vicholz/openald/README.md

# OpenALD v1.0

**OpenALD** is an open, rechargeable pocket FM radio: an ATmega328PB + RDA5807M (RRD-102 module) board that runs from one
18650 cell, charges and programs over a centred USB-C port, and lives in a 3D-printed 43 × 92 × 33.4 mm case. The repo also
holds an **Adafruit Feather RP2040 variant** built from off-the-shelf boards, and a **6-slot USB-C PD charging dock** that
fits both radios. Everything is KiCad 9 + OpenSCAD, generated by Python scripts.

> **Status: designed, CAD- and datasheet-checked, NOT built and NOT hardware-validated.** ERC/DRC, the JLC placement
> check and the 3D case-fit checks pass, but no board has been built, powered or programmed. The only firmware is the Feather variant's Arduino sketch, which compiles but has never run on hardware; the single board still has none.
> Treat the first build of each part as a prototype (see the bring-up checklist in [HANDOFF.md](HANDOFF.md#8-hardware-bring-up-test-checklist)).

**Picking this up later (person or AI)? Start with [HANDOFF.md](HANDOFF.md)**: full design history, decisions, hard
constraints, open TODOs, test checklist and exact regeneration commands.

| Folder | What it is | Status |
|---|---|---|
| [`radio_single_board/`](radio_single_board/README.md) | **OpenALD v1.0** single-board radio: ATmega328PB + RDA5807M, CH340K USB-C programming, TP4056 ~900 mA charging with DW01A/FS8205A protection and reverse-cell protection, thumbwheel (press = battery check), slide switch, centred vertical 3-LED level bar. 38 × 87 mm 2-layer PCB; case 43 × 92 × 33.4 mm | Designed; ERC/DRC/JLC-CPL/case fit pass; not built |
| [`charging_dock/`](charging_dock/README.md) | **OpenALD Dock v1.0**: 6 radios (2 × 3, 1 in apart) stand USB-C-down in 2 in pockets; one rear USB-C PD input (≥ 45 W charger, 15 V or 20 V); HUSB238 + 2 × SY8205 bucks + SY6280 limit per slot. 192 × 112 × 62.5 mm | Designed; ERC/DRC/JLC-CPL/fit pass; not built |
| [`radio_adafruit_feather_rp2040/`](radio_adafruit_feather_rp2040/README.md) | **OpenALD Feather RP2040 v1.0**: Feather RP2040 + RDA5807M breakout with jack + 18650 holder in a printed frame; **no PCB**: SIQ-02FVS3 wheel glued into a frame cradle, screwless SS-12F16 switch pressed into a groove in the case wall, frame clamped between the case halves, all hand-wired; same dock footprint at the base | Designed; fit check pass; FM-module dimensions are estimates; not built |

Dock ↔ radio mechanical contract: [`charging_dock/DOCK_INTERFACE.md`](charging_dock/DOCK_INTERFACE.md).

## Quick links
* Single-board radio: [Gerbers](radio_single_board/fab/openald-gerbers-jlcpcb.zip) · [JLC BOM](radio_single_board/fab/openald-BOM-jlcpcb.csv) · [JLC CPL](radio_single_board/fab/openald-CPL-jlcpcb.csv) · [human BOM](radio_single_board/fab/openald-BOM-human.csv) · [minimal (4-part) assembly set](radio_single_board/fab/minimal/) · [PCBWay BOM](radio_single_board/fab/openald-BOM-pcbway.xlsx) · [NextPCB BOM](radio_single_board/fab/openald-BOM-nextpcb.xls) · [schematic PDF](radio_single_board/docs/openald-schematic.pdf) · [case STLs](radio_single_board/case/)
* Dock: [Gerbers](charging_dock/fab/openald-dock-gerbers-jlcpcb.zip) · [JLC BOM](charging_dock/fab/openald-dock-BOM-jlcpcb.csv) · [JLC CPL](charging_dock/fab/openald-dock-CPL-jlcpcb.csv) · [human BOM](charging_dock/fab/openald-dock-BOM-human.csv) · [schematic PDF](charging_dock/docs/openald-dock-schematic.pdf) · [case STLs](charging_dock/case/)
* Feather variant: [BOM](radio_adafruit_feather_rp2040/docs/BOM.md) · [pin map](radio_adafruit_feather_rp2040/docs/pin_map.md) · [wiring diagram](radio_adafruit_feather_rp2040/docs/wiring_diagram.png) · [wiring schematic PDF](radio_adafruit_feather_rp2040/docs/wiring_schematic/openald-feather-wiring.pdf) · [firmware](radio_adafruit_feather_rp2040/firmware/) · [firmware notes](radio_adafruit_feather_rp2040/docs/firmware_notes.md) · [case STLs](radio_adafruit_feather_rp2040/case/stl/)
* Ready-made zip packages per subproject: GitHub Release **v1.0** assets (or build them with `tools/make_packages.sh`).

## How to order (JLCPCB)
**Board settings for every board:** 2 layers, **1.6 mm** FR-4, **1 oz** copper, any colour, HASL lead-free (or ENIG),
**PCB Assembly: Economic, top side**. Upload the gerber zip from the subproject's `fab/`, then the `*-BOM-jlcpcb.csv` and
`*-CPL-jlcpcb.csv`. Use the centroid `.csv` or `.pos` only if a site asks for those formats.

* **Check every part's rotation in JLC's placement preview before paying.** The CPLs already contain per-part EasyEDA
  origin/rotation corrections (`JLC_CORR`, verified by `jlc_cpl_fit.py --check`), so the preview should be right; JLC
  engineers sometimes re-rotate by hand.
* Single-board radio: U4 (RRD-102 module), BT1 (18650 holder) and J3 (ISP pads, do not fit) are hand-solder/DNP.
  SW1 (SK-12E12-G5) is THT: choose Standard PCBA to have JLC fit it, or deselect it and hand-solder (5 joints).
  If the ATmega328PB (C132230) is low/out of stock, use **ATmega328P-AU (C14877)**, a drop-in (pick the 328P variant in MiniCore).
* **Minimal assembly option** (you have hot air/hotplate): upload the same gerbers with
  `radio_single_board/fab/minimal/openald-BOM-jlcpcb-minimal.csv` + `openald-CPL-jlcpcb-minimal.csv`. JLC places only
  J1 (USB-C), U1 (TP4056), U3 (ATmega328PB) and U7 (CH340K); buy the rest from LCSC with
  `fab/minimal/openald-LCSC-order-handsolder.csv` (5 boards + labelled spares). Order a separate **frameless** stencil
  (~$3) if you want one for hand paste.
* Dock: the six vertical USB-C plugs J2–J7 (HX TYPE C-M 16P V-SMT, **LCSC C55200592, low stock**) are hand-soldered; buy 7.
* Other vendors (PCBWay/NextPCB) have filled BOM templates, but **the CPL/placement files contain JLC-specific
  corrections**; generate a clean placement file before using another assembler (see HANDOFF §6).
* Cost figures in the docs are **estimates from published price tables (2026-11-10/11)**, not quotes.

## How to regenerate / check
Tested with: **KiCad 9.0.2** (`kicad-cli` + `pcbnew` Python module), **OpenSCAD 2021.01**, **Python 3.13**,
Freerouting (2026-10 build, Java 21+; run with OpenJDK 25) for re-routing only. Python packages: see
[`requirements.txt`](requirements.txt) (`pcbnew` comes with KiCad, not pip).

```bash
pip install -r requirements.txt
tools/fetch_kicad3d.sh && export KICAD9_3DMODEL_DIR=$PWD/tools/kicad3d   # stock KiCad STEP models for the fit checks
tools/check_all.sh            # ERC + DRC + JLC CPL check for all three boards (non-destructive, ~10 s)
tools/check_all.sh --case     # + rebuild cases and run the 3D fit checks (slow; rewrites STLs/previews)
```
Per subproject (details and expected results in [HANDOFF.md §7](HANDOFF.md#7-regeneration-and-checks)):
* `radio_single_board/scripts/run_all_pcb.sh` (full schematic → board → **re-route** → DRC; needs Freerouting),
  `python3 scripts/make_fab.py` / `--minimal`, `python3 scripts/make_vendor_boms.py`, `scripts/build_case.sh`.
* `charging_dock/scripts/run_all_pcb.sh`, `python3 scripts/make_fab.py`, `scripts/build_case.sh`.
* `radio_adafruit_feather_rp2040/make_all.sh` (everything) or `case/build_case.sh` (case only).
* `OPENALD_OFFLINE=1` makes `make_fab.py` reuse the saved `fab/lcsc_lookup.json` prices instead of querying JLC's parts API.
* `FREEROUTING=/path/freerouting.jar` and `JAVA=/path/java` override the router location (default `tools/freerouting.jar`, not in git).
* `EASYEDA_CACHE` overrides the EasyEDA footprint cache used by `jlc_cpl_fit.py` (default: the committed `tools/easyeda/`).

## Directory map
```
README.md            this file            HANDOFF.md        full resume / handoff document
LICENSE              CC0 1.0 Universal    requirements.txt  Python deps
tools/               check_all.sh, fetch_kicad3d.sh, make_packages.sh, easyeda/ (EasyEDA footprint cache for jlc_cpl_fit)
radio_single_board/  kicad/ fab/ (gerbers, JLC BOM/CPL, centroid, .pos, vendor BOMs, minimal/) case/ previews/ docs/ scripts/
charging_dock/       kicad/ fab/ case/ (STLs, floor_pads/) previews/ docs/ scripts/ DOCK_INTERFACE.md
radio_adafruit_feather_rp2040/  case/ (stl/) previews/ docs/ scripts/ ref/ (Adafruit Eagle board, CC BY-SA) archive/ (retired PCB) make_all.sh
```

## License
Released into the public domain under **CC0 1.0 Universal** ([LICENSE](LICENSE)): hardware designs, scripts and docs.
Third-party reference files keep their own licenses (notably the Adafruit Feather RP2040 Eagle file in
`radio_adafruit_feather_rp2040/ref/`, CC BY-SA); see [HANDOFF.md §11](HANDOFF.md#11-license-and-third-party-files).
