vicholz/openald/charging_dock/README.md

# OpenALD Dock v1.0 — 6-slot USB-C charging dock

A charging dock for six OpenALD radios (2 rows × 3). Each radio stands USB-C-end down in a printed pocket that is
**2.00 in (50.8 mm) deep**, so the level-bar LEDs stay visible. A lead-in chamfer and a tight 0.35 mm guide zone at
the bottom centre the radio's USB-C receptacle on a vertical USB-C plug. **One USB-C PD input at the rear centre**
powers all six slots.

> **Status: design only, nothing here is hardware-validated.** ERC/DRC are clean and the CAD fit check passes, but no
> board has been built, no charger has been tested, and the plug height and insertion have not been measured on a
> real part. Treat the first build as a prototype.

Both radio variants fit the same pockets (`radio_single_board`, and `radio_adafruit_feather_rp2040` if it keeps the
lower envelope). The exact interface is in **[DOCK_INTERFACE.md](DOCK_INTERFACE.md)**.

**Plug depth (2026-11-12, still v1.0):** both radios now have their USB-C mouth **1.60 mm inside the bottom face** (the
Feather since commit 1452af8; the single board since its J1 moved 0.9 mm toward the board edge). The floor pads are
**4.00 mm** (were 3.10) and the PCB standoffs **4.1 mm** (were 5.0), so the plug goes **6.0 mm** past the mouth on both
radios (USB-C full seat 6.20 ± 0.20) while the outer size, the 50.8 mm pocket and the deck height stay the same. The
short-lived Feather riser shims (commit 0ba4451) are gone. Section view: `previews/dock_plug_insertion_per_radio.png`.
**Radios built before this change** (single board with J1 flush to the board edge, mouth 2.50) would only get 5.1 mm in this dock.

## Key numbers
| | |
|---|---|
| Outer size | **191.8 × 111.7 × 62.5 mm** (W × D × H) |
| Spacing | **25.4 mm (1.0 in)** between radios, in both X and Y |
| Pocket | 50.8 deep; 0.35 mm/side clearance for the bottom 12 mm, 0.60 above; 3 mm 45° lead-in; power-switch knob relief slot in the right wall |
| PCB | 186.0 × 105.9 mm, 2-layer, 1.6 mm, all SMT parts on top |
| Minimum charger | **USB-C PD, 45 W: must offer 20 V ≥ 2.25 A or 15 V ≥ 3 A** |
| Per-slot limit | ~1.45 A (1.09–1.81 A, SY6280 ±25 %), 5.10 V |
| Print bed | needs ≥ 192 × 112 mm for the top shell (fits 220 × 220 beds; not an A1 mini) |

## Power architecture
```
USB-C IN (J1, HRO TYPE-C-31-M-12, CC1/CC2 -> HUSB238)
  -> F1 4 A fuse (0466004.NRHF) -> D1 SMBJ22A TVS -> C1 10 uF 50 V
  -> Q1 AO4407A P-FET input switch (gate: R2 100k / R3 47k / C3 4.7 nF soft turn-on, driven by HUSB238 GATE; opens on OVP)
  -> VIN_SW, C4 100 uF 35 V
     -> U2 SY8205FCC buck A (4.7 uH MWSA0604S, 3x22 uF + 470 uF, 75k/10k -> 5.10 V) -> slots 1, 2, 4
     -> U3 SY8205FCC buck B (same)                                                   -> slots 3, 5, 6
        each slot: SY6280AAC current-limited switch (Rset 4.7k -> ~1.45 A) + 10 uF -> vertical plug VBUS,
        22k Rp on CC ("default USB power" to the radio's 5.1k Rd), plug GND + shell to GND
Status LED (light pipe in the deck between the centre pockets): green = 5 V up; red = input present but no usable PD
```
* **HUSB238** (VSET open = request up to 20 V, ISET 13.7k = 2.25 A) picks the highest PDO ≤ 20 V that offers ≥ 2.25 A,
  otherwise it steps down. D+/D− are left open (PD only).
* **Buck enable threshold:** EN divider 100k/12k from VIN_SW. The bucks turn on at 11.2–13.1 V (typ. 12.1 V). **5 V and
  9 V never enable them** (non-PD or 5 V-only chargers are safe: the dock stays off with the red LED lit). 15 V and
  20 V always enable them. **12 V-only chargers are not supported** (they may or may not start).
* Worst-case load is 6 × ~0.95 A × 5.1 V ≈ 29 W. At 20 V/2.25 A (45 W) there is about 35 % headroom after converter
  losses. Each buck is rated 5 A and carries ≤ 3 radios.

| Part | LCSC | Stock (2026-11-11 PST) | Unit |
|---|---|---|---|
| HUSB238_002DD PD sink | C7471904 | 17,771 | $0.47 |
| SY8205FCC buck ×2 | C111875 | 10,557 | $0.34 |
| SY6280AAC slot switch ×6 | C55136 | 97,877 | $0.09 |
| AO4407A input P-FET | C16072 | 19,166 | $0.33 |
| MWSA0604S-4R7MT 4.7 µH 7 A ×2 | C408457 | 8,136 | $0.17 |
| 0466004.NRHF 4 A fuse | C187596 | 14,764 | $0.08 |
| SMBJ22A TVS | C151920 | 7,664 | $0.07 |
| 100 µF 35 V / 470 µF 10 V electrolytic | C2895269 / C2858856 | 5,149 / 138,705 | $0.12 / $0.05 |
| HRO TYPE-C-31-M-12 input receptacle | C165948 | 281,637 | $0.19 |
| HX TYPE C-M 16P V-SMT vertical plug ×6 (hand solder) | C55200592 | **782** | $0.54 |

The full list is in `fab/openald-dock-BOM-human.csv` (live stock and price); `fab/cost_estimate.txt` has the cost estimate.

## Files
| Path | What |
|---|---|
| `kicad/openald-dock.kicad_{pro,sch,pcb}` | KiCad 9 project (schematic and board are generated by the scripts) |
| `fab/openald-dock-gerbers-jlcpcb.zip` | Gerbers + drill (JLCPCB) |
| `fab/openald-dock-BOM-jlcpcb.csv`, `fab/openald-dock-CPL-jlcpcb.csv` | JLC assembly BOM + CPL (JLC_CORR rotation/offset corrections applied) |
| `fab/openald-dock-centroid.csv`, `fab/openald-dock.pos` | Centroid / KiCad position files |
| `fab/openald-dock-BOM-human.csv`, `fab/cost_estimate.txt`, `fab/lcsc_lookup.json` | Human BOM with live stock and prices, cost estimate |
| `fab/erc_report.txt`, `fab/drc_report.txt`, `fab/jlc_cpl_fit.json` | Check reports |
| `case/openald_dock.scad`, `case/dock_params.scad` | OpenSCAD case (parameters generated from the PCB layout) |
| `case/dock_top_shell.stl`, `case/dock_base.stl`, `case/dock_floor_pads_x6.stl`, `case/floor_pads/*.stl` | Print-ready STLs (already in print orientation) |
| `case/dock_fit_report.txt` | Fit-check result |
| `docs/openald-dock-schematic.pdf`, `previews/*.png` | Schematic PDF, PCB/case renders, CPL overlay plots |
| `scripts/` | Generators: `run_all_pcb.sh` (symbols → schematic → ERC → board → route → post-route → DRC), `make_fab.py`, `jlc_cpl_fit.py`, `build_case.sh`, `check_dock_fit.py`, `render_pcb_previews.py`; `geom.py` is the single source of the geometry |

## Checks (2026-11-11)
* **ERC:** 0 errors, 0 warnings.
* **DRC:** 0 errors, **0 unconnected**. 75 silkscreen-only warnings (reference text overlapping copper, other silk or the board edge; cosmetic).
* **JLC placement:** `jlc_cpl_fit.py --check` → *correction table: OK*. All 80 CPL rows match the EasyEDA footprints' pads; worst pad-centre offset is 0.29 mm (SY8205 land-length difference). Overlays are in `previews/cpl_overlay_*.png`.
* **Case fit:** `case/dock_fit_report.txt` → **INTERFERENCES: 0**. This covers radio envelopes vs. shell/pads/base, plugs vs. case and radios (the plug sits inside the USB-C cavity), the PCB with its holes vs. every case part, every PCB part vs. every case part, and the case parts against each other. The closest part to the shell is the D3 LED, 0.19 mm under the light pipe. Insertion is 6.0 mm. The report lists the insertion per radio (6.00 / 6.00) and the Z stack.

## Printing (no supports)
* **Top shell:** print it deck-down, as exported. Walls, bosses, the light pipe and the pocket tubes grow straight up. The lead-in chamfers are 45°. Vent slots and the rear USB-C opening bridge ≤ 13 mm.
* **Base:** print it flat, as exported.
* **Floor pads (6):** print them top-face down, as exported (pegs up). Slot 5 (back centre) has its own STL with a relief over the rear USB-C receptacle's pads. The pads are interchangeable otherwise, but `floor_pads/` has one file per slot.
* PETG or PLA, 0.2 mm layers, 3 walls. Check the pocket guide on one radio before printing all six pads. If the fit is tight, the guide clearance is `CLR_GUIDE` in `scripts/geom.py`.

## Assembly
1. **Order the PCB** with JLC SMT assembly (gerber zip + BOM + CPL). The six vertical plugs J2–J7 are **not** in the JLC BOM, because LCSC has no EasyEDA footprint for C55200592 and JLC cannot verify its placement. Buy 6 (+1 spare) from LCSC and hand-solder them. They are 16 fine-pitch (0.8 mm) SMD pads plus 2 plated shell slots: use flux, a fine tip or hot air, and keep each plug **vertical** (a printed floor pad slipped over it works as a jig).
2. **Test before docking a radio:** plug in a ≥ 45 W PD charger. Green should light and red should stay off. Each slot should read 5.0–5.2 V on VBUS. A 5 V-only charger should give red only, with no slot voltage.
3. Press 6 M3 heat-set inserts into the shell bosses. Lay the PCB on the base standoffs and drop the six floor pads in (the pegs go into the PCB holes). Lower the shell over everything and fit 6 × **M3 × 10** screws from below (the standoffs are 4.1 mm since 2026-11-12; M3 × 12 would bottom out in the 6.5 mm insert holes).
4. Dock a radio front face (level-bar side) toward you, wheel to the right.

## Open risks and judgment calls
* **Plug height and insertion are not measured.** The HX drawing gives 11.60 (used here, 6.0 mm insertion) but also a 12.50 overall (possibly including the shell tabs that go through the board; not confirmed). Measure a soldered plug from the PCB top. If it is taller, the radios would stand on the plug: make `PAD_T` thicker and `STANDOFF` thinner by the difference in `scripts/geom.py` and rebuild (shorter screws again).
* **Receptacle depth:** the real seat depth of the HRO and CUI receptacles isn't on their drawings; 6.20 ± 0.20 is the USB-C spec value. Both radios must keep the 1.60 mm mouth; an older single board (mouth 2.50) only gets 5.1 mm.
* **Hand-soldered plugs:** fine pitch, and the plug must be perpendicular. The 0.35 mm guide clearance plus the case opening tolerate only ~0.5 mm of plug misalignment.
* **Plug supply:** only 782 in stock at LCSC, and it is the only in-stock vertical (board-mount, plug-up) USB-C plug found with a usable drawing. Buy spares early.
* **12 V fallback:** 12 V-only chargers are deliberately not supported. A 30 W charger that offers 12 V/2.5 A may or may not start the dock and could overload with six radios charging.
* **Autorouted power layout:** routing is Freerouting plus scripted widening of the high-current tracks (up to 2 mm) and GND pours on both layers. Review the buck hot loops (C11/C12 → U2/U3 → GND) in `previews/pcb_copper_*.png` before ordering.
* **Heat:** six radios charging inside 2 in pockets. Each pocket wall has vent slots into the open channels, and the deck and base are vented, but there is no fan. Watch radio temperature on the first full charge.
* **Viewing angle:** the single-board radio's level bar is centred on its front face, its three windows 27.0 / 29.8 / 32.6 mm above the rim (2026-11-11 update; see `DOCK_INTERFACE.md` §1). The back-row bars are best read from above or from the front at a downward angle.
* **While docked:** the radio's own TP4056 charge LEDs (D3/D4, near the USB end) are hidden. Charging is shown on the level bar by firmware (it reads CHRG_SENSE). The power switch is not reachable while docked; the relief slot in the right wall only clears the knob so it isn't flipped by insertion.
* **Layout margins:** the back margin is 13.5 mm (instead of 6) to fit the rear USB-C receptacle behind the back-centre pocket. The 25.4 mm spacing leaves channels wide enough for the electronics.
* **Not validated:** HUSB238 negotiation, buck stability with the chosen compensation (internal), SY6280 limits, thermals and plug mating are all untested.

## History
* v1.0 (2026-11-11): first design. The project was renamed from OpenALS to OpenALD before release, so the dock was born as "OpenALD Dock v1.0".
