vicholz/openald/charging_dock/case/dock_fit_report.txt

ok   radios x shell_raw                             0.000 mm^3
ok   plugs x shell_raw                              0.000 mm^3
ok   PCB x shell_raw                                0.000 mm^3
ok   radios x base_raw                              0.000 mm^3
ok   plugs x base_raw                               0.000 mm^3
ok   PCB x base_raw                                 0.000 mm^3
ok   radios x pads_raw                              0.000 mm^3
ok   plugs x pads_raw                               0.000 mm^3
ok   PCB x pads_raw                                 0.000 mm^3
ok   plugs x radios (plug inside USB-C cavity)      0.000 mm^3
ok   shell x pads                                   0.000 mm^3
ok   shell x base                                   0.000 mm^3
ok   pads x base                                    0.000 mm^3
closest PCB part to the top shell: D3 at 0.19 mm (part boxes)
insertion past the receptacle mouth: 6.00 mm (plug top Z 19.30, radio floor Z 11.70)
  single_board receptacle mouth 1.60 inside the bottom face -> insertion 6.00 mm
  feather      receptacle mouth 1.60 inside the bottom face -> insertion 6.00 mm
  USB-C full seat (spec effective receptacle shell) 6.20 +/- 0.20; design target 6.00
Z stack: base 2.0, standoff 4.1, PCB 6.10..7.70, pad 4.00 -> floor 11.70, plug top 19.30, deck 62.50
radio-to-guide clearance 0.35/side for 12 mm, 0.60/side above; pocket depth 50.8
outer size 191.8 x 111.72 x 62.5 mm; radio gap 25.4 mm
INTERFERENCES: 0
