vicholz/openald/radio_single_board/case/case_fit_report.txt

BT1   x   8.55.. 29.45  y   8.43.. 86.13  z -19.09..  3.12
C1    x  32.98.. 34.23  y   8.40.. 10.40  z   1.59..  2.85
C10   x  18.80.. 20.40  y  65.40.. 68.60  z   1.59..  3.19
C11   x  21.80.. 23.40  y  65.40.. 68.60  z   1.59..  3.19
C12   x   3.80..  4.60  y  77.60.. 79.20  z   1.59..  2.40
C13   x  17.80.. 19.40  y  38.90.. 39.70  z   1.59..  2.40
C14   x  17.80.. 19.40  y  40.60.. 41.40  z   1.59..  2.40
C15   x  33.20.. 34.00  y  12.30.. 13.90  z   1.59..  2.40
C16   x  25.40.. 26.20  y  11.60.. 13.20  z   1.59..  2.40
C17   x  23.90.. 24.70  y  21.60.. 23.20  z   1.59..  2.40
C18   x  29.80.. 30.60  y  21.60.. 23.20  z   1.59..  2.40
C19   x   7.90..  8.70  y  48.80.. 50.40  z   1.59..  2.40
C2    x   7.00..  9.00  y  19.77.. 21.02  z   1.59..  2.85
C3    x  32.60.. 34.20  y  73.70.. 74.50  z   1.59..  2.40
C4    x  18.80.. 19.60  y  35.70.. 37.30  z   1.59..  2.40
C5    x  24.40.. 25.20  y  35.70.. 37.30  z   1.59..  2.40
C6    x  17.80.. 19.40  y  42.30.. 43.10  z   1.59..  2.40
C7    x   4.80..  5.60  y  40.70.. 42.30  z   1.59..  2.40
C8    x   4.60..  6.60  y  54.58.. 55.83  z   1.59..  2.85
C9    x   8.40.. 10.00  y  55.00.. 55.80  z   1.59..  2.40
D1    x  18.20.. 19.80  y  72.60.. 73.40  z   1.59..  2.69
D10   x  26.10.. 29.90  y  29.90.. 31.50  z   1.59..  2.85
D2    x  20.10.. 23.90  y  29.70.. 31.30  z   1.59..  2.85
D3    x   6.60..  8.20  y   4.80..  5.60  z   1.59..  2.69
D4    x  10.60.. 12.20  y   4.80..  5.60  z   1.59..  2.69
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
ASSEMBLY SW1   reaches past the inner wall (x 38.50..43.30 y 20.00..23.50 z 3.85..6.35): top half lowers past it: OK
ASSEMBLY SW3   reaches past the inner wall (x 38.50..40.85 y 55.70..66.30 z 3.60..5.60): top half lowers past it: OK
INTERFERENCES: 0
