vicholz/openald/radio_single_board/fab/drc_report.txt

** Drc report for openald.kicad_pcb **
** Created on 2026-11-12T17:15:41-0800 **

** Found 62 DRC violations **
[silk_edge_clearance]: Silkscreen clipped by board edge
    Rule: board setup constraints silk; warning
    @(103.0000 mm, 100.0000 mm): Segment on Edge.Cuts
    @(108.8800 mm, 101.9300 mm): Segment of J2 on F.Silkscreen
[silk_edge_clearance]: Silkscreen clipped by board edge
    Rule: board setup constraints silk; warning
    @(103.0000 mm, 100.0000 mm): Segment on Edge.Cuts
    @(114.1200 mm, 99.9300 mm): Segment of J2 on F.Silkscreen
[silk_edge_clearance]: Silkscreen clipped by board edge
    Rule: board setup constraints silk; warning
    @(103.0000 mm, 103.0000 mm): Arc on Edge.Cuts
    @(103.2000 mm, 100.0500 mm): Reference field of H1
[silk_edge_clearance]: Silkscreen clipped by board edge
    Rule: board setup constraints silk; warning
    @(135.0000 mm, 103.0000 mm): Arc on Edge.Cuts
    @(134.8000 mm, 100.0500 mm): Reference field of H2
[silk_edge_clearance]: Silkscreen clipped by board edge
    Rule: board setup constraints silk; warning
    @(135.0000 mm, 187.0000 mm): Segment on Edge.Cuts
    @(114.3000 mm, 186.2500 mm): Segment of J1 on F.Silkscreen
[silk_edge_clearance]: Silkscreen clipped by board edge
    Rule: board setup constraints silk; warning
    @(135.0000 mm, 187.0000 mm): Segment on Edge.Cuts
    @(123.7000 mm, 186.2500 mm): Segment of J1 on F.Silkscreen
[silk_edge_clearance]: Silkscreen clipped by board edge
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
[silk_overlap]: Silkscreen overlap
    Rule: board setup constraints silk; warning
    @(108.8100 mm, 137.5406 mm): Segment of C19 on F.Silkscreen
    @(108.5700 mm, 137.4000 mm): Reference field of R10

** Found 0 unconnected pads **

** Found 0 Footprint errors **

** End of Report **
