vicholz/openald/radio_single_board/fab/erc_report.txt

ERC report (2026-11-12T17:15:00-0800, Encoding UTF8)

***** Sheet /
[pin_to_pin]: Pins of type Bidirectional and Power output are connected
    ; warning
    @(25.40 mm, 248.92 mm): Symbol U3 Pin 3 [PE0, Bidirectional, Line]
    @(172.72 mm, 267.97 mm): Symbol #FLG01 Pin 1 [Power output, Line]
[pin_to_pin]: Pins of type Bidirectional and Power output are connected
    ; warning
    @(25.40 mm, 251.46 mm): Symbol U3 Pin 6 [PE1, Bidirectional, Line]
    @(320.04 mm, 215.90 mm): Symbol U6 Pin 2 [VO, Power output, Line]

 ** ERC messages: 2  Errors 0  Warnings 2
