vicholz/openald/charging_dock/fab/drc_report.txt

** Drc report for openald-dock.kicad_pcb **
** Created on 2026-11-11T20:55:39-0800 **

** Found 75 DRC violations **
[silk_edge_clearance]: Silkscreen clipped by board edge
    Rule: board setup constraints silk; warning
    @(102.0000 mm, 100.0000 mm): Segment on Edge.Cuts
    @(188.3000 mm, 101.6500 mm): Segment of J1 on F.Silkscreen
[silk_edge_clearance]: Silkscreen clipped by board edge
    Rule: board setup constraints silk; warning
    @(102.0000 mm, 100.0000 mm): Segment on Edge.Cuts
    @(197.7000 mm, 101.6500 mm): Segment of J1 on F.Silkscreen
[silk_over_copper]: Silkscreen clipped by solder mask
    Local override; warning
    @(192.3700 mm, 156.7100 mm): Reference field of D3
[silk_over_copper]: Silkscreen clipped by solder mask
    Local override; warning
    @(228.7700 mm, 136.6000 mm): Reference field of C40
[silk_over_copper]: Silkscreen clipped by solder mask
    Local override; warning
    @(163.5700 mm, 136.6000 mm): Reference field of R12
[silk_over_copper]: Silkscreen clipped by solder mask
    Local override; warning
    @(127.8000 mm, 163.1700 mm): Reference field of R61
[silk_over_copper]: Silkscreen clipped by solder mask
    Local override; warning
    @(225.5700 mm, 136.6000 mm): Reference field of R33
[silk_over_copper]: Silkscreen clipped by solder mask
    Local override; warning
    @(231.9700 mm, 136.6000 mm): Reference field of R32
[silk_over_copper]: Silkscreen clipped by solder mask
    Local override; warning
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
    @(124.3627 mm, 149.3225 mm): Segment of R54 on F.Silkscreen
    @(124.6000 mm, 149.0000 mm): Reference field of U7
[silk_overlap]: Silkscreen overlap
    Rule: board setup constraints silk; warning
    @(157.1700 mm, 136.6000 mm): Reference field of R13
    @(157.5100 mm, 136.7406 mm): Segment of C15 on F.Silkscreen
[silk_overlap]: Silkscreen overlap
    Rule: board setup constraints silk; warning
    @(153.7350 mm, 139.6613 mm): Segment of C17 on F.Silkscreen
    @(153.5200 mm, 139.4000 mm): Reference field of C18
[silk_overlap]: Silkscreen overlap
    Rule: board setup constraints silk; warning
    @(158.7700 mm, 136.6000 mm): Reference field of R14
    @(159.1225 mm, 136.8373 mm): Segment of R13 on F.Silkscreen
[silk_overlap]: Silkscreen overlap
    Rule: board setup constraints silk; warning
    @(160.3700 mm, 136.6000 mm): Reference field of C20
    @(161.4000 mm, 137.8500 mm): Reference field of C19
[silk_overlap]: Silkscreen overlap
    Rule: board setup constraints silk; warning
    @(160.3700 mm, 136.6000 mm): Reference field of C20
    @(160.7225 mm, 136.8373 mm): Segment of R14 on F.Silkscreen

** Found 0 unconnected pads **

** Found 0 Footprint errors **

** End of Report **
