vicholz/openald/charging_dock/previews/cpl_overlay_J1.png

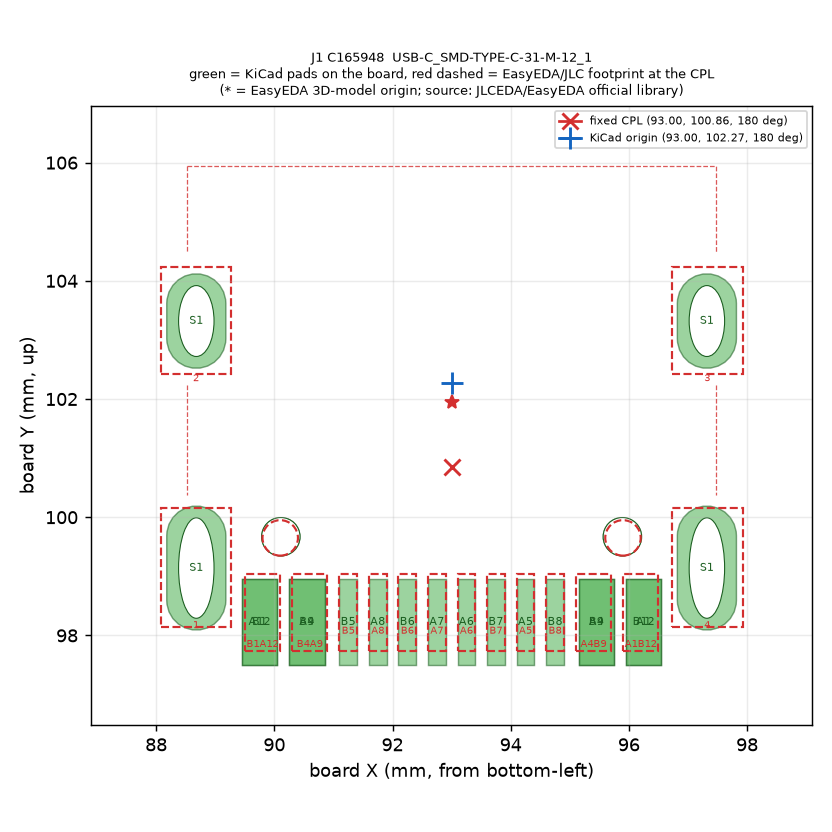
charging_dock/previews/cpl_overlay_J1.png
