vicholz/openald/charging_dock/previews/cpl_overlay_Q1.png

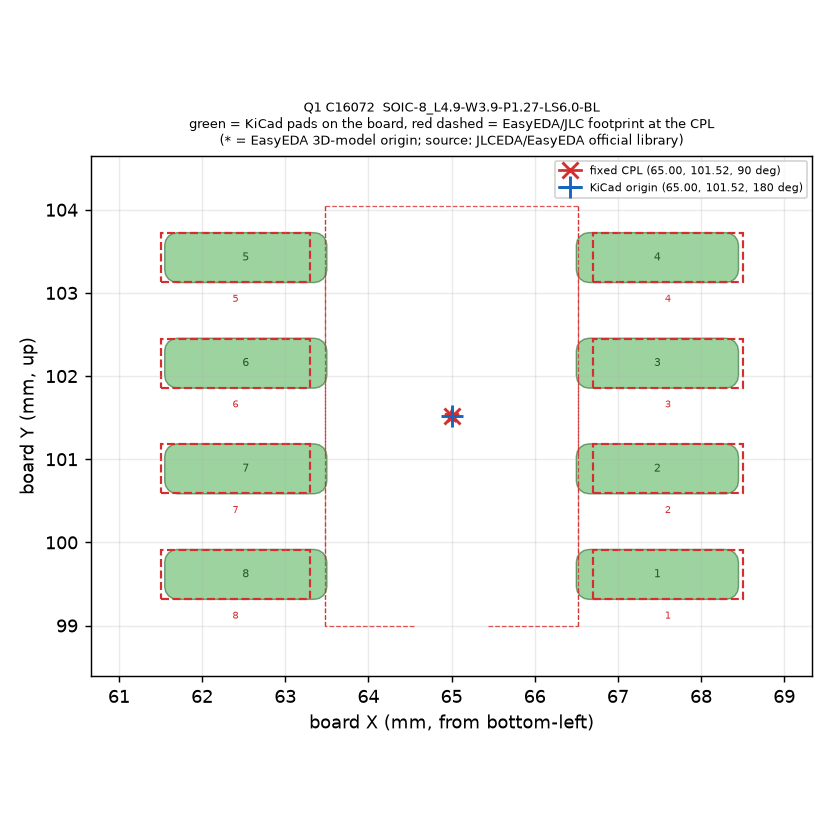
charging_dock/previews/cpl_overlay_Q1.png
