vicholz/openald/charging_dock/previews/cpl_overlay_Q2.png

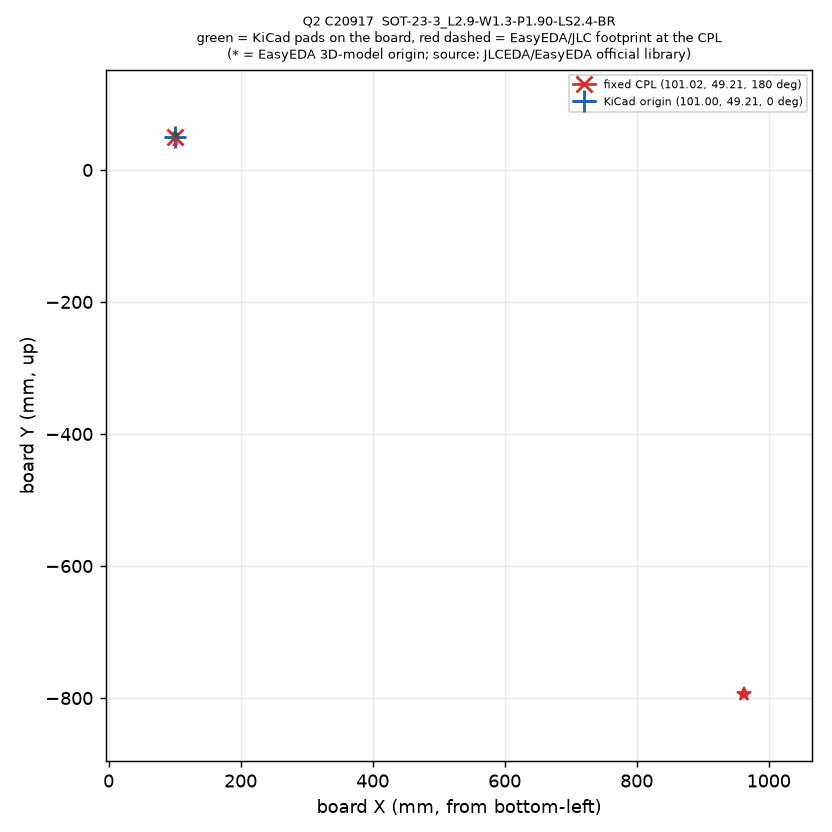
charging_dock/previews/cpl_overlay_Q2.png
