vicholz/openald/charging_dock/previews/cpl_overlay_U1.png

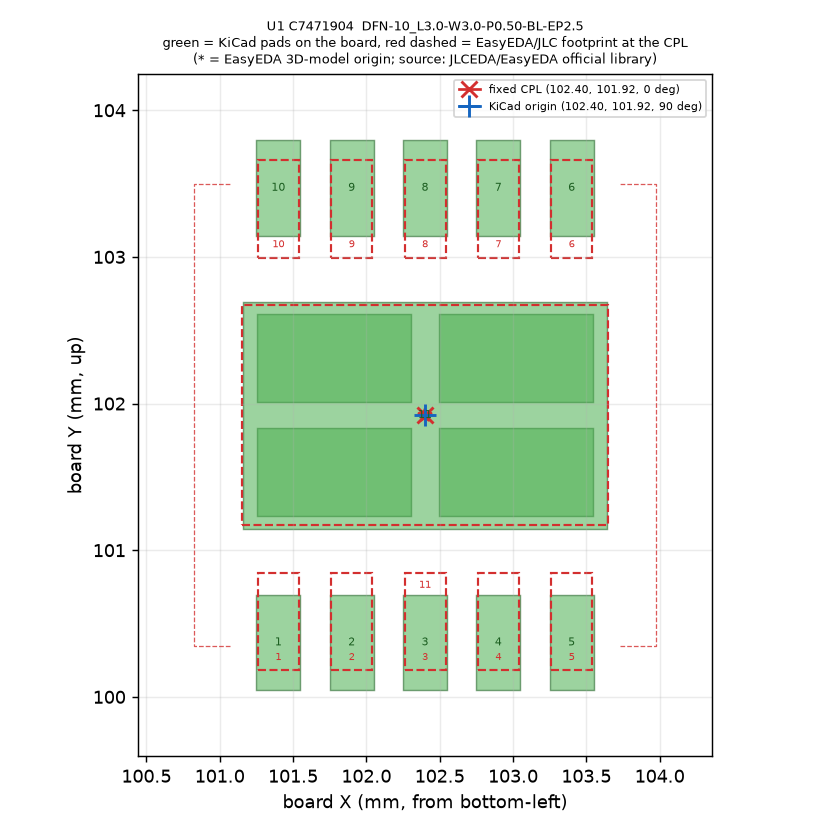
charging_dock/previews/cpl_overlay_U1.png
