vicholz/openald/charging_dock/previews/cpl_overlay_U2.png

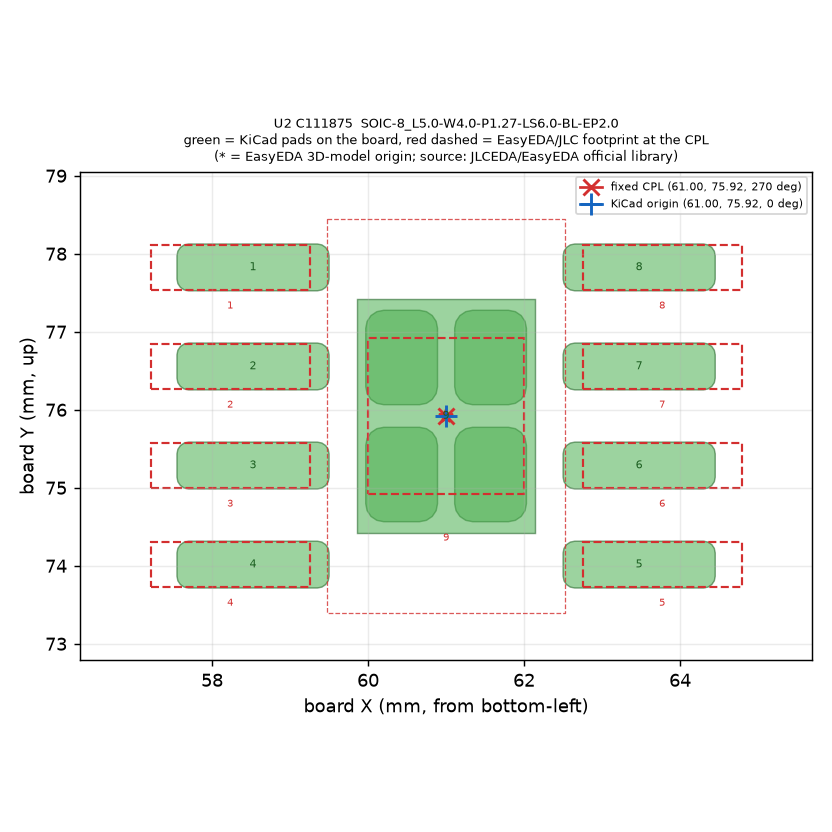
charging_dock/previews/cpl_overlay_U2.png
