vicholz/openald/charging_dock/previews/cpl_overlay_U4.png

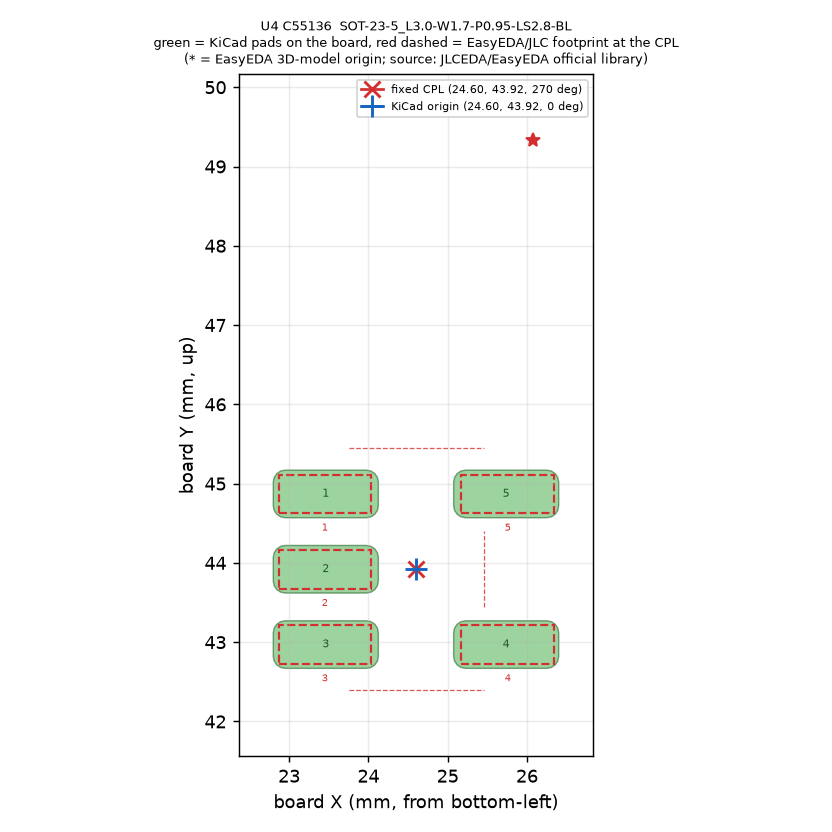
charging_dock/previews/cpl_overlay_U4.png
