vicholz/openald/charging_dock/previews/dock_exploded.png

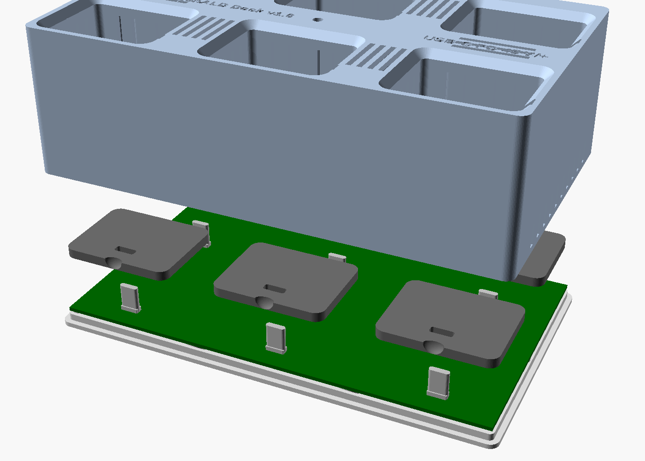
charging_dock/previews/dock_exploded.png
