vicholz/openald/charging_dock/previews/dock_plug_insertion_per_radio.png

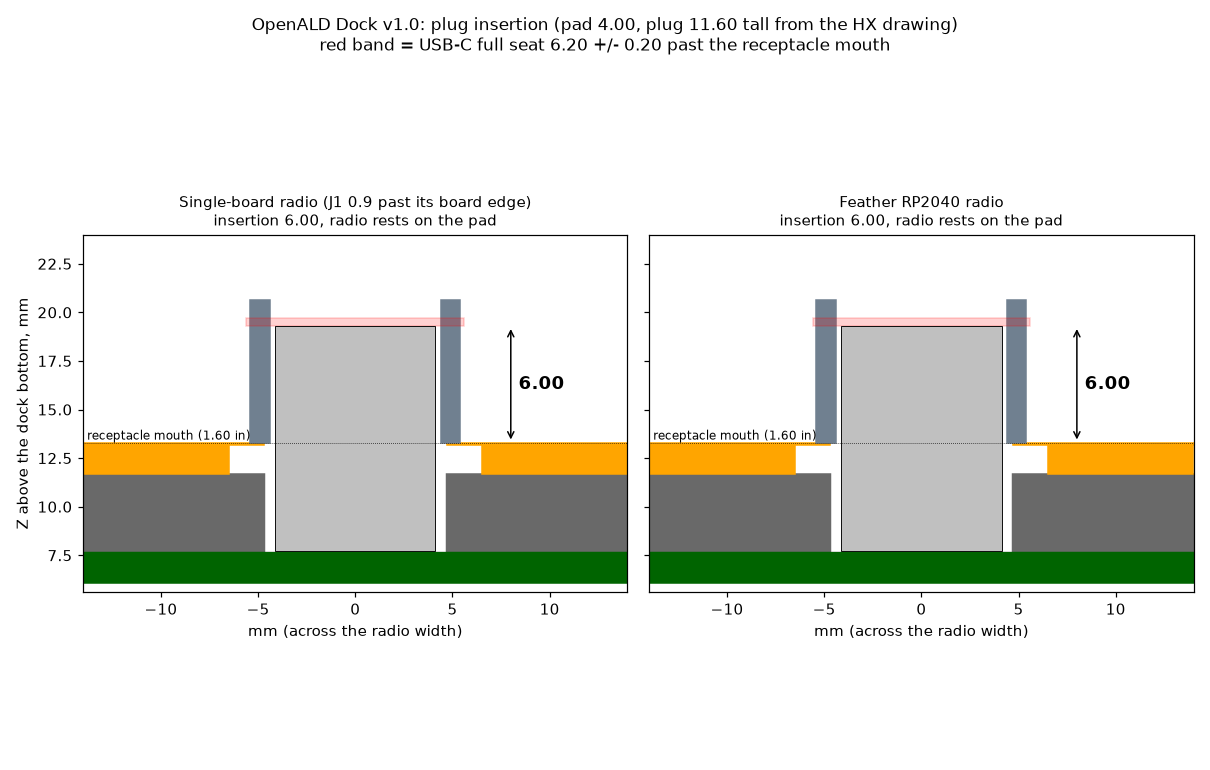
charging_dock/previews/dock_plug_insertion_per_radio.png
