vicholz/openald/charging_dock/previews/dock_section_centre_column.png

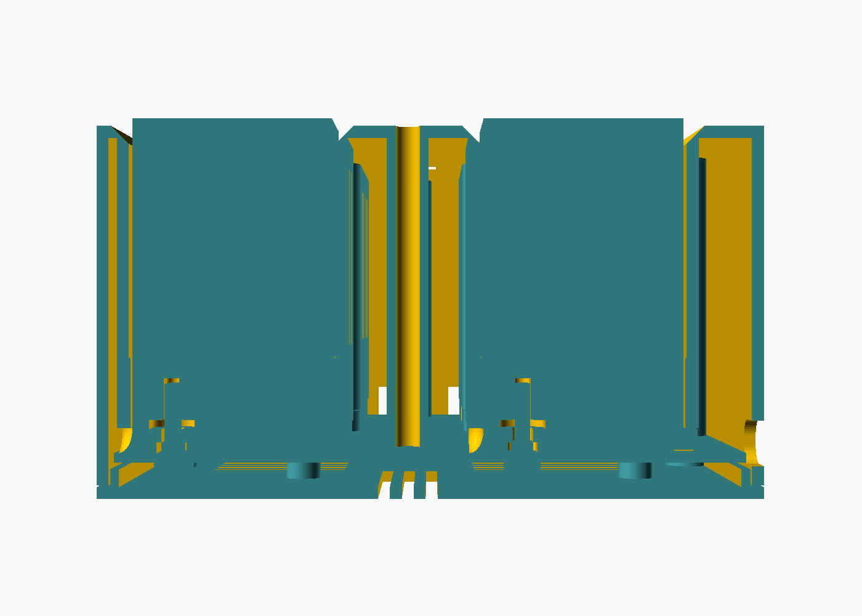
charging_dock/previews/dock_section_centre_column.png
