vicholz/openald/charging_dock/previews/pcb_bottom.png

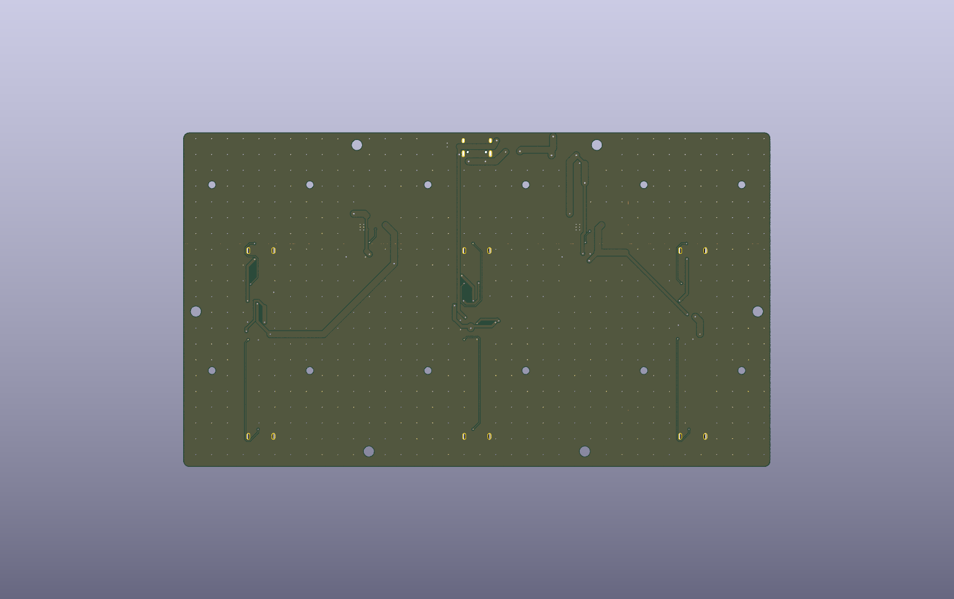
charging_dock/previews/pcb_bottom.png
