vicholz/openald/charging_dock/previews/pcb_copper_bottom.png

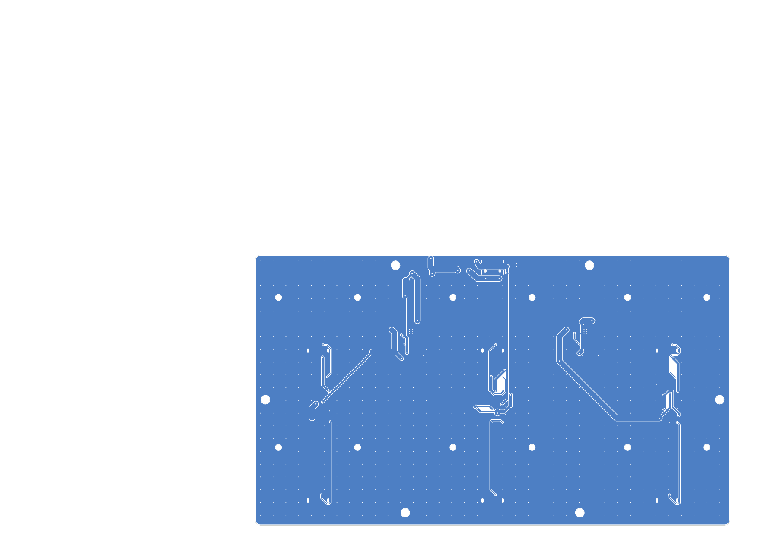
charging_dock/previews/pcb_copper_bottom.png
