vicholz/openald/charging_dock/previews/pcb_copper_top.png

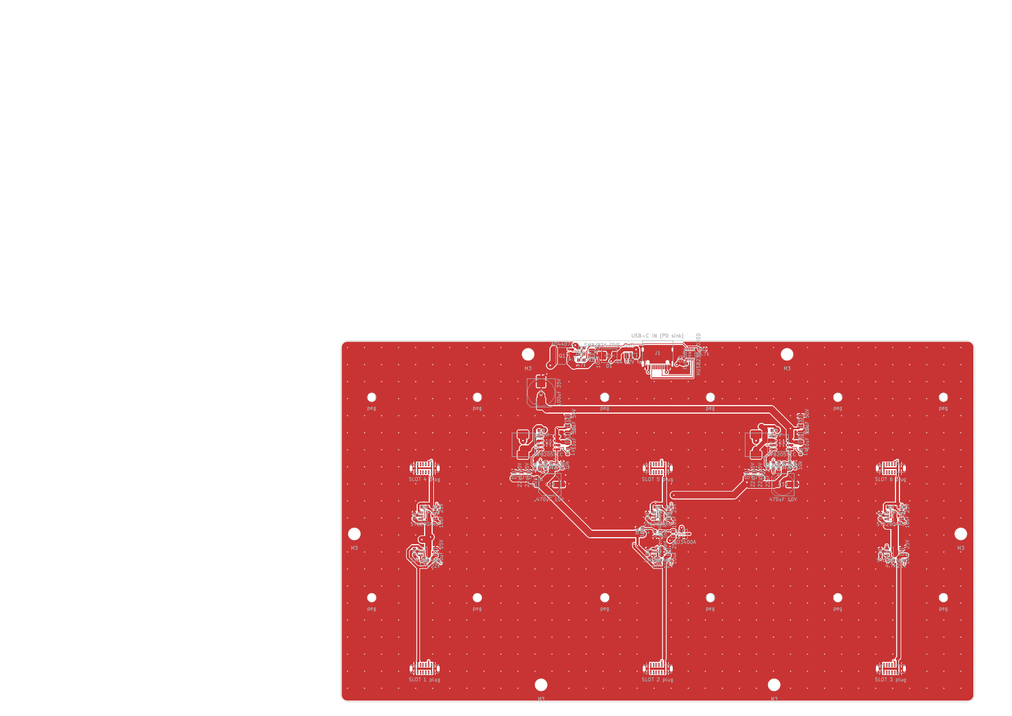
charging_dock/previews/pcb_copper_top.png
