vicholz/openald/charging_dock/previews/pcb_top.png

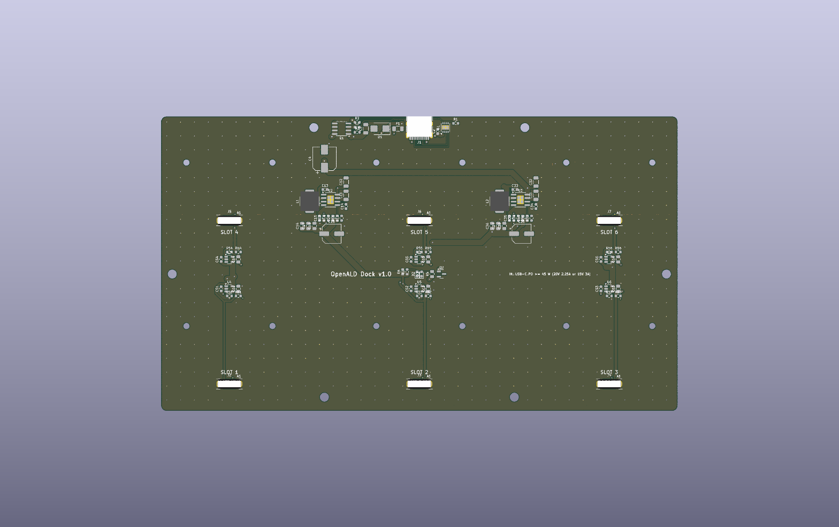
charging_dock/previews/pcb_top.png
