vicholz/openald/charging_dock/previews/schematic.png

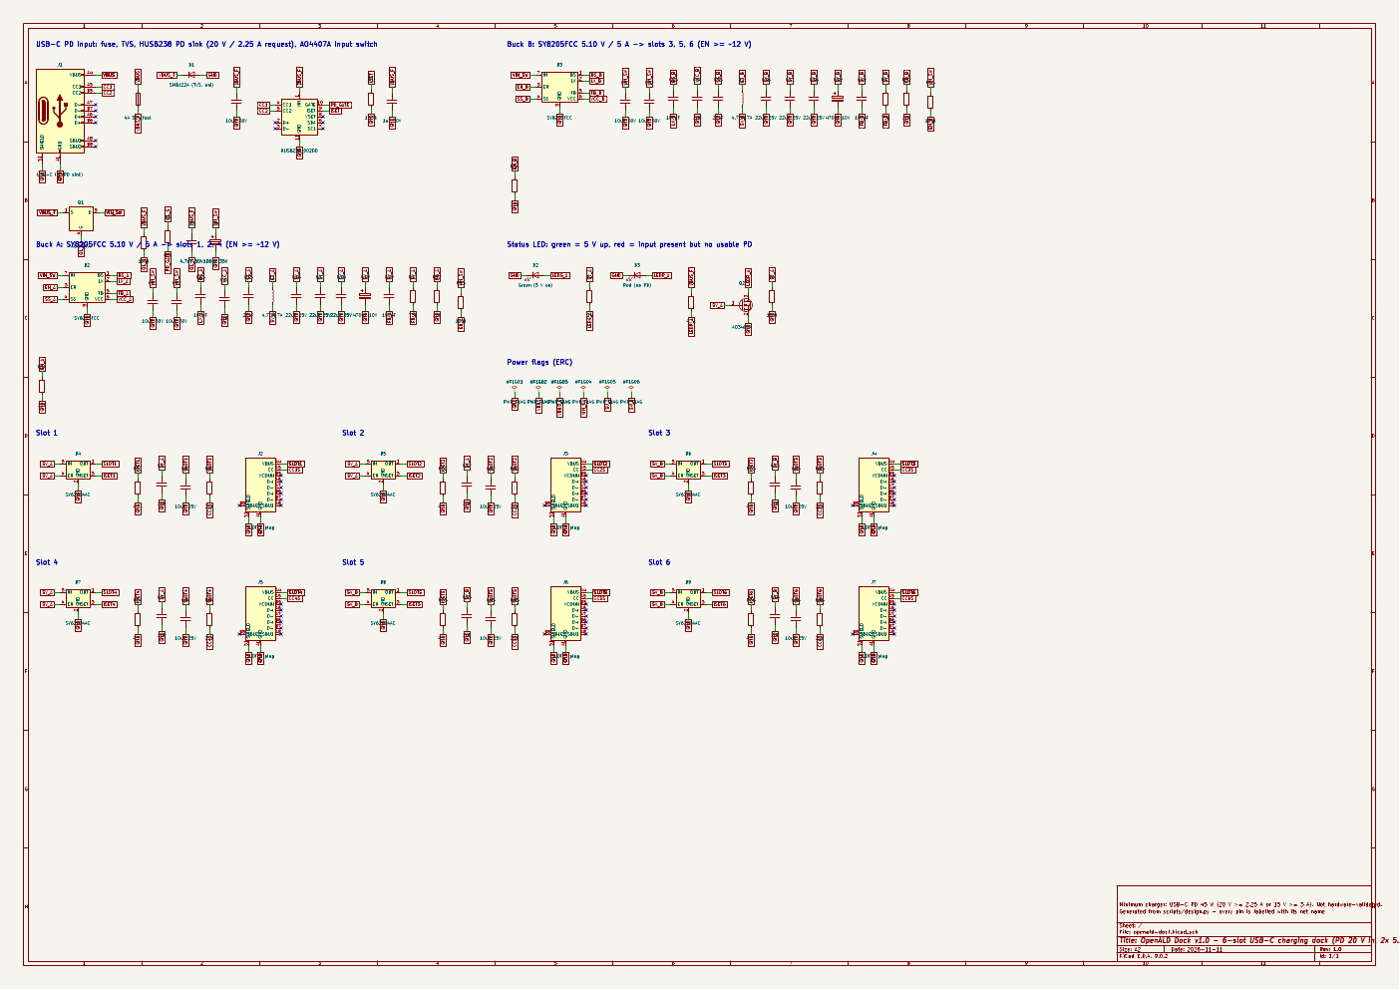
charging_dock/previews/schematic.png
