vicholz/openald/radio_adafruit_feather_rp2040/previews/case_closed.png

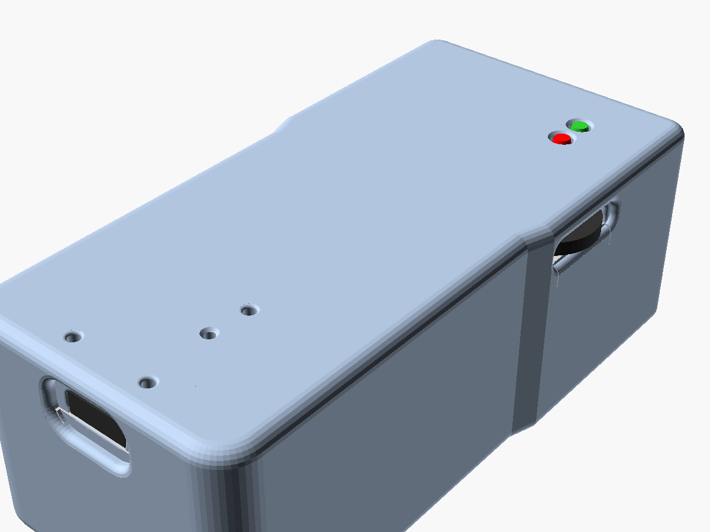
radio_adafruit_feather_rp2040/previews/case_closed.png
