vicholz/openald/radio_adafruit_feather_rp2040/previews/closeup_switch_left.png

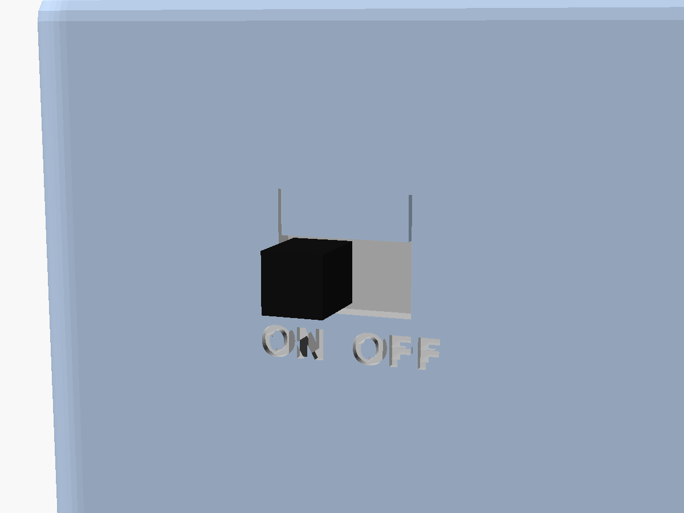
radio_adafruit_feather_rp2040/previews/closeup_switch_left.png
