vicholz/openald/radio_adafruit_feather_rp2040/previews/closeup_top_led_windows.png

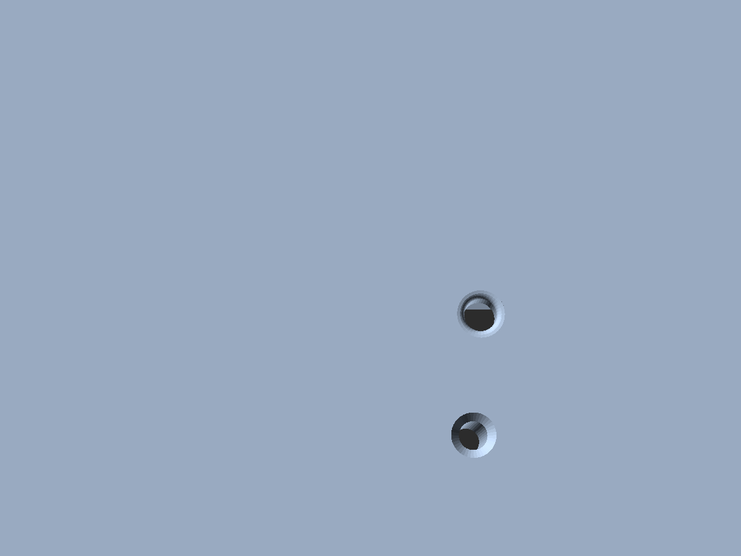
radio_adafruit_feather_rp2040/previews/closeup_top_led_windows.png
