vicholz/openald/radio_adafruit_feather_rp2040/previews/closeup_usb_recess.png

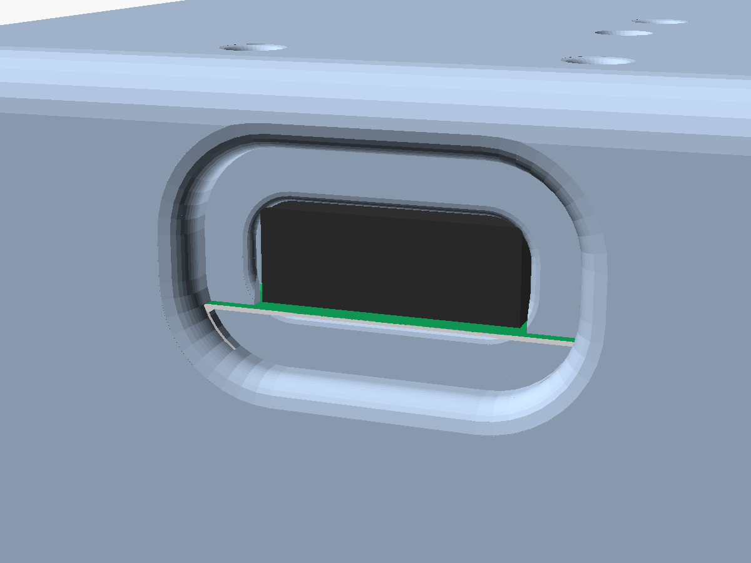
radio_adafruit_feather_rp2040/previews/closeup_usb_recess.png
