vicholz/openald/radio_adafruit_feather_rp2040/previews/closeup_wheel.png

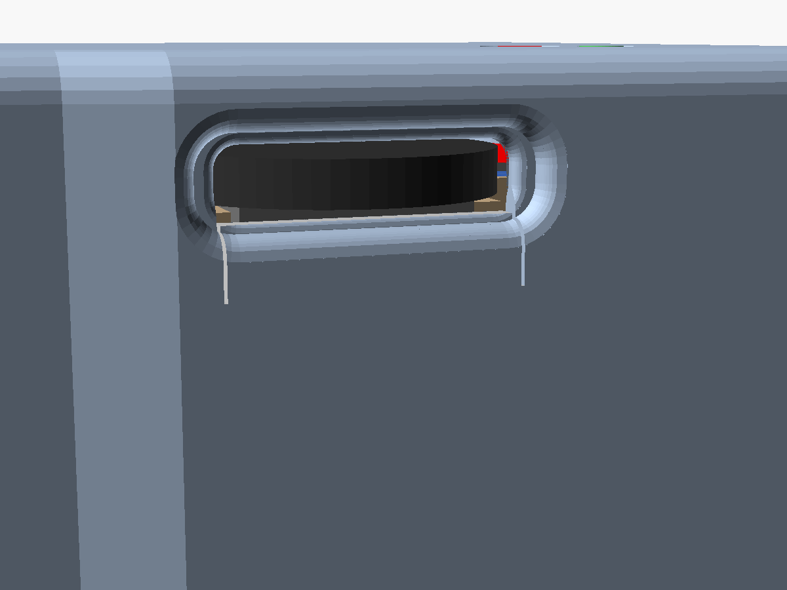
radio_adafruit_feather_rp2040/previews/closeup_wheel.png
