vicholz/openald/radio_adafruit_feather_rp2040/previews/frame_cell_outline_closeup.png

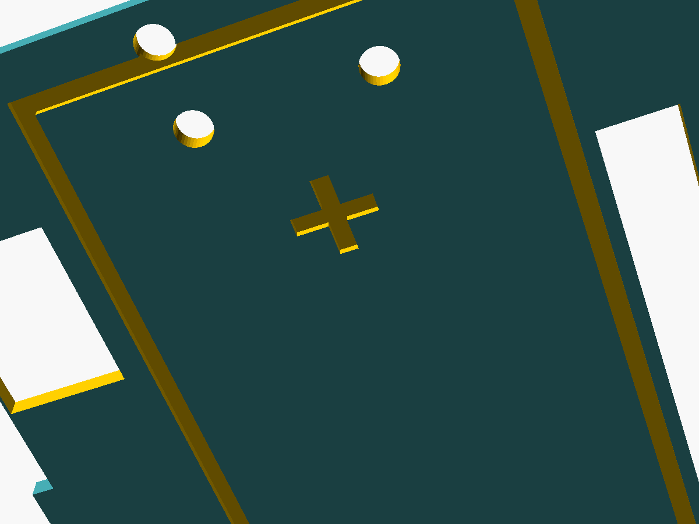
radio_adafruit_feather_rp2040/previews/frame_cell_outline_closeup.png
