vicholz/openald/radio_adafruit_feather_rp2040/previews/frame_top_view.png

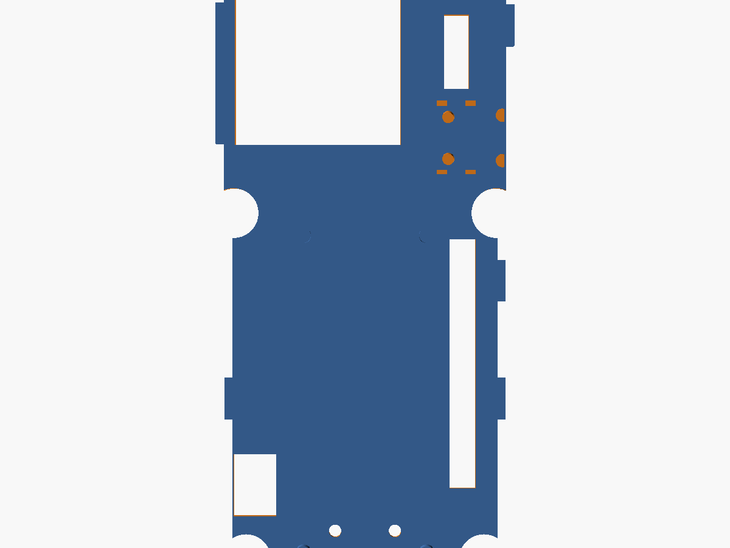
radio_adafruit_feather_rp2040/previews/frame_top_view.png
