vicholz/openald/radio_adafruit_feather_rp2040/previews/frame_underside_cell_outline.png

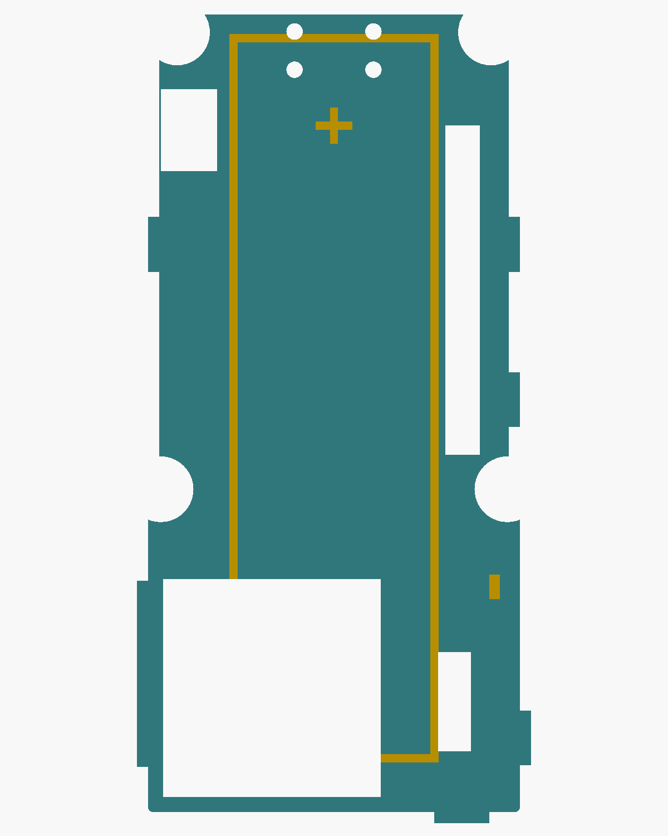
radio_adafruit_feather_rp2040/previews/frame_underside_cell_outline.png
