vicholz/openald/radio_adafruit_feather_rp2040/previews/inside_left_wall_switch.png

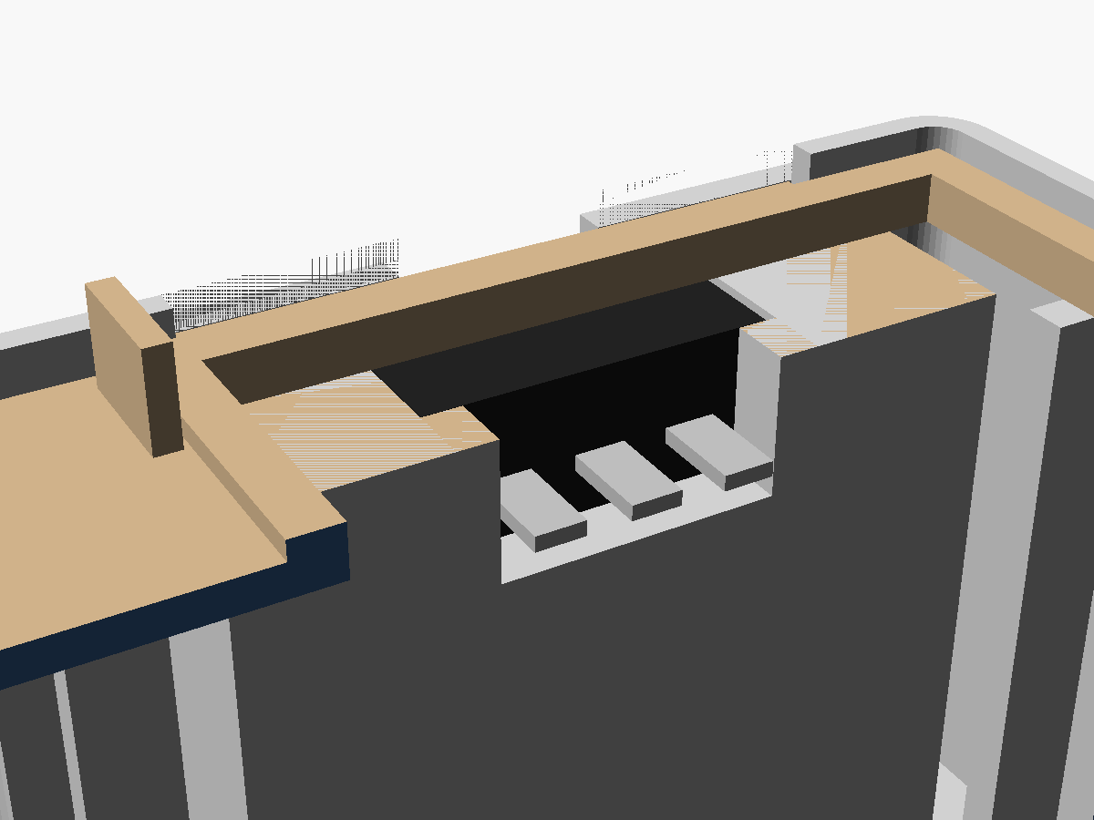
radio_adafruit_feather_rp2040/previews/inside_left_wall_switch.png
