vicholz/openald/radio_adafruit_feather_rp2040/previews/inside_right_wall_wheel.png

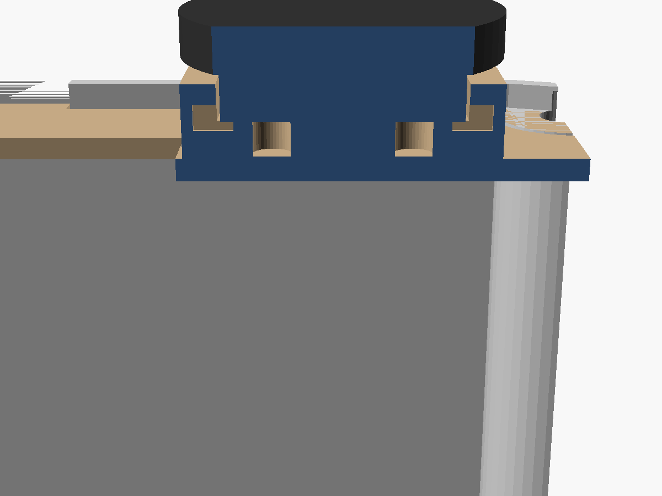
radio_adafruit_feather_rp2040/previews/inside_right_wall_wheel.png
