vicholz/openald/radio_adafruit_feather_rp2040/previews/section_frame_tab_y42.png

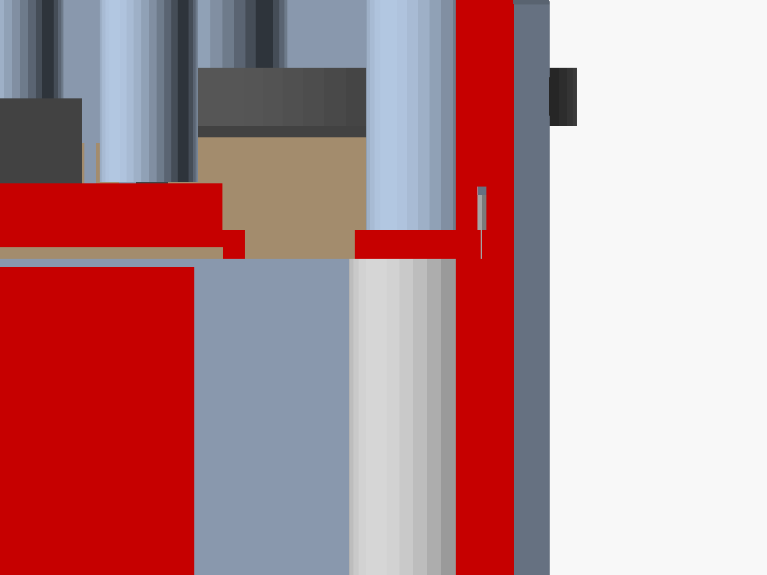
radio_adafruit_feather_rp2040/previews/section_frame_tab_y42.png
