vicholz/openald/radio_adafruit_feather_rp2040/previews/section_switch_rib_y77.png

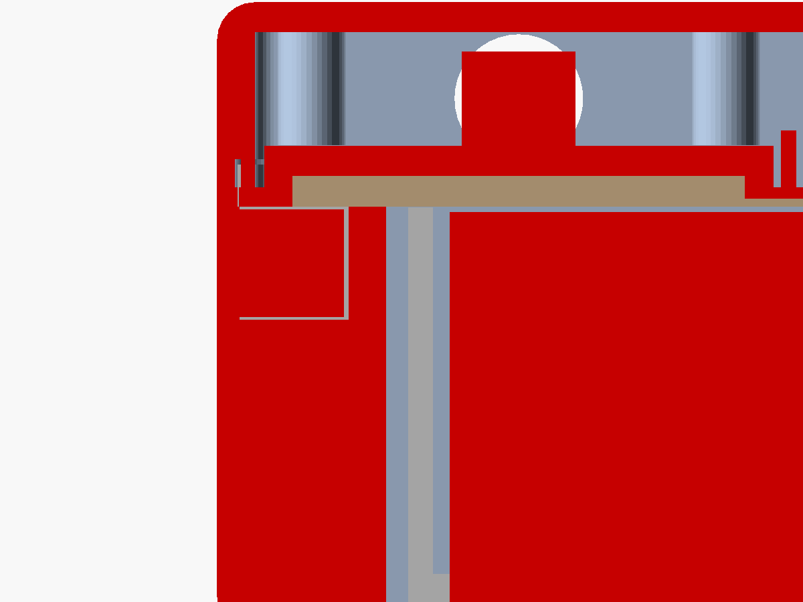
radio_adafruit_feather_rp2040/previews/section_switch_rib_y77.png
