vicholz/openald/radio_adafruit_feather_rp2040/previews/section_wheel_y62.png

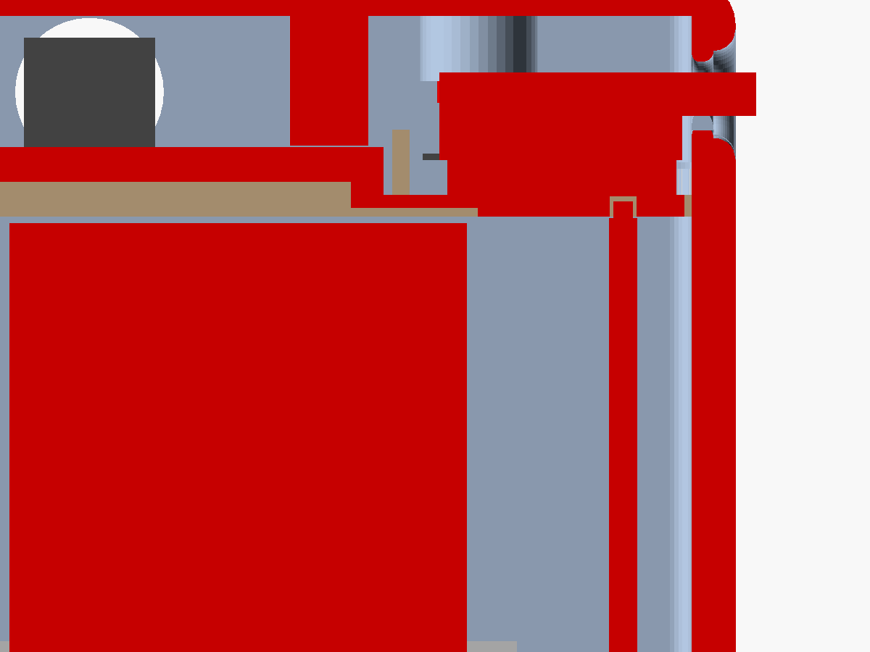
radio_adafruit_feather_rp2040/previews/section_wheel_y62.png
