vicholz/openald/radio_adafruit_feather_rp2040/previews/section_y30.png

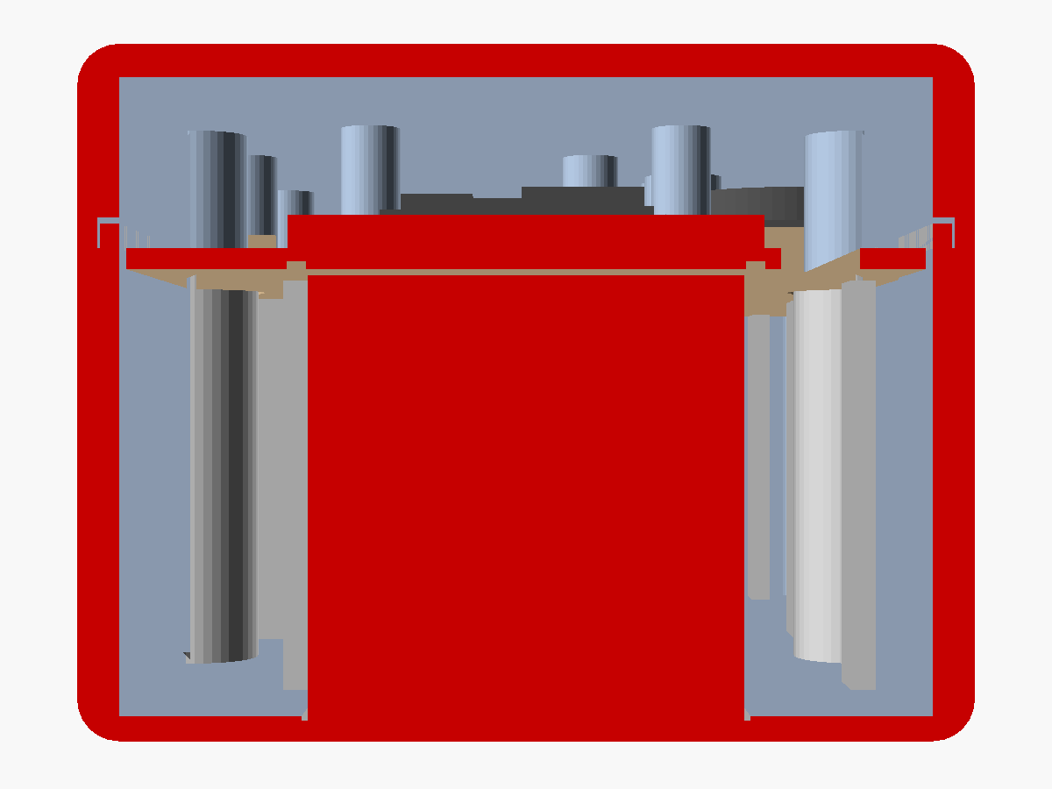
radio_adafruit_feather_rp2040/previews/section_y30.png
