vicholz/openald/radio_adafruit_feather_rp2040/previews/section_y70.png

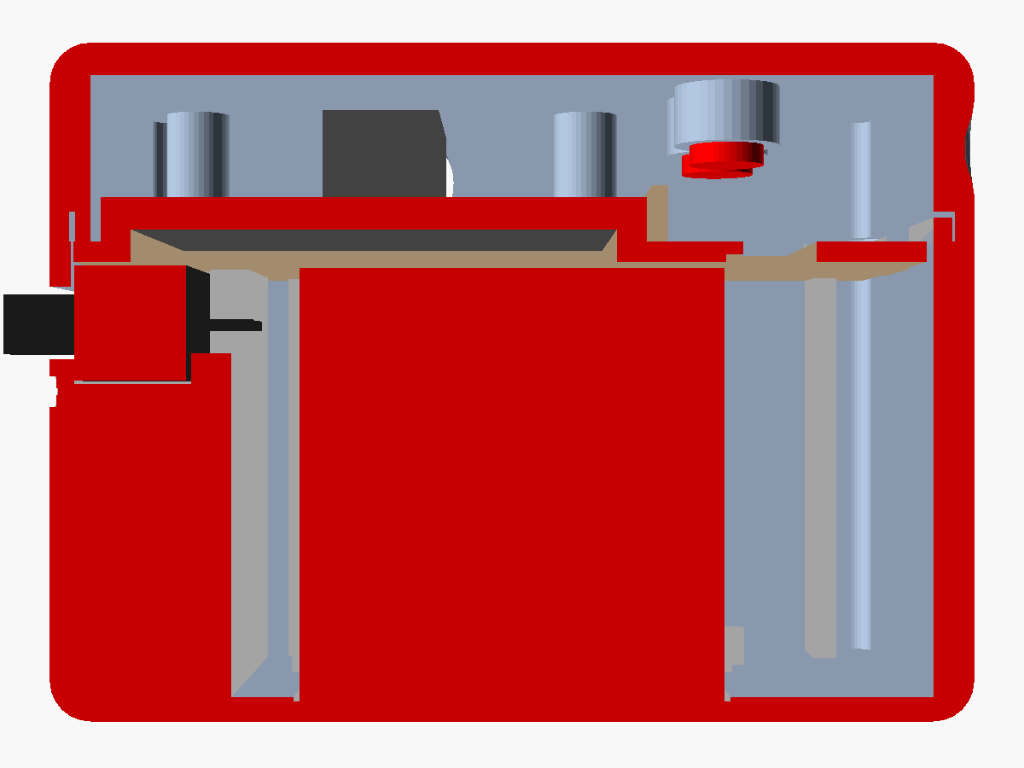
radio_adafruit_feather_rp2040/previews/section_y70.png
