vicholz/openald/radio_adafruit_feather_rp2040/previews/switch_backing_closeup.png

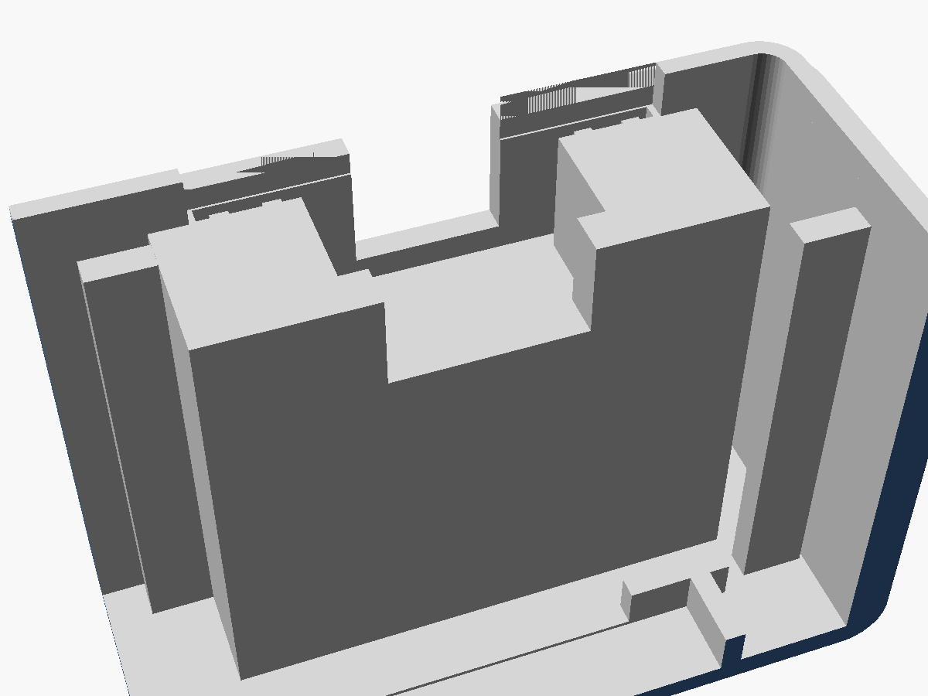
radio_adafruit_feather_rp2040/previews/switch_backing_closeup.png
