vicholz/openald/radio_adafruit_feather_rp2040/previews/switch_groove_bottom_half.png

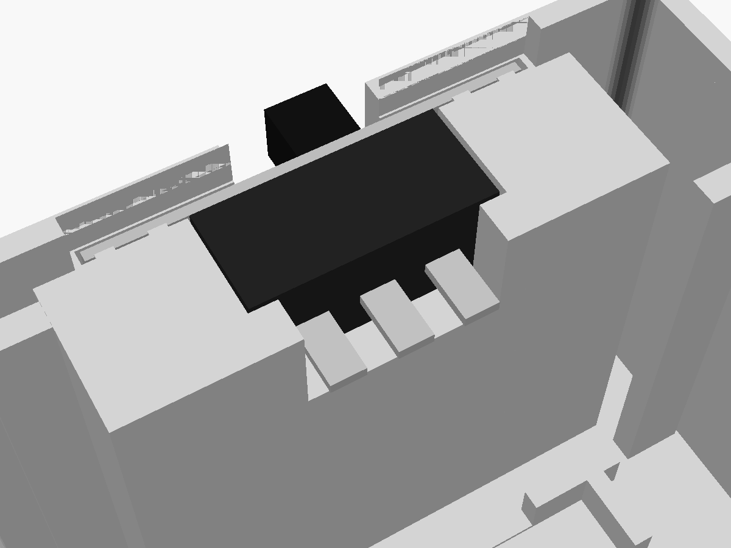
radio_adafruit_feather_rp2040/previews/switch_groove_bottom_half.png
