vicholz/openald/radio_adafruit_feather_rp2040/previews/wheel_cradle.png

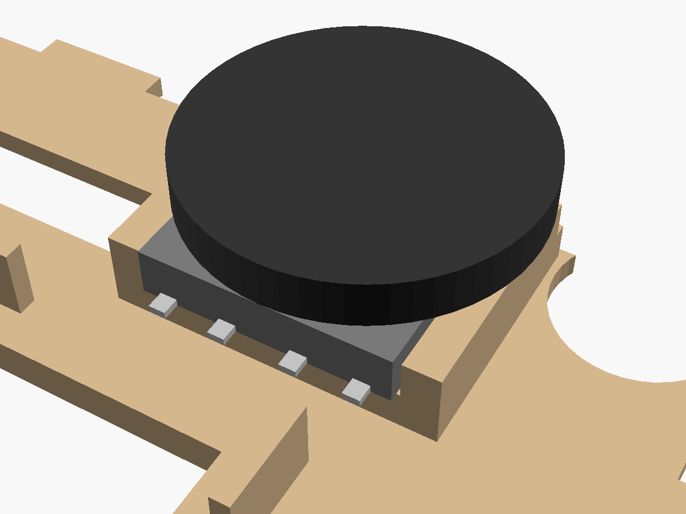
radio_adafruit_feather_rp2040/previews/wheel_cradle.png
