vicholz/openald/radio_single_board/previews/case_closed.png

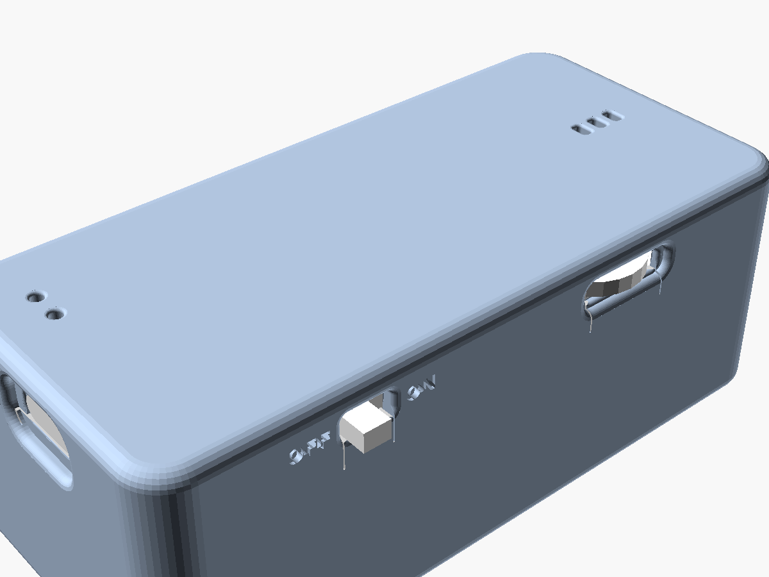
radio_single_board/previews/case_closed.png
