vicholz/openald/radio_single_board/previews/closeup_front_usb_leds.png

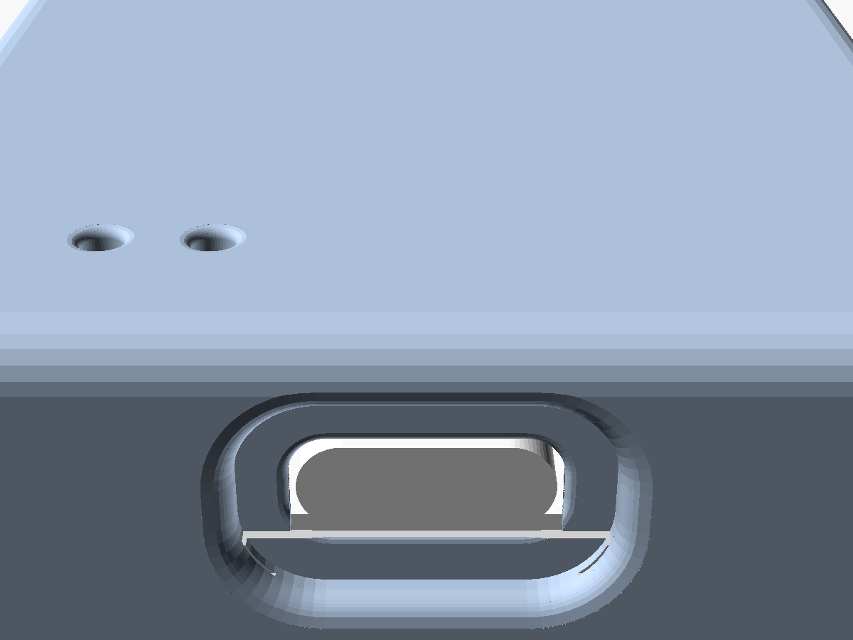
radio_single_board/previews/closeup_front_usb_leds.png
