vicholz/openald/radio_single_board/previews/closeup_jack_end.png

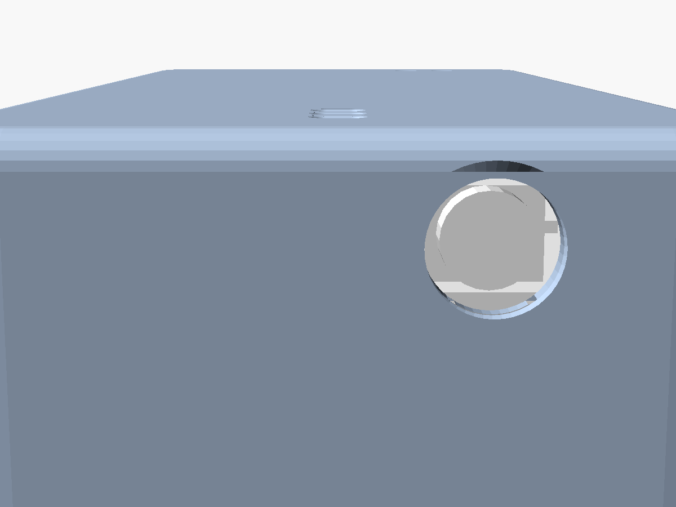
radio_single_board/previews/closeup_jack_end.png
