vicholz/openald/radio_single_board/previews/closeup_led_bar.png

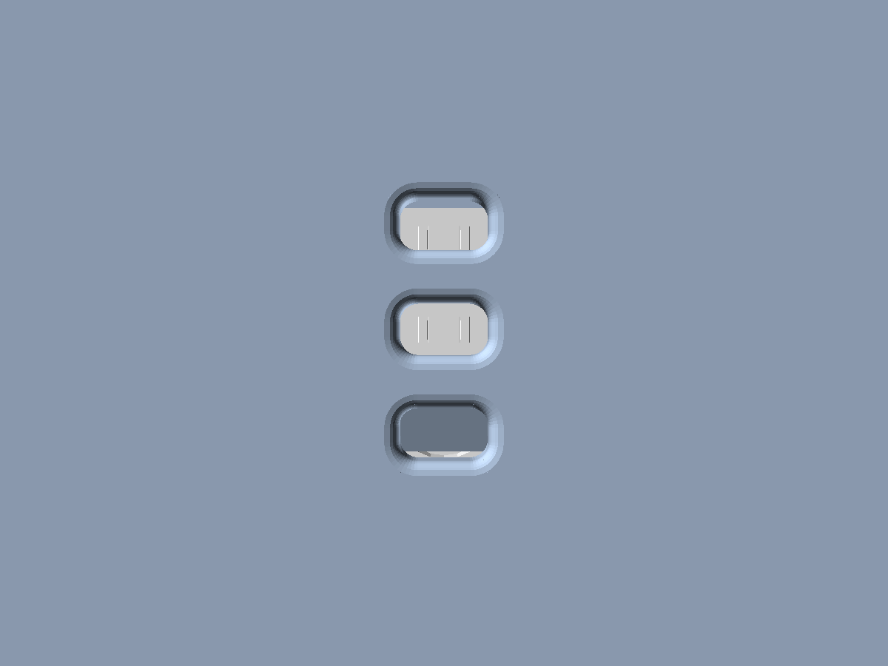
radio_single_board/previews/closeup_led_bar.png
