vicholz/openald/radio_single_board/previews/closeup_power_switch.png

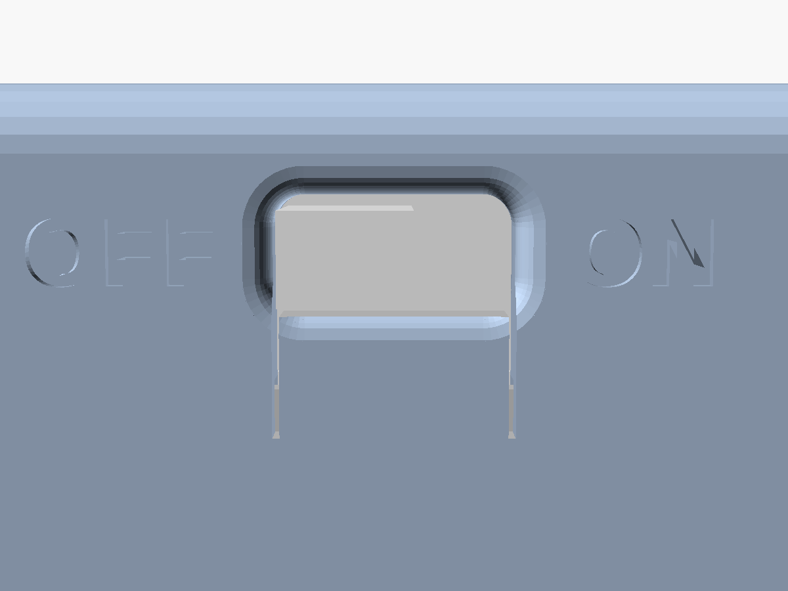
radio_single_board/previews/closeup_power_switch.png
