vicholz/openald/radio_single_board/previews/closeup_thumbwheel.png

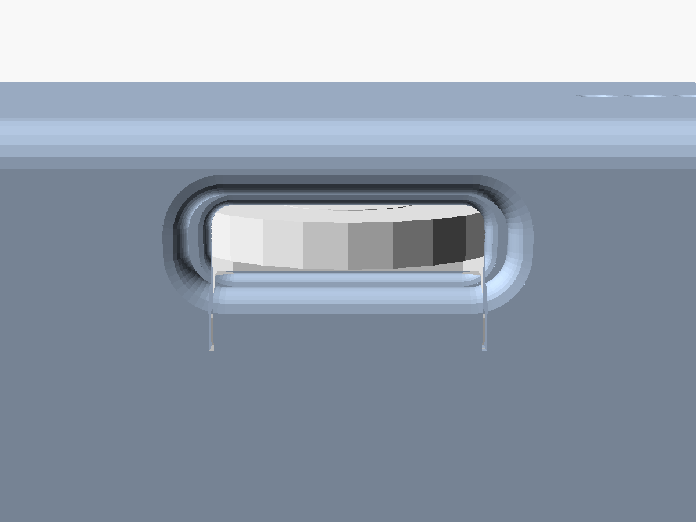
radio_single_board/previews/closeup_thumbwheel.png
