vicholz/openald/radio_single_board/previews/closeup_usb_c.png

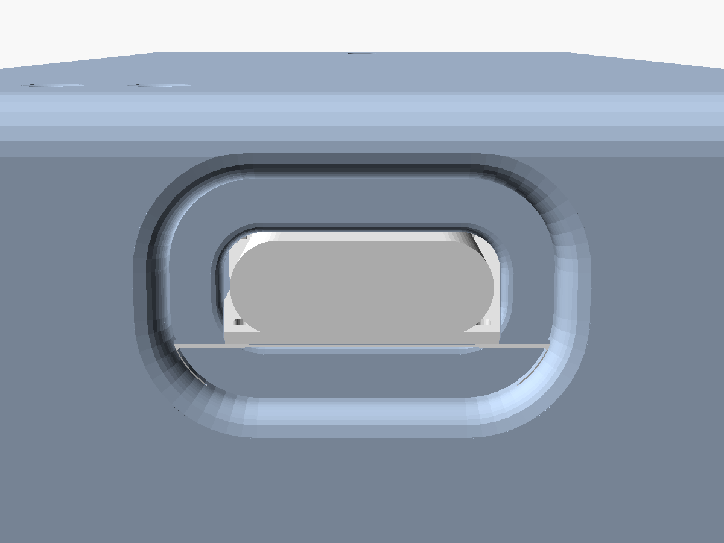
radio_single_board/previews/closeup_usb_c.png
