vicholz/openald/radio_single_board/previews/cpl_overlay_D7.png

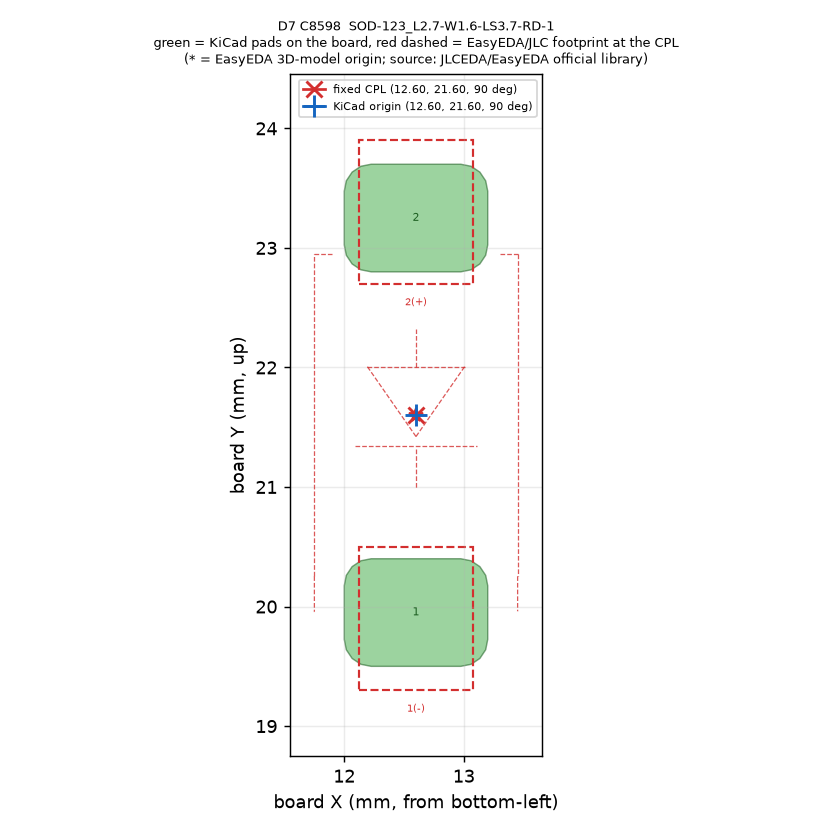
radio_single_board/previews/cpl_overlay_D7.png
