vicholz/openald/radio_single_board/previews/cpl_overlay_J2.png

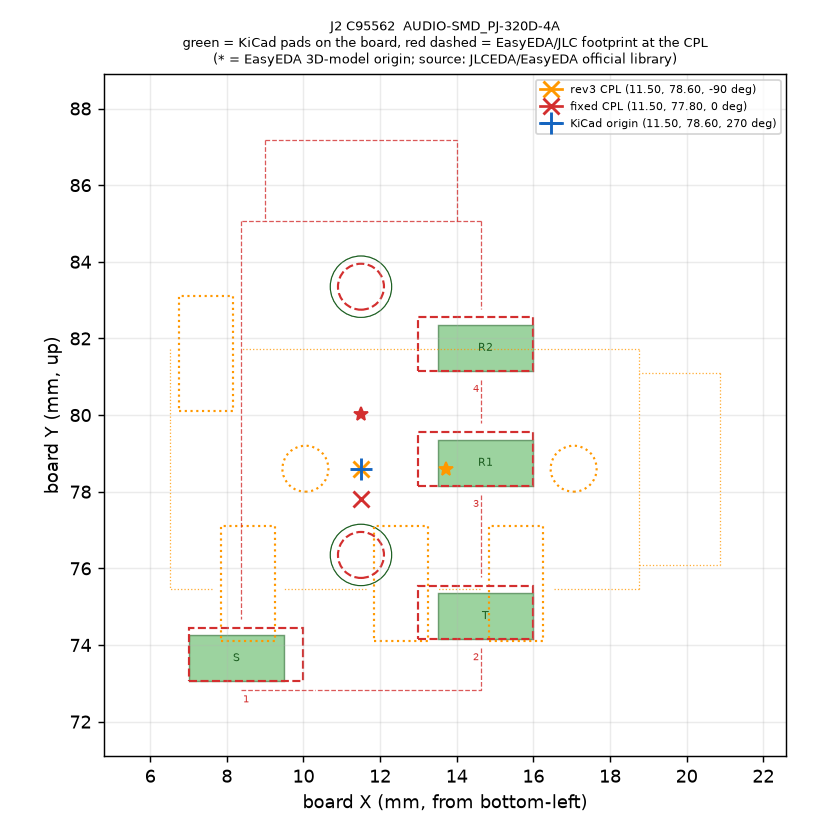
radio_single_board/previews/cpl_overlay_J2.png
