vicholz/openald/radio_single_board/previews/cpl_overlay_Q2.png

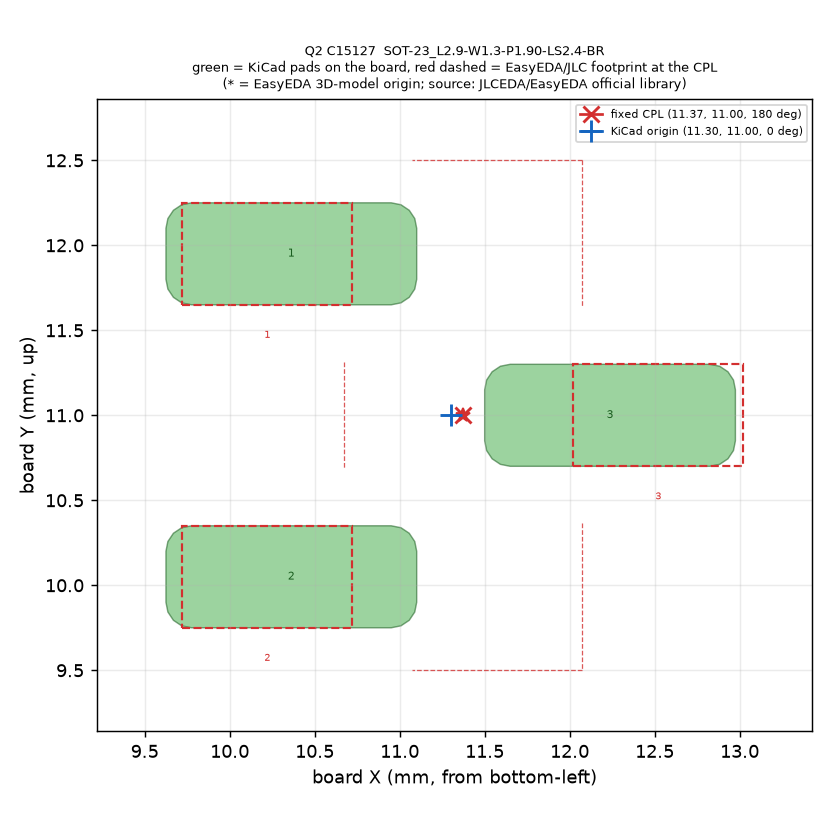
radio_single_board/previews/cpl_overlay_Q2.png
