vicholz/openald/radio_single_board/previews/cpl_overlay_Q3.png

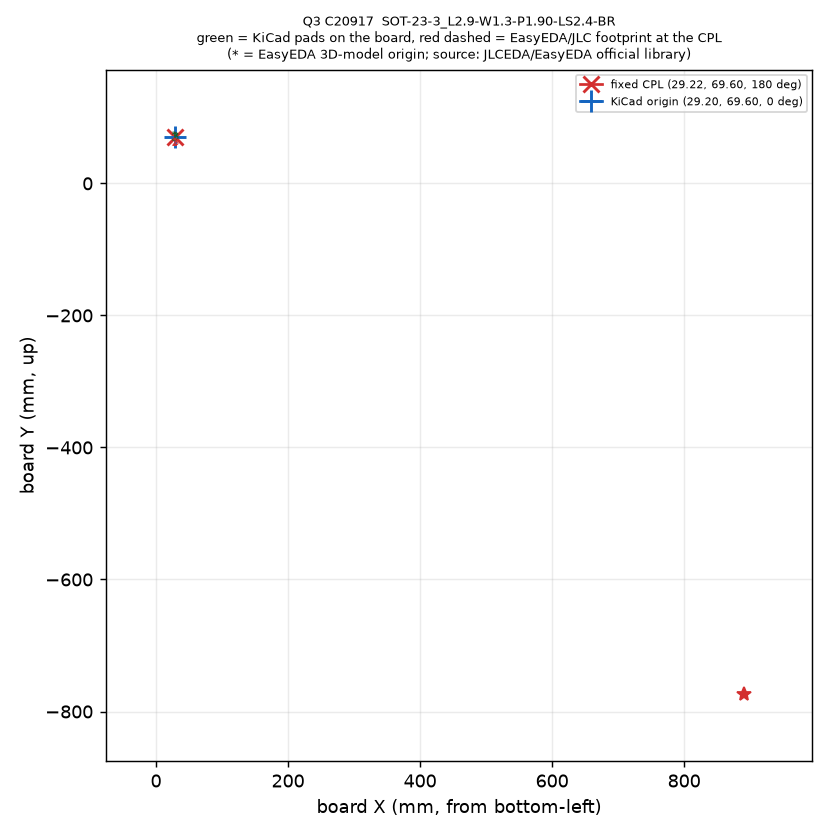
radio_single_board/previews/cpl_overlay_Q3.png
