vicholz/openald/radio_single_board/previews/cpl_overlay_U1.png

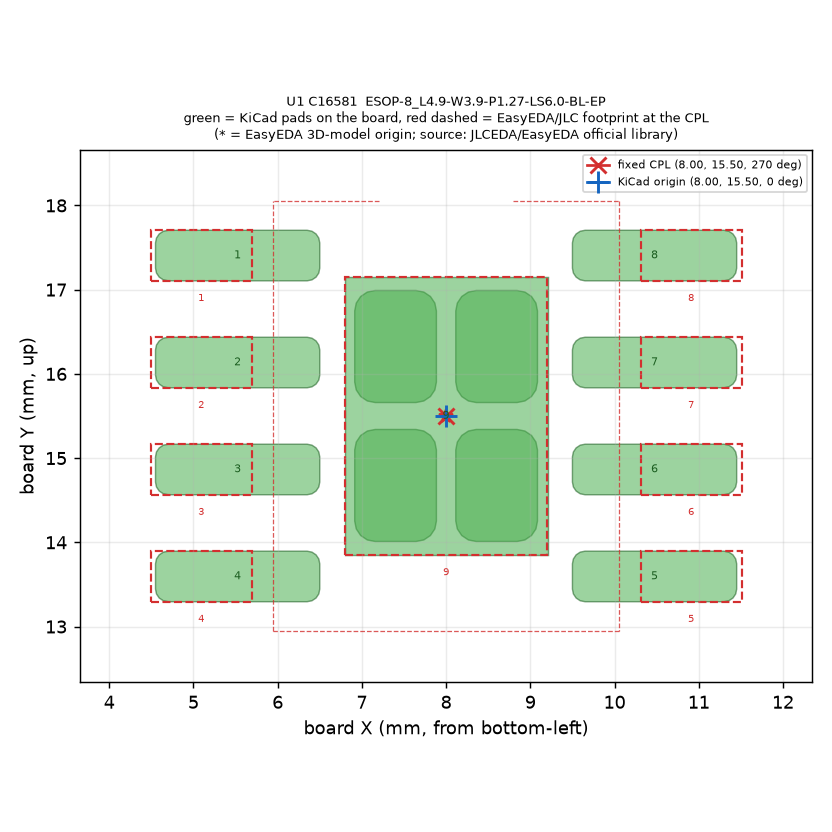
radio_single_board/previews/cpl_overlay_U1.png
