vicholz/openald/radio_single_board/previews/cutaway_led_tunnels.png

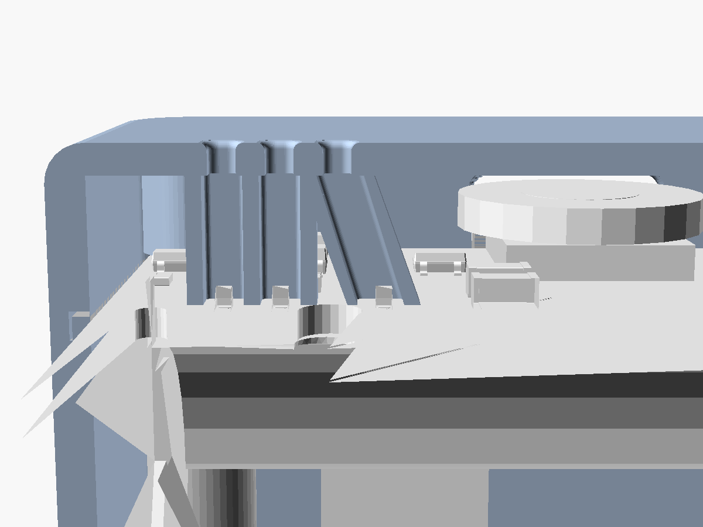
radio_single_board/previews/cutaway_led_tunnels.png
