vicholz/openald/radio_single_board/previews/pcb_bottom.png

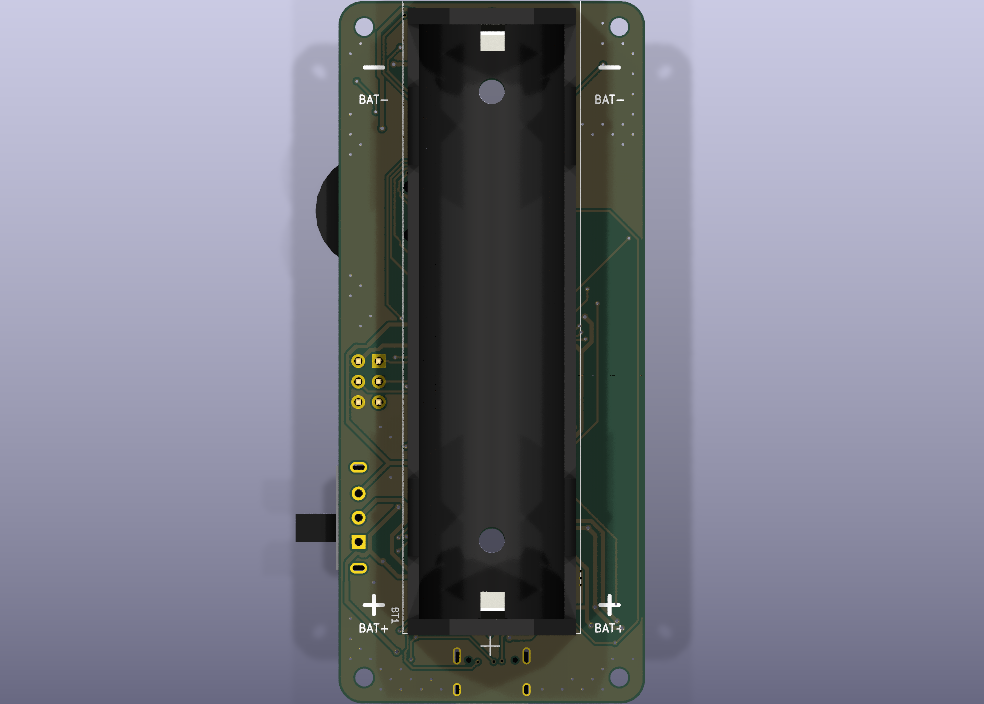
radio_single_board/previews/pcb_bottom.png
