vicholz/openald/radio_single_board/previews/pcb_closeup_led_bar.png

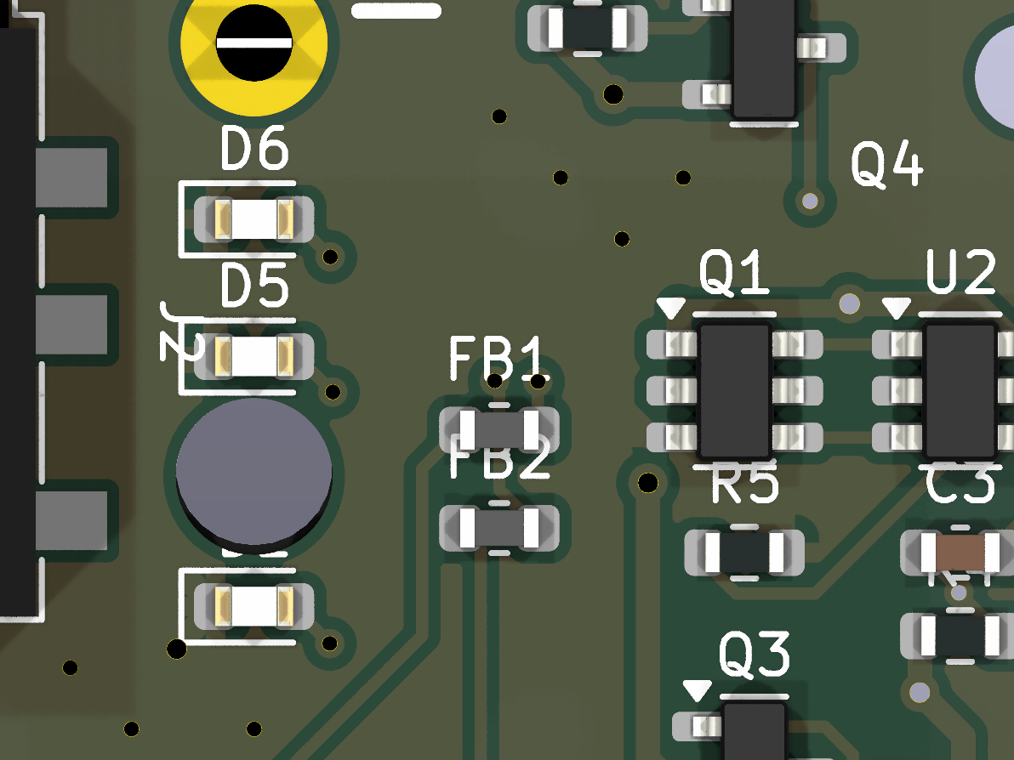
radio_single_board/previews/pcb_closeup_led_bar.png
