vicholz/openald/radio_single_board/previews/pcb_closeup_polarity_marks_bottom.png

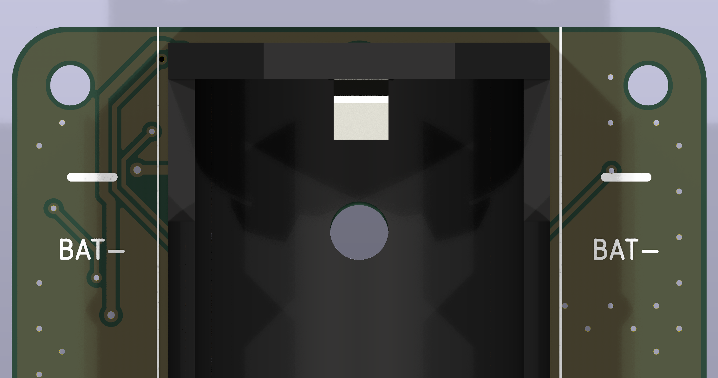
radio_single_board/previews/pcb_closeup_polarity_marks_bottom.png
