vicholz/openald/radio_single_board/previews/pcb_closeup_reverse_polarity.png

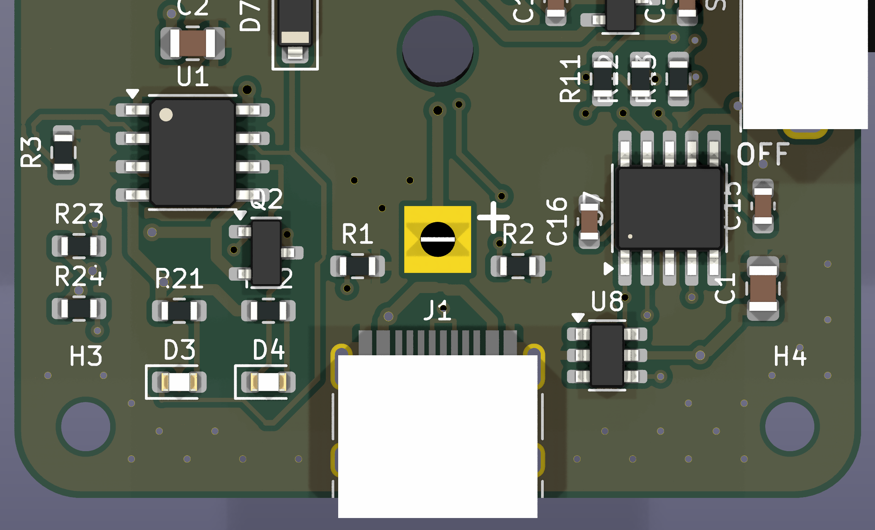
radio_single_board/previews/pcb_closeup_reverse_polarity.png
