vicholz/openald/radio_single_board/previews/pcb_closeup_usb_serial.png

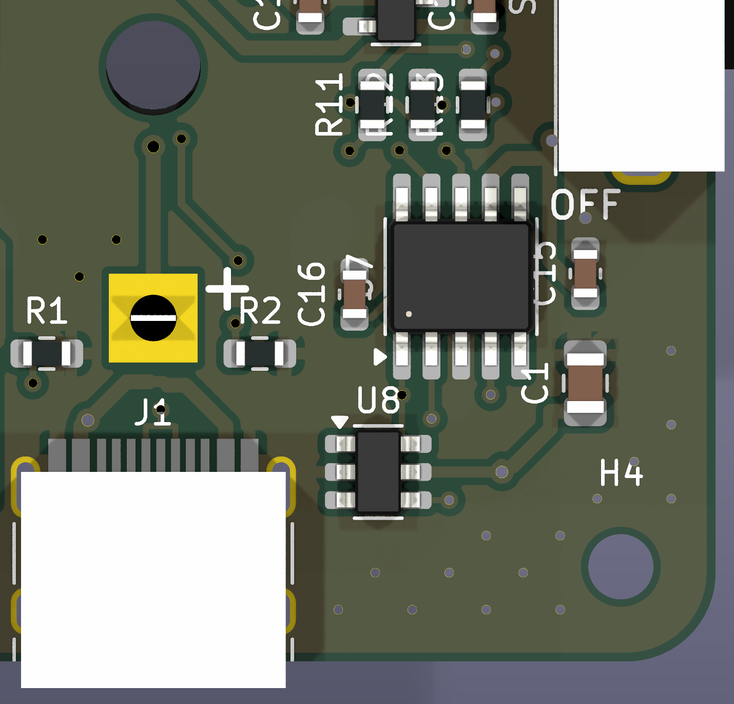
radio_single_board/previews/pcb_closeup_usb_serial.png
