vicholz/openald/radio_single_board/previews/pcb_top.png

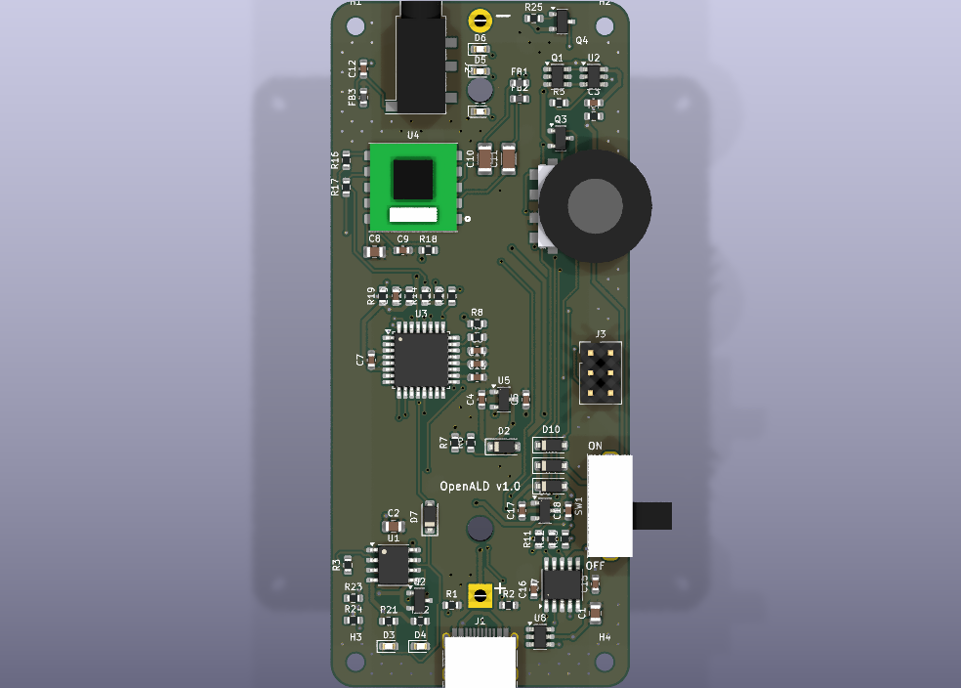
radio_single_board/previews/pcb_top.png
