vicholz/openald/radio_single_board/previews/schematic-1.png

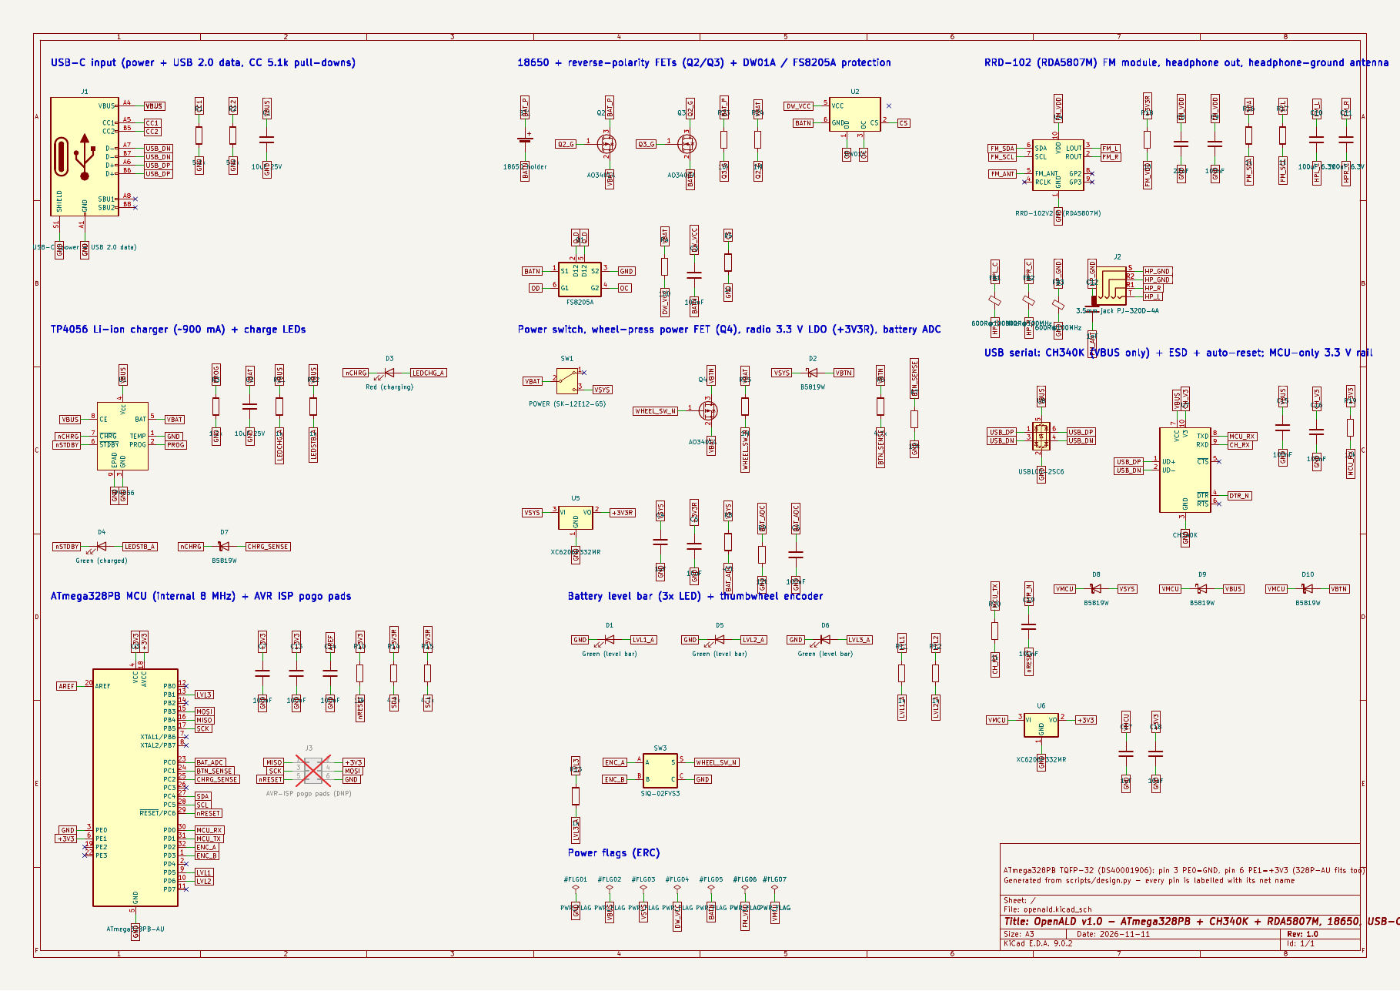
radio_single_board/previews/schematic-1.png
