vicholz/openald/radio_single_board/fab/openald-BOM-pcbway.xlsx

 |  |  | OpenALD v1.0 5PCS BOM
Item # | *Designator | *Qty | Manufacturer | *Mfg Part # | Description / Value | *Package/Footprint | Type | Your Instructions / Notes
1 | J1 | 1 | HRO | TYPE-C-31-M-12 | USB-C (power + USB 2.0 data) (USB_C_Receptacle_HRO_TYPE-C-31-M-12) | SMD | SMD | LCSC C165948
2 | R1,R2 | 2 |  | 0603WAF5101T5E | 5.1k (R_0603_1608Metric) | 0603 | SMD | LCSC C23186
3 | C1,C2 | 2 |  | CL21A106KAYNNNE | 10uF 25V (C_0805_2012Metric) | 0805 | SMD | LCSC C15850
4 | U1 | 1 | TOPPOWER | TP4056-42-ESOP8 | TP4056 (SOIC-8-1EP_3.9x4.9mm_P1.27mm_EP2.41x3.3mm) | ESOP-8 | SMD | LCSC C16581
5 | R3 | 1 |  | 0603WAF1201T5E | 1.2k (R_0603_1608Metric) | 0603 | SMD | LCSC C22765
6 | R5,R11,R12,R13,R16,R17,R20,R21,R22 | 9 |  | 0603WAF1001T5E | 1k (R_0603_1608Metric) | 0603 | SMD | LCSC C21190
7 | D3 | 1 |  | KT-0603R | Red (charging) (LED_0603_1608Metric) | 0603 | SMD | LCSC C2286
8 | D1,D4,D5,D6 | 4 |  | KT-0603G | Green (charged) / Green (level bar) (LED_0603_1608Metric) | 0603 | SMD | LCSC C12624
9 | Q2,Q4 | 2 | AOS | AO3401A | AO3401A (SOT-23) | SOT-23 | SMD | LCSC C15127
10 | Q3 | 1 | AOS | AO3400A | AO3400A (SOT-23) | SOT-23 | SMD | LCSC C20917
11 | R7,R10,R19,R23 | 4 |  | 0603WAF1002T5E | 10k (R_0603_1608Metric) | 0603 | SMD | LCSC C25804
12 | R24,R25 | 2 |  | 0603WAF1004T5E | 1M (R_0603_1608Metric) | 0603 | SMD | LCSC C22935
13 | U2 | 1 | PUOLOP | DW01A | DW01A (SOT-23-6) | SOT-23-6L | SMD | LCSC C351410
14 | Q1 | 1 | TECH PUBLIC | FS8205A | FS8205A (SOT-23-6) | SOT-23-6 | SMD | LCSC C2830320
15 | R4 | 1 |  | 0603WAF1000T5E | 100 (R_0603_1608Metric) | 0603 | SMD | LCSC C22775
16 | C3,C6,C7,C9,C13,C14,C15,C16,C19 | 9 |  | CC0603KRX7R9BB104 | 100nF (C_0603_1608Metric) | 0603 | SMD | LCSC C14663
17 | SW1 | 1 | HRO | SK-12E12-G5 | POWER (SK-12E12-G5) (SW_Slide_SPDT_Angled_HRO_SK-12E12-G5) | Plugin | thru-hole | LCSC C136720 Through-hole right-angle slide switch, knob off the right edge. Can be hand-soldered (5 joints) instead of assembled.
18 | D2,D7,D8,D9,D10 | 5 |  | B5819W SL | B5819W (D_SOD-123) | SOD-123 | SMD | LCSC C8598
19 | R6,R14,R15 | 3 |  | 0603WAF4701T5E | 4.7k (R_0603_1608Metric) | 0603 | SMD | LCSC C23162
20 | U5,U6 | 2 | Torex | XC6206P332MR-G | XC6206P332MR (SOT-23-3) | SOT-23-3L | SMD | LCSC C5446
21 | C4,C17 | 2 |  | CL10A105KB8NNNC | 1uF (C_0603_1608Metric) | 0603 | SMD | LCSC C15849
22 | C5,C18 | 2 |  | CL10A106KP8NNNC | 10uF (C_0603_1608Metric) | 0603 | SMD | LCSC C19702
23 | R8 | 1 |  | 0603WAF4702T5E | 47k (R_0603_1608Metric) | 0603 | SMD | LCSC C25819
24 | R9 | 1 |  | 0603WAF1202T5E | 12k (R_0603_1608Metric) | 0603 | SMD | LCSC C22790
25 | U3 | 1 | Microchip | ATMEGA328PB-AU | ATmega328PB-AU (TQFP-32_7x7mm_P0.8mm) | TQFP-32(7x7) | SMD | LCSC C132230 If out of stock, ATmega328P-AU (LCSC C14877) is a same-footprint drop-in.
26 | U8 | 1 | ST | USBLC6-2SC6 | USBLC6-2SC6 (SOT-23-6) | SOT-23-6L | SMD | LCSC C7519
27 | U7 | 1 | WCH | CH340K | CH340K (SSOP-10-1EP_3.9x4.9mm_P1mm_EP2.1x3.3mm) | ESSOP-10-150mil-1mm | SMD | LCSC C968586
28 | SW3 | 1 | Mitsumi | SIQ-02FVS3 | SIQ-02FVS3 (Mitsumi_SIQ-02FVS3) | SMD | SMD | LCSC C2925423
29 | R18 | 1 |  | 0603WAF100JT5E | 10 (R_0603_1608Metric) | 0603 | SMD | LCSC C22859
30 | C8 | 1 |  | CL21A226MAQNNNE | 22uF (C_0805_2012Metric) | 0805 | SMD | LCSC C45783
31 | C10,C11 | 2 |  | CL31A107MQHNNNE | 100uF 6.3V (C_1206_3216Metric) | 1206 | SMD | LCSC C15008
32 | FB1,FB2,FB3 | 3 |  | GZ1608D601TF | 600R@100MHz (L_0603_1608Metric) | 0603 | SMD | LCSC C1002
33 | C12 | 1 |  | CL10B102KB8NNNC | 1nF (C_0603_1608Metric) | 0603 | SMD | LCSC C1588
34 | J2 | 1 | HRO | PJ-320D-4A | 3.5mm jack PJ-320D-4A (Jack_3.5mm_KoreanHropartsElec_PJ-320D-4A_Horizontal) | SMD | SMD | LCSC C95562
35 | U4 | 1 |  | RRD-102V2.0 RDA5807M module | RRD-102V2.0 RDA5807M FM module (11x11mm castellated) | 11x11mm castellated | DNS | Hand-solder castellated FM module after assembly; not placed by the assembler.
36 | BT1 | 1 | MPD | BH-18650-PC | MPD BH-18650-PC 18650 PCB holder (THT, 2 pins 72.9mm) | THT, 2 pins 72.9mm | DNS | Hand-solder THT 18650 holder on the bottom side after assembly. Fit the + (flat contact) on the square pad at the USB-C end.
37 | J3 | 1 |  | 2x3 2.54mm header / pogo (DNP) | 2x3 2.54mm AVR-ISP pogo pads (ATmega328PB MISO/SCK/MOSI/RESET, 3.3 V) - bootloader burn only; do not leave a header fitted | 2x3 2.54mm pads | DNS | Do not fit a header (the case will not close over it). 2x3 ISP pogo pads only, for a one-time bootloader burn.
Need a quick and accurante quote? Need an efficient production? Please read SMT Ordering Necessary Files & Info in 1 minute. Thank you very much! (https://www.pcbway.com/smt_ordering_guide.html)
Click for Instructions on How to Create a BOM (https://www.pcbway.com/blog/PCB_Assembly/How_to_Build_a_BOM__Bill_Of_Materials_.html)
