vicholz/openald/radio_adafruit_feather_rp2040/docs/BOM.csv

# | Item | Source | Qty | Unit price USD | Link | Price source
1 | Adafruit Feather RP2040 (#4884) | Adafruit | 1 | 11.95 | https://www.adafruit.com/product/4884 | adafruit.com product page, 2026-11-11
2 | RDA5807M FM module, 26.9 x 26.9 mm, on-board 3.5 mm jack (the one Victor already has) | — | 1 |  |  | on hand; not priced
3 | 18650 holder, PC pin, MPD BH-18650-PC | DigiKey BH-18650-PC-ND | 1 | 3.35 | https://www.digikey.com/en/products/detail/mpd-memory-protection-devices/BH-18650-PC/3029216 | DigiKey qty-1 price via search snapshot, 2026-11-11
4 | Protected button-top 18650 cell, e.g. Samsung 35E protected 3500 mAh (~69.3-69.8 mm) | 18650 Battery Store | 1 | 11.99 | https://www.18650batterystore.com/products/samsung-35e-protected | product page snapshot, 2026-11-11
5 | STEMMA QT / Qwiic JST SH 4-pin cable 100 mm (#4210) - cut one end, solder to the FM module (or #4209 to male headers) | Adafruit | 1 | 0.95 | https://www.adafruit.com/product/4210 | adafruit.com product page, 2026-11-11 (showed out of stock; #4209/#4397 same price)
6 | JST PH 2-pin cable, female connector 100 mm (#261) - battery lead | Adafruit | 1 | 0.75 | https://www.adafruit.com/product/261 | adafruit.com product page, 2026-11-11
7 | Thumbwheel encoder with push, Mitsumi SIQ-02FVS3 (bought loose, glued into the frame cradle) | LCSC C2925423 | 1 | 3.18 | https://www.lcsc.com/product-detail/C2925423.html | JLC/LCSC parts API, 2026-11-11 (first price tier)
8 | Slide switch SS-12F16 SPDT (1P2T) panel mount, G4 (4 mm knob) default; G6 works (set SW_L=6); LCSC stocks only G050 (set SW_L=5) | LCSC C2876006 (G050) or any SS-12F16-G4/G6 | 1 | 0.08 | https://www.lcsc.com/product-detail/C2876006.html | JLC/LCSC parts API, 2026-11-11, G050 price; G4/G6 not price-checked
9 | M2 x 12 mm screws (socket or pan head) | any | 4 |  | https://www.amazon.com/s?k=M2+x+12mm+socket+head+screws | not price-checked
10 | M2 brass heat-set inserts, OD 3.2-3.5 x L <= 4.5 mm | any | 4 |  | https://www.amazon.com/s?k=M2+heat+set+inserts | not price-checked
11 | Battery divider (needed for the battery gauge): 2x 220 k + 1x 100 nF, through-hole or 0603/0805 on wires, in heat-shrink | any | 1 set |  |  | not price-checked
12 | Optional dock-visible charge LEDs: 3 mm THT red + 3 mm THT green (diffused), 2x 1.5 k resistors | any | 1 set |  |  | not price-checked
13 | Hookup wire: 28-30 AWG silicone, ~8 colours, ~1.5 m total (about 12 leads of ~120 mm) + 32-36 AWG enamel/wire-wrap for the optional STAT tap; heat-shrink 1.5-2 mm; medium CA or 5-min epoxy; thin double-sided tape (<=0.2 mm, not foam) or glue dots for the holder | any | — |  |  | not price-checked
14 | Filament (PLA/PETG): top 10.8 + bottom 20.8 + frame 2.4 cm^3 = ~34 cm^3 (~43 g) | — | — |  |  | —
