vicholz/openald/radio_adafruit_feather_rp2040/fab/openald-feather-controls-BOM-jlcpcb.csv

Comment | Designator | Footprint | LCSC Part #
SIQ-02FVS3 | SW2 | Mitsumi_SIQ-02FVS3 | C2925423
220k | R1,R2 | R_0603_1608Metric | C22961
100nF | C1 | C_0603_1608Metric | C14663
1.5k | R3,R4 | R_0603_1608Metric | C22843
RED CHG | D1 | LED_0603_1608Metric | C2286
GREEN FULL | D2 | LED_0603_1608Metric | C12624
