vicholz/openald/radio_single_board/scripts/templates/nextpcb-BOM-template.xls

Designator* | Quantity* | Manufacturer Part Number* | Manufacturer | Package/Footprint | Description | Procurement Type | Customer Note
Required | Required | Required |  |  |  | Optional 1）Do not populate/install: DNP 2）Customer supplied part: C Learn more >
R1,R2,R3,R4,R5 | 5 | 0603WAF100MT5E
C1-C4 | 4 | 0402B103K250NT
U4 | 1 | BR24L08FV-WE2 |  |  |  | DNP
D5 | 1 | BR34E02FVT-3E2 |  |  |  | C
