vicholz/openald/charging_dock/case/dock_base.stl

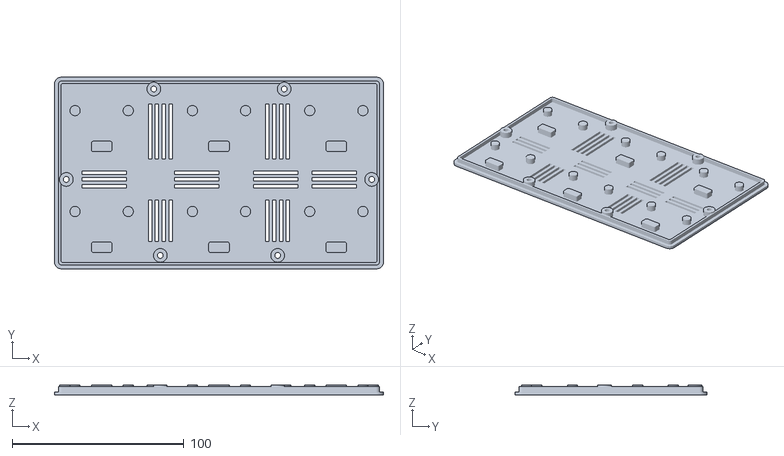
[picture p69: CAD file, 2026-11-13]
charging_dock/case/dock_base.stl
191.8 x 111.7 x 6.10
