vicholz/openald/charging_dock/case/floor_pads/dock_floor_pad_slot2.stl

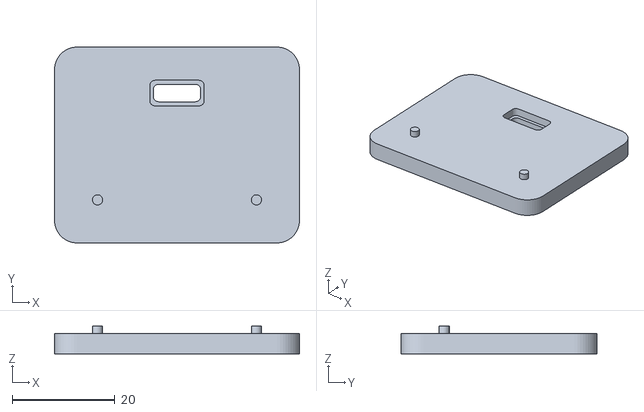
[picture p70: CAD file, 2026-11-13]
charging_dock/case/floor_pads/dock_floor_pad_slot2.stl
47.8 x 38.2 x 5.40
