vicholz/openald/radio_adafruit_feather_rp2040/case/stl/frame.stl

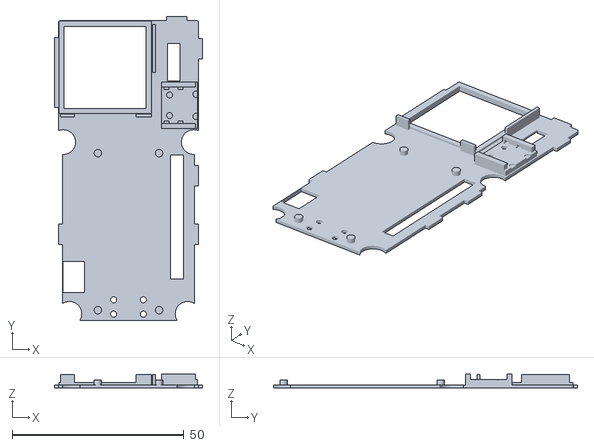
[picture p71: CAD file, 2026-11-13]
radio_adafruit_feather_rp2040/case/stl/frame.stl
43.2 x 88.5 x 4.20
