vicholz/openald/radio_single_board/case/case_bottom.stl

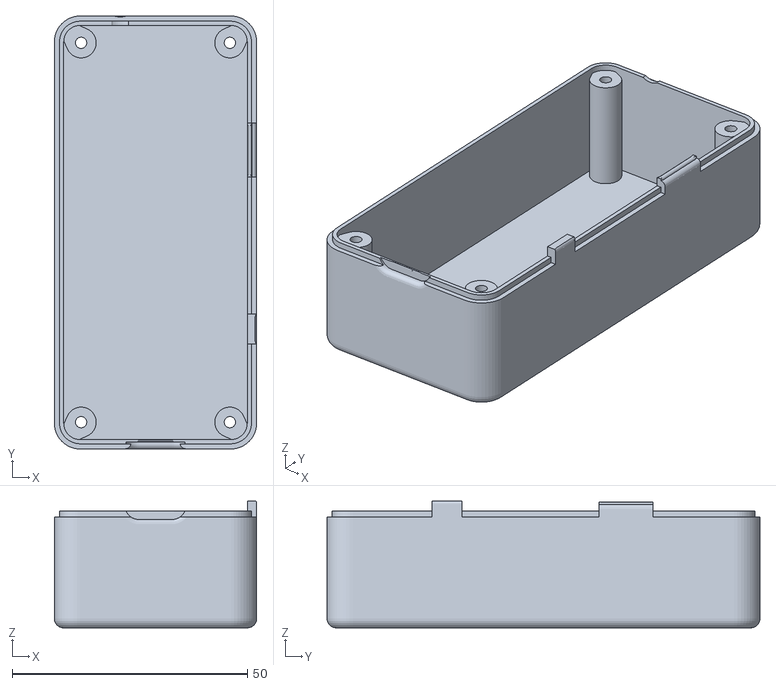
[picture p72: CAD file, 2026-11-13]
radio_single_board/case/case_bottom.stl
43.0 x 92.0 x 27.0
