vicholz/openald/charging_dock/case/dock_top_shell.stl

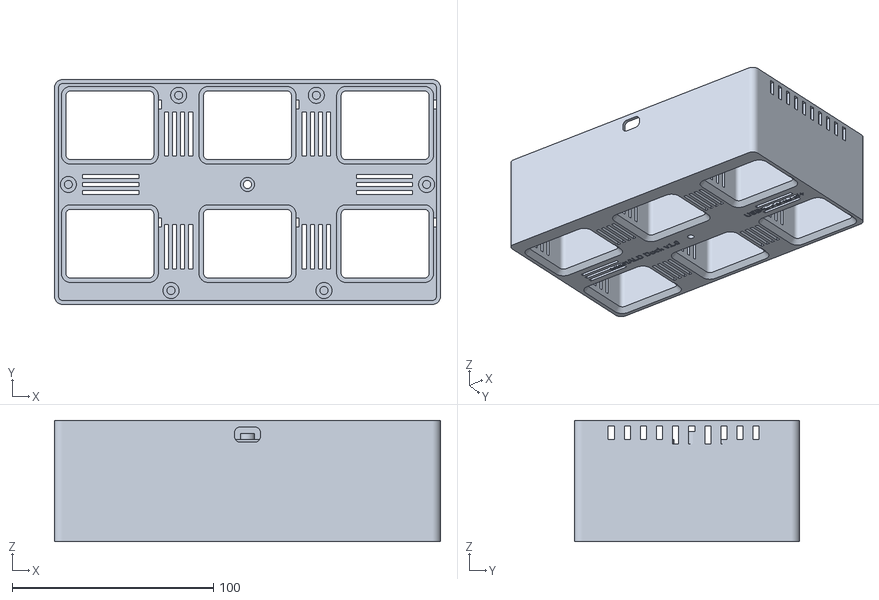
[picture p73: CAD file, 2026-11-13]
charging_dock/case/dock_top_shell.stl
191.8 x 111.7 x 60.2
