vicholz/openald/radio_adafruit_feather_rp2040/case/stl/case_top.stl

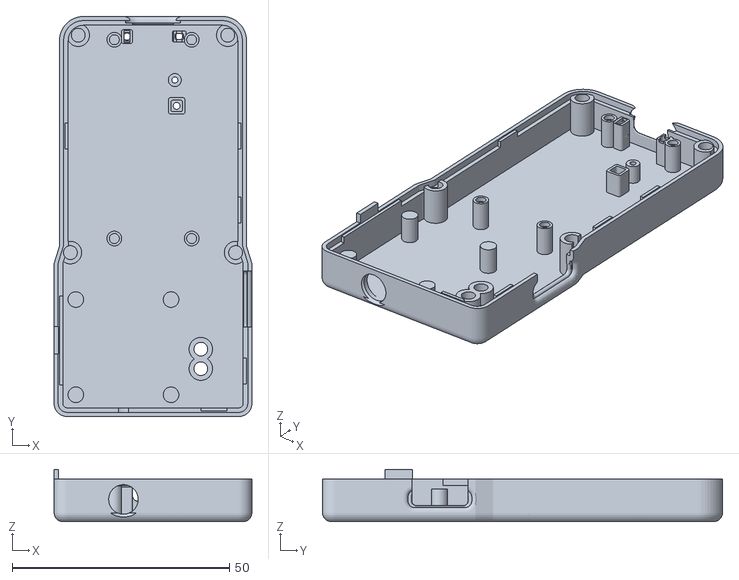
[picture p74: CAD file, 2026-11-13]
radio_adafruit_feather_rp2040/case/stl/case_top.stl
45.5 x 92.0 x 12.0
