vicholz/openald/radio_single_board/case/case_top.stl

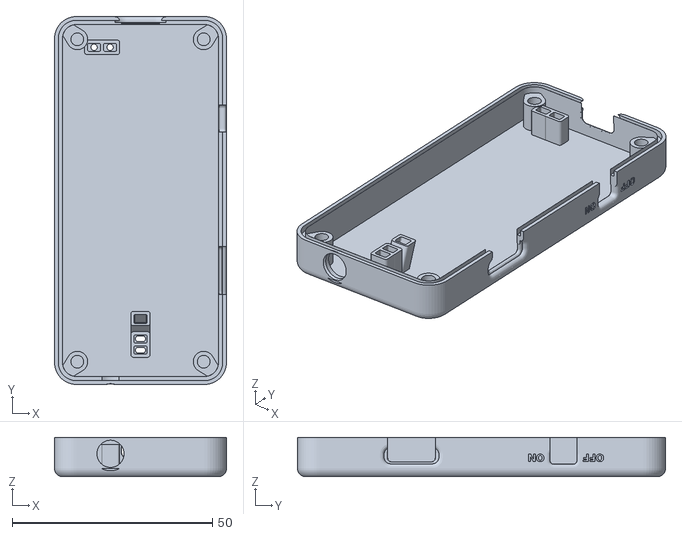
[picture p75: CAD file, 2026-11-13]
radio_single_board/case/case_top.stl
43.0 x 92.0 x 9.80
