vicholz/openald/charging_dock/case/dock_floor_pads_x6.stl

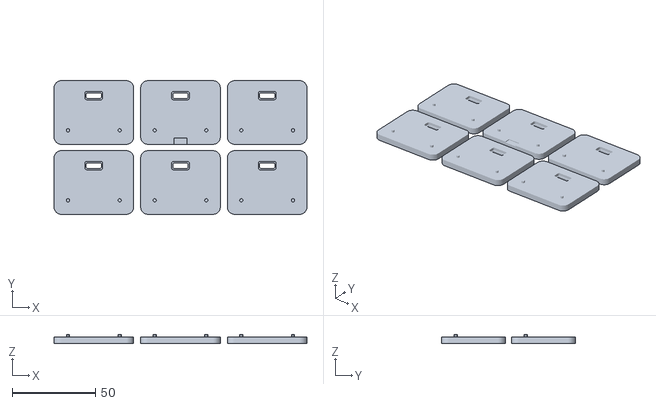
[picture p76: CAD file, 2026-11-13]
charging_dock/case/dock_floor_pads_x6.stl
151.8 x 80.2 x 5.40
