vicholz/openald/charging_dock/case/dock_params.scad

// generated by scripts/gen_dock_params.py - do not edit (edit geom.py / placement.py)
RW = 43.0;
RD = 33.41;
USB_FROM_FRONT = 6.57;
MOUTH_UP = 1.6;
GAP = 25.4;
OUT_W = 191.8;
OUT_D = 111.72;
WALL = 2.0;
POCKET_DEPTH = 50.8;
CLR_GUIDE = 0.35;
GUIDE_H = 12.0;
CLR_UPPER = 0.6;
POCKET_WALL = 2.0;
CHAMFER = 3.0;
BASE_T = 2.0;
STANDOFF = 4.1;
PCB_T = 1.6;
PCB_Z0 = 6.1;
PCB_Z1 = 7.7;
PAD_T = 4.0;
FLOOR_Z = 11.7;
PLUG_H = 11.6;
PLUG_TOP = 19.3;
TOP_Z = 62.5;
PCB_X0 = 2.9;
PCB_Y0 = 2.9;
PCB_X1 = 188.9;
PCB_Y1 = 108.82;
radios = [[6.0, 6.0], [74.4, 6.0], [142.8, 6.0], [6.0, 64.81], [74.4, 64.81], [142.8, 64.81]];
plugs = [[27.5, 12.57], [95.9, 12.57], [164.3, 12.57], [27.5, 71.38], [95.9, 71.38], [164.3, 71.38]];
holes = [[61.7, 7.82], [130.1, 7.82], [57.9, 104.82], [133.9, 104.82], [6.9, 52.11], [184.9, 52.11]];
pegs = [[12.0, 33.41], [43.0, 33.41], [80.4, 33.41], [111.4, 33.41], [148.8, 33.41], [179.8, 33.41], [12.0, 92.22], [43.0, 92.22], [80.4, 92.22], [111.4, 92.22], [148.8, 92.22], [179.8, 92.22]];
led_pipe = [95.9, 52.11];
usb_in = [95.9, 108.82];
usb_in_z = 9.33;
