vicholz/openald/radio_adafruit_feather_rp2040/case/case_params.scad

// AUTO-GENERATED by scripts/gen_case_params.py from scripts/layout.py -- do not edit
// case frame: X across (centre 19), Y=0 at the USB-C receptacle face, Z=0 at the Feather bottom face
include <feather_params.scad>
WALL = 2;
CLR = 0.5;
EDGE_R = 2;
IN_X0 = -0.5;
IN_X1 = 38.5;
IN_R = 3.5;
OUT_R = 5.5;
Y_IN0 = -0.5;
Y_OUT0 = -2.5;
TOP_IN = 8.2;
TOP_T = 1.6;
BOT_OUT = -23.61;
USB_X = 19;
USB_Z = 3.23;
USB_W = 8.94;
USB_H = 3.26;
DOCK_DEPTH = 50.8;
DOCK_LINE_Y = 48.3;
FLOOR_T = 1.2;
FLOOR_Z = -22.41;
J0 = 50.3;
J1 = 54.3;
WIDEN = 1.25;
IN_X0U = -1.75;
IN_X1U = 39.75;
Y_IN1 = 87.5;
Y_OUT1 = 89.5;
TOP_OUT_R = 3;
TOP_IN_R = 1;
DECK_Z0 = -1;
DECK_Z1 = 0;
FM_HOLE_INSET = 2.5;
FM_HOLE_D = 2.2;
FM_JACK_X = 12.2;
FM_JACK_AXIS_H = 2.5;
FM_JACK_BODY_H = 5;
FM_JACK_HOLE_D = 6.8;
WHEEL_R = 7.25;
WHEEL_SEAT_Z = 1.6;
WHEEL_PUSH = 1;
SW_L = 4;
SW_Y = 72;
SW_Z = -4;
SW_LUG_L = 3;
SW_LUG_P = 3;
SW_TRAVEL = 3;
SW_SKIN = 1.2;
SW_GROOVE = 0.7;
SW_RIB = 0.8;
SW_CRUSH = 0.25;
SW_PLATE_MAX = 0.6;
SW_BACK = 2;
SW_SIDE_EXT = 2;
HOLDER_POCKET = 0.2;
DECK_RELIEF = 0;
CELL_MARK_D = 0.4;
CELL_MARK_W = 0.9;
LED3_ABOVE_FLANGE = 4.6;
holder_box = [8.55, 29.45, 3, 80.7, -22.61, -1.3];
holder_pins = [[19, 5.4], [19, 78.3]];
fm_box = [-1.25, 25.65, 60.1, 87, 0.6, 1.6];
wheel_xy = [35.45, 62.5];
wheel_z0 = 2;
wheel_z1 = 4;
sw_plate = [19.7, 5.7, 0.5];
sw_body = [11, 5.7, 5];
sw_act = [3, 3];
led3 = [[30, 74], [30, 78.5]];
screws = [[1.8, 1.8], [36.2, 1.8], [0, 51.8], [38, 51.8]];
frame_tabs = [[0, 25, 6], [0, 72, 20.4], [1, 25, 6], [1, 42, 6], [1, 79, 6], [2, 33, 6]];
