vicholz/openald/radio_adafruit_feather_rp2040/case/feather_params.scad

// AUTO-GENERATED by scripts/feather_data.py from Adafruit's Feather RP2040 Eagle board -- do not edit
feather_t = 1.6;
feather_dy = -0.9;   // receptacle face Y (moved toward the USB face)
feather_box = [7.57, 30.43, 0.307, 51.106];
feather_holes = [[10.11, 2.847], [27.89, 2.847], [10.11, 48.566], [27.89, 48.566]];
f_led_chg = [25.032, 2.085];
f_led_red = [13.008, 2.126];
f_led_neo = [24.448, 18.061];
f_btn_reset = [24.017, 12.117];
f_btn_boot = [15.127, 49.456];
f_jst = [12.777, 11.229];
f_qt = [22.175, 48.059];
// component envelopes [x0,x1,y0,y1,z0,z1] (case frame)
f_parts = [[19.213,22.353,13.503,15.003,1.6,2.85],
  [15.788,17.288,13.79,16.93,1.6,2.85],
  [12.608,13.407,0.976,3.276,1.6,2.2],
  [8.138,10.913,5.496,6.496,1.6,2.15],
  [22.491,25.542,9.617,14.617,1.6,3.5],
  [17.544,21.345,15.167,18.467,1.6,2.8],
  [7.926,17.126,7.029,15.428,1.6,7.1],
  [12.998,16.798,17.199,20.498,1.6,2.8],
  [24.633,25.433,0.935,3.235,1.6,2.2],
  [25.422,26.422,4.685,7.46,1.6,2.15],
  [11.651,14.791,15.431,16.931,1.6,2.85],
  [11.515,12.515,17.271,20.046,1.6,2.15],
  [21.062,24.202,43.562,45.062,1.6,2.85],
  [22.198,26.698,16.161,19.961,1.6,2.6],
  [14.246,18.547,40.343,44.343,1.6,2.2],
  [16.038,18.813,44.815,45.815,1.6,2.15],
  [11.528,12.528,23.811,26.586,1.6,2.15],
  [24.652,25.652,37.265,40.04,1.6,2.15],
  [17.538,18.938,9.758,14.858,1.6,2.8],
  [19.143,22.159,10.101,13.245,1.6,2.8],
  [17.676,20.451,18.768,19.768,1.6,2.15],
  [14.53,23.47,-0.9,7.03,1.6,4.86],
  [22.947,25.721,7.871,8.871,1.6,2.15],
  [11.136,13.91,5.458,6.458,1.6,2.15],
  [15.112,22.888,30.836,38.611,1.6,2.5],
  [25.802,26.802,13.27,16.045,1.6,2.15],
  [18.775,25.575,45.278,50.852,1.6,4.55],
  [12.738,15.738,27.378,29.878,1.6,2.4],
  [11.515,12.515,20.763,23.538,1.6,2.15],
  [19.517,22.292,27.683,28.683,1.6,2.15],
  [21.359,24.134,39.176,40.176,1.6,2.15],
  [21.359,24.134,40.7,41.7,1.6,2.15],
  [22.629,25.404,14.919,15.919,1.6,2.15],
  [16.152,18.927,27.175,28.175,1.6,2.15],
  [24.215,25.215,31.368,34.143,1.6,2.15],
  [11.769,12.769,32.891,35.666,1.6,2.15],
  [11.453,14.228,38.351,39.351,1.6,2.15],
  [21.359,24.134,42.224,43.224,1.6,2.15],
  [11.515,12.515,26.922,29.697,1.6,2.15],
  [12.913,15.688,26.286,27.286,1.6,2.15],
  [16.152,18.927,28.445,29.445,1.6,2.15],
  [16.724,19.498,7.49,8.49,1.6,2.15],
  [19.771,22.546,8.188,9.188,1.6,2.15],
  [12.913,15.688,44.764,45.764,1.6,2.15],
  [11.315,12.715,42.093,45.134,1.6,2.6],
  [12.377,17.877,47.764,51.937,1.6,4.1]];
