vicholz/openald/radio_single_board/case/case_params.scad

// AUTO-GENERATED by scripts/gen_case_params.py from kicad/openald.kicad_pcb -- do not edit
pcb_w = 38.0;
pcb_h = 87.0;
pcb_r = 3.0;
pcb_t = 1.6;
holes = [[3.2, 83.8], [34.8, 83.8], [3.2, 3.2], [34.8, 3.2]];
top_boss_room = 2.97;
bot_boss_room = 4.56;
jack_xy = [11.5, 87.0];
jack_axis_h = 2.5;
wheel_xy = [33.6, 61.0];
wheel_r = 7.25;
wheel_z0 = 2.0;
wheel_z1 = 4.0;
bar_win_xy = [[19.0, 75.3], [19.0, 78.1], [19.0, 80.9]];
bar_leds = [[19.0, 73.0], [19.0, 78.1], [19.0, 80.9]];
led_rot = [0, 0, 0, 0, 0];
sw_on_y = 24.25;
sw_off_y = 21.75;
sw_tip_x = 43.3;
sw_face_x = 38.3;
sw_act_w = 3.5;
sw_act_z0 = 2.25;
sw_act_z1 = 4.75;
sw_body_h = 6.0;
usb_xy = [19.0, 2.75];
usb_w = 8.94;
usb_h = 3.26;
chg_leds = [[7.4, 5.2], [11.4, 5.2]];
holder_box = [7.77, 30.24, 8.41, 87.69];
holder_h = 21.31;
top_tallest = 6.0;
