vicholz/openald/(list of files, cad)

Other CAD files:
charging_dock/case/floor_pads/dock_floor_pad_slot6.stl
charging_dock/case/floor_pads/dock_floor_pad_slot4.stl
charging_dock/case/floor_pads/dock_floor_pad_slot5.stl
charging_dock/case/floor_pads/dock_floor_pad_slot3.stl
charging_dock/case/floor_pads/dock_floor_pad_slot1.stl
radio_single_board/case/nut_variant/case_top_nut.stl
radio_single_board/case/nut_variant/case_bottom_nut.stl
