vicholz/openald/charging_dock/previews/dock_assembly.png

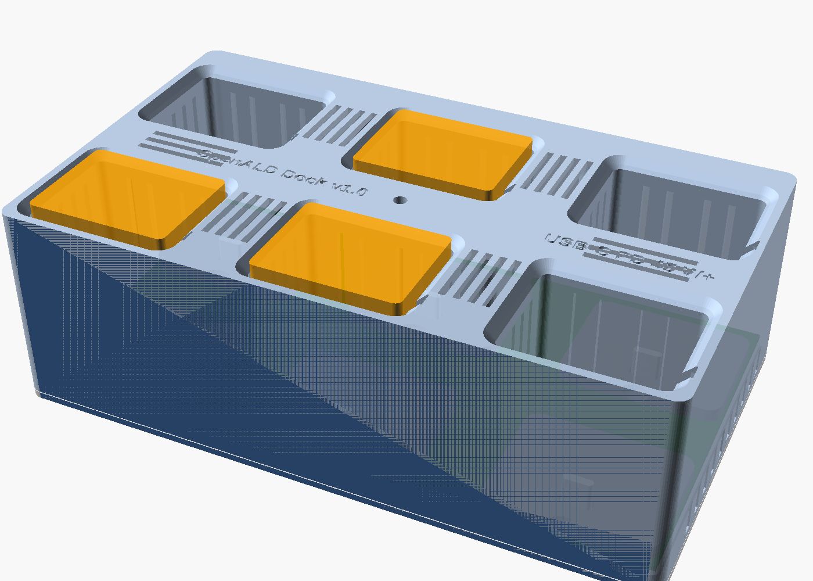
charging_dock/previews/dock_assembly.png
