vicholz/openald/charging_dock/previews/dock_assembly_rear.png

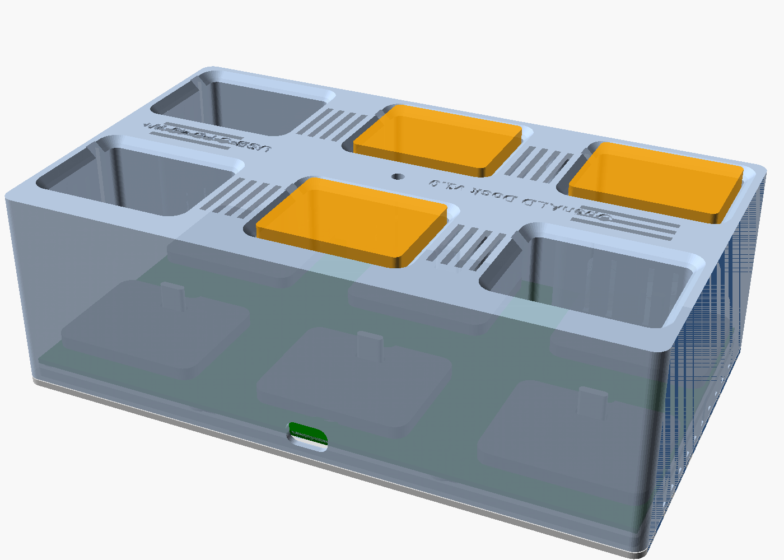
charging_dock/previews/dock_assembly_rear.png
