vicholz/openald/charging_dock/previews/dock_print_layout.png

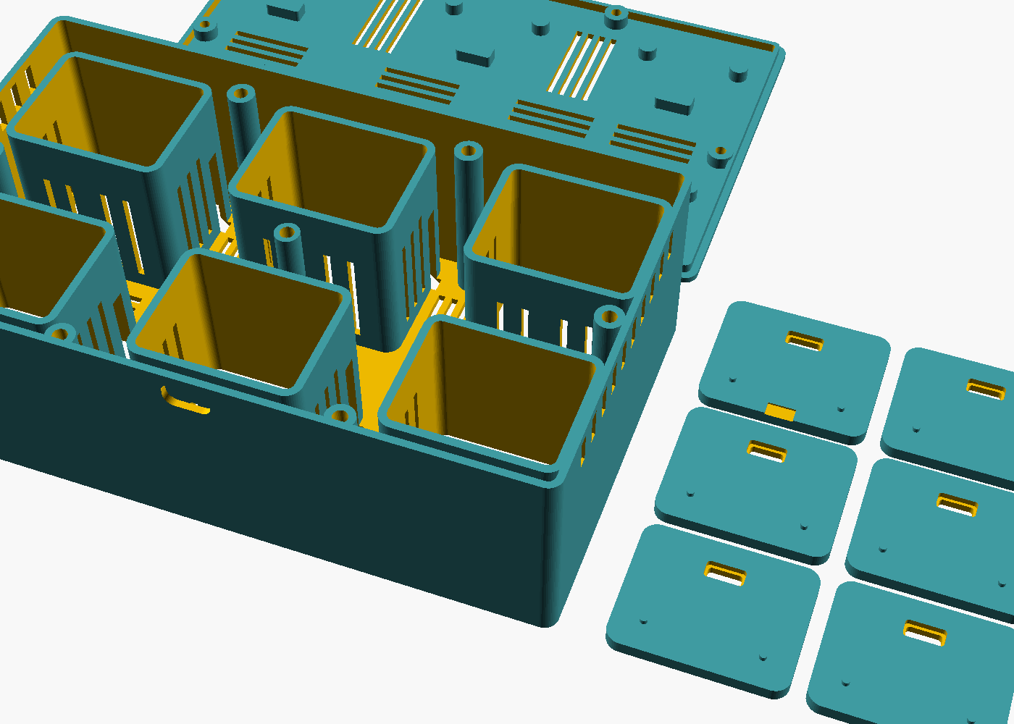
charging_dock/previews/dock_print_layout.png
