vicholz/openald/radio_adafruit_feather_rp2040/docs/wiring_diagram.png

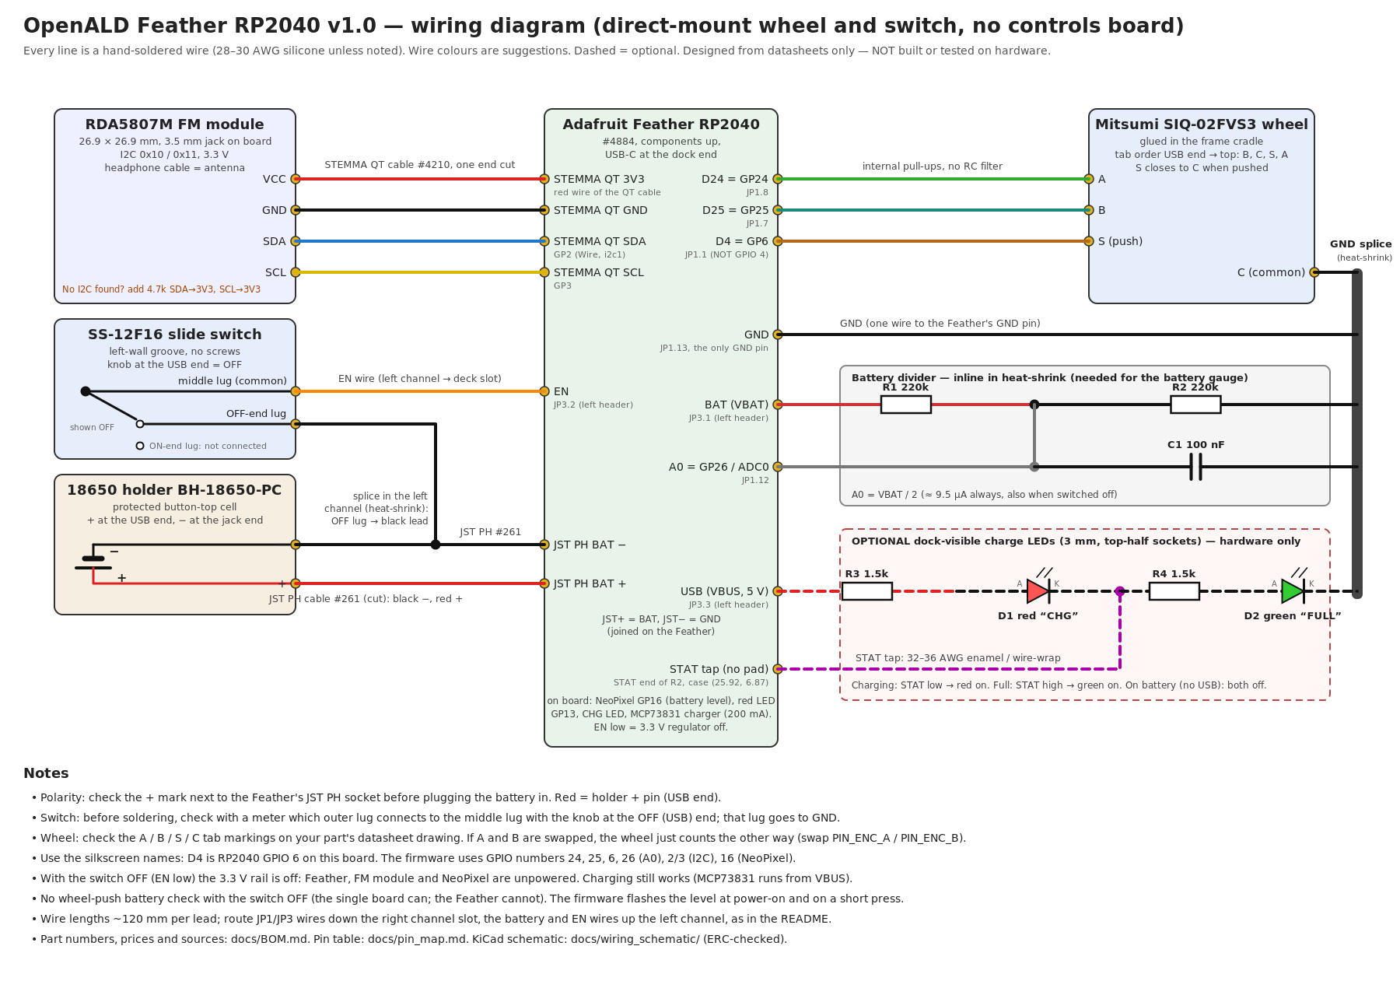
radio_adafruit_feather_rp2040/docs/wiring_diagram.png
