vicholz/openald/radio_adafruit_feather_rp2040/previews/case_print_layout.png

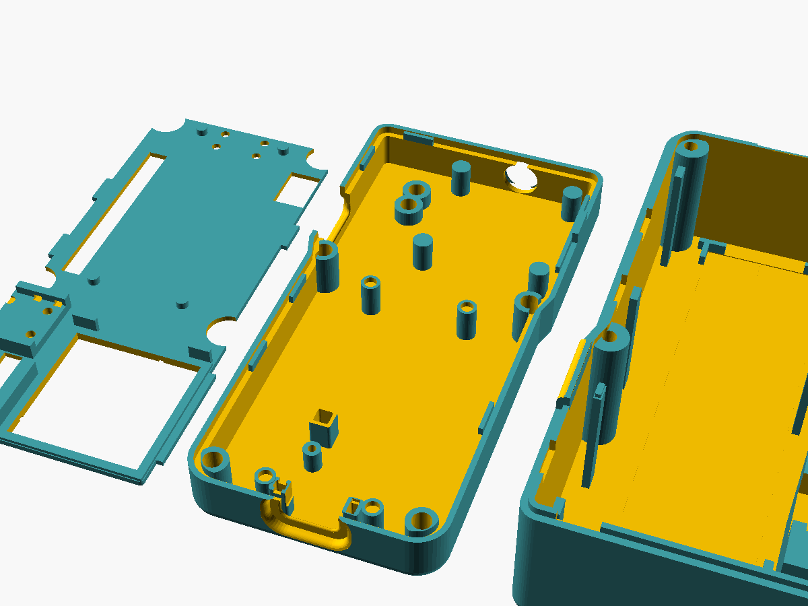
radio_adafruit_feather_rp2040/previews/case_print_layout.png
