vicholz/openald/radio_single_board/previews/case_assembly_back.png

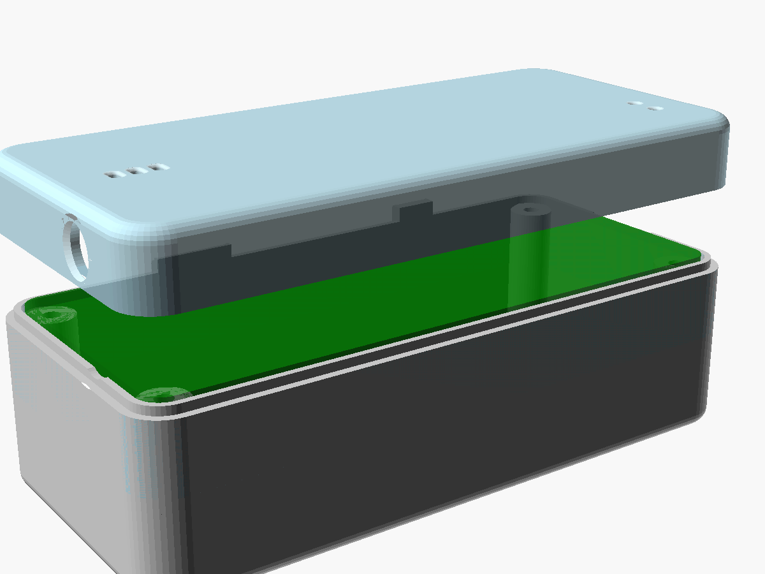
radio_single_board/previews/case_assembly_back.png
