vicholz/openald/radio_single_board/previews/case_assembly_exploded.png

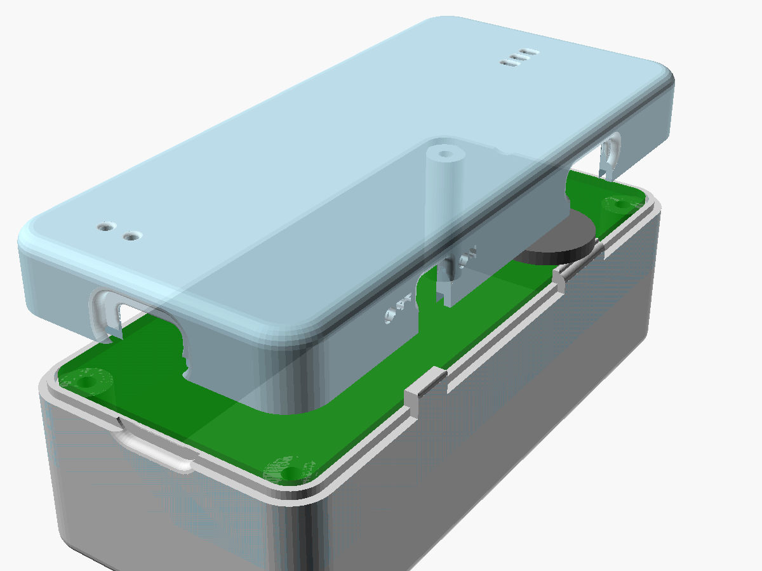
radio_single_board/previews/case_assembly_exploded.png
