vicholz/openald/radio_single_board/previews/case_print_layout.png

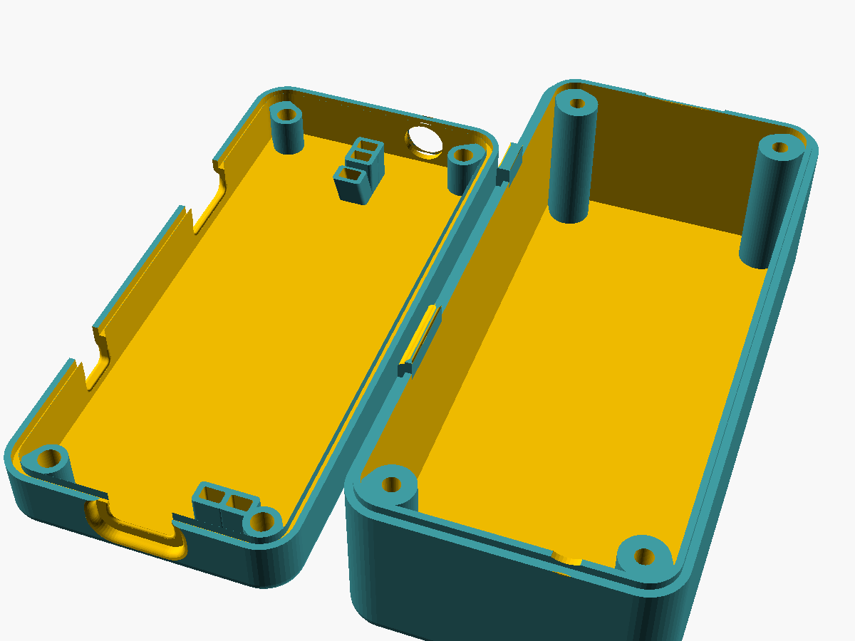
radio_single_board/previews/case_print_layout.png
