vicholz/openald/charging_dock/docs/openald-dock-schematic.pdf

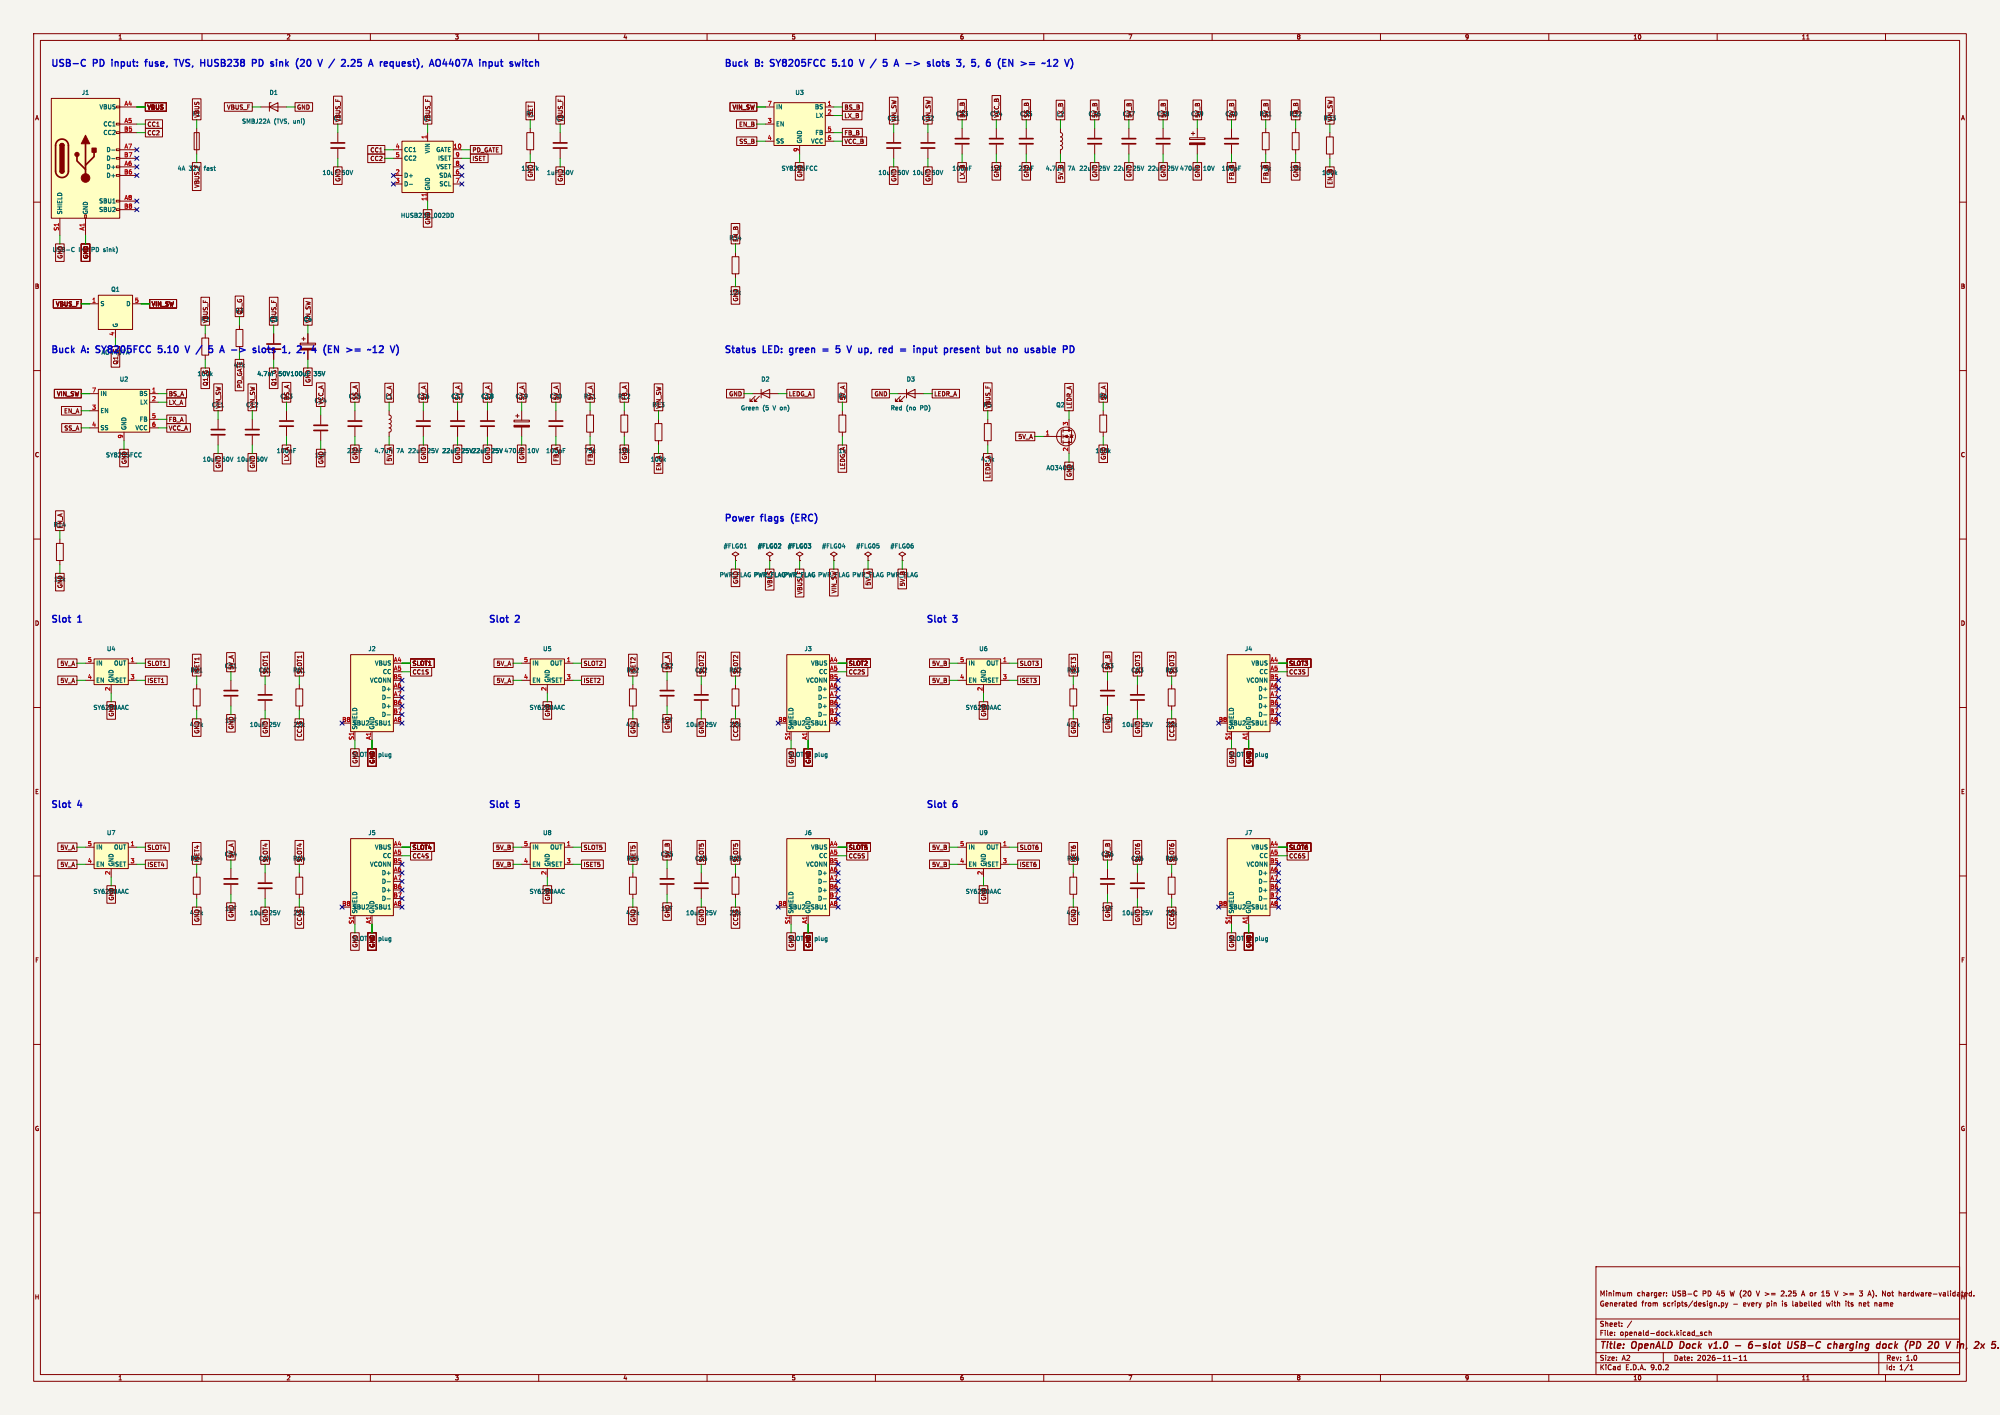
[picture p86: page 1]

J1 USB-C IN (PD sink)

ISET 9 VSET 8 SDA 6 SCL 7 U1 HUSB238_002DD

Status LED: green = 5 V up, red = input present but no usable PD
