vicholz/openald/radio_adafruit_feather_rp2040/docs/wiring_schematic/openald-feather-wiring.pdf

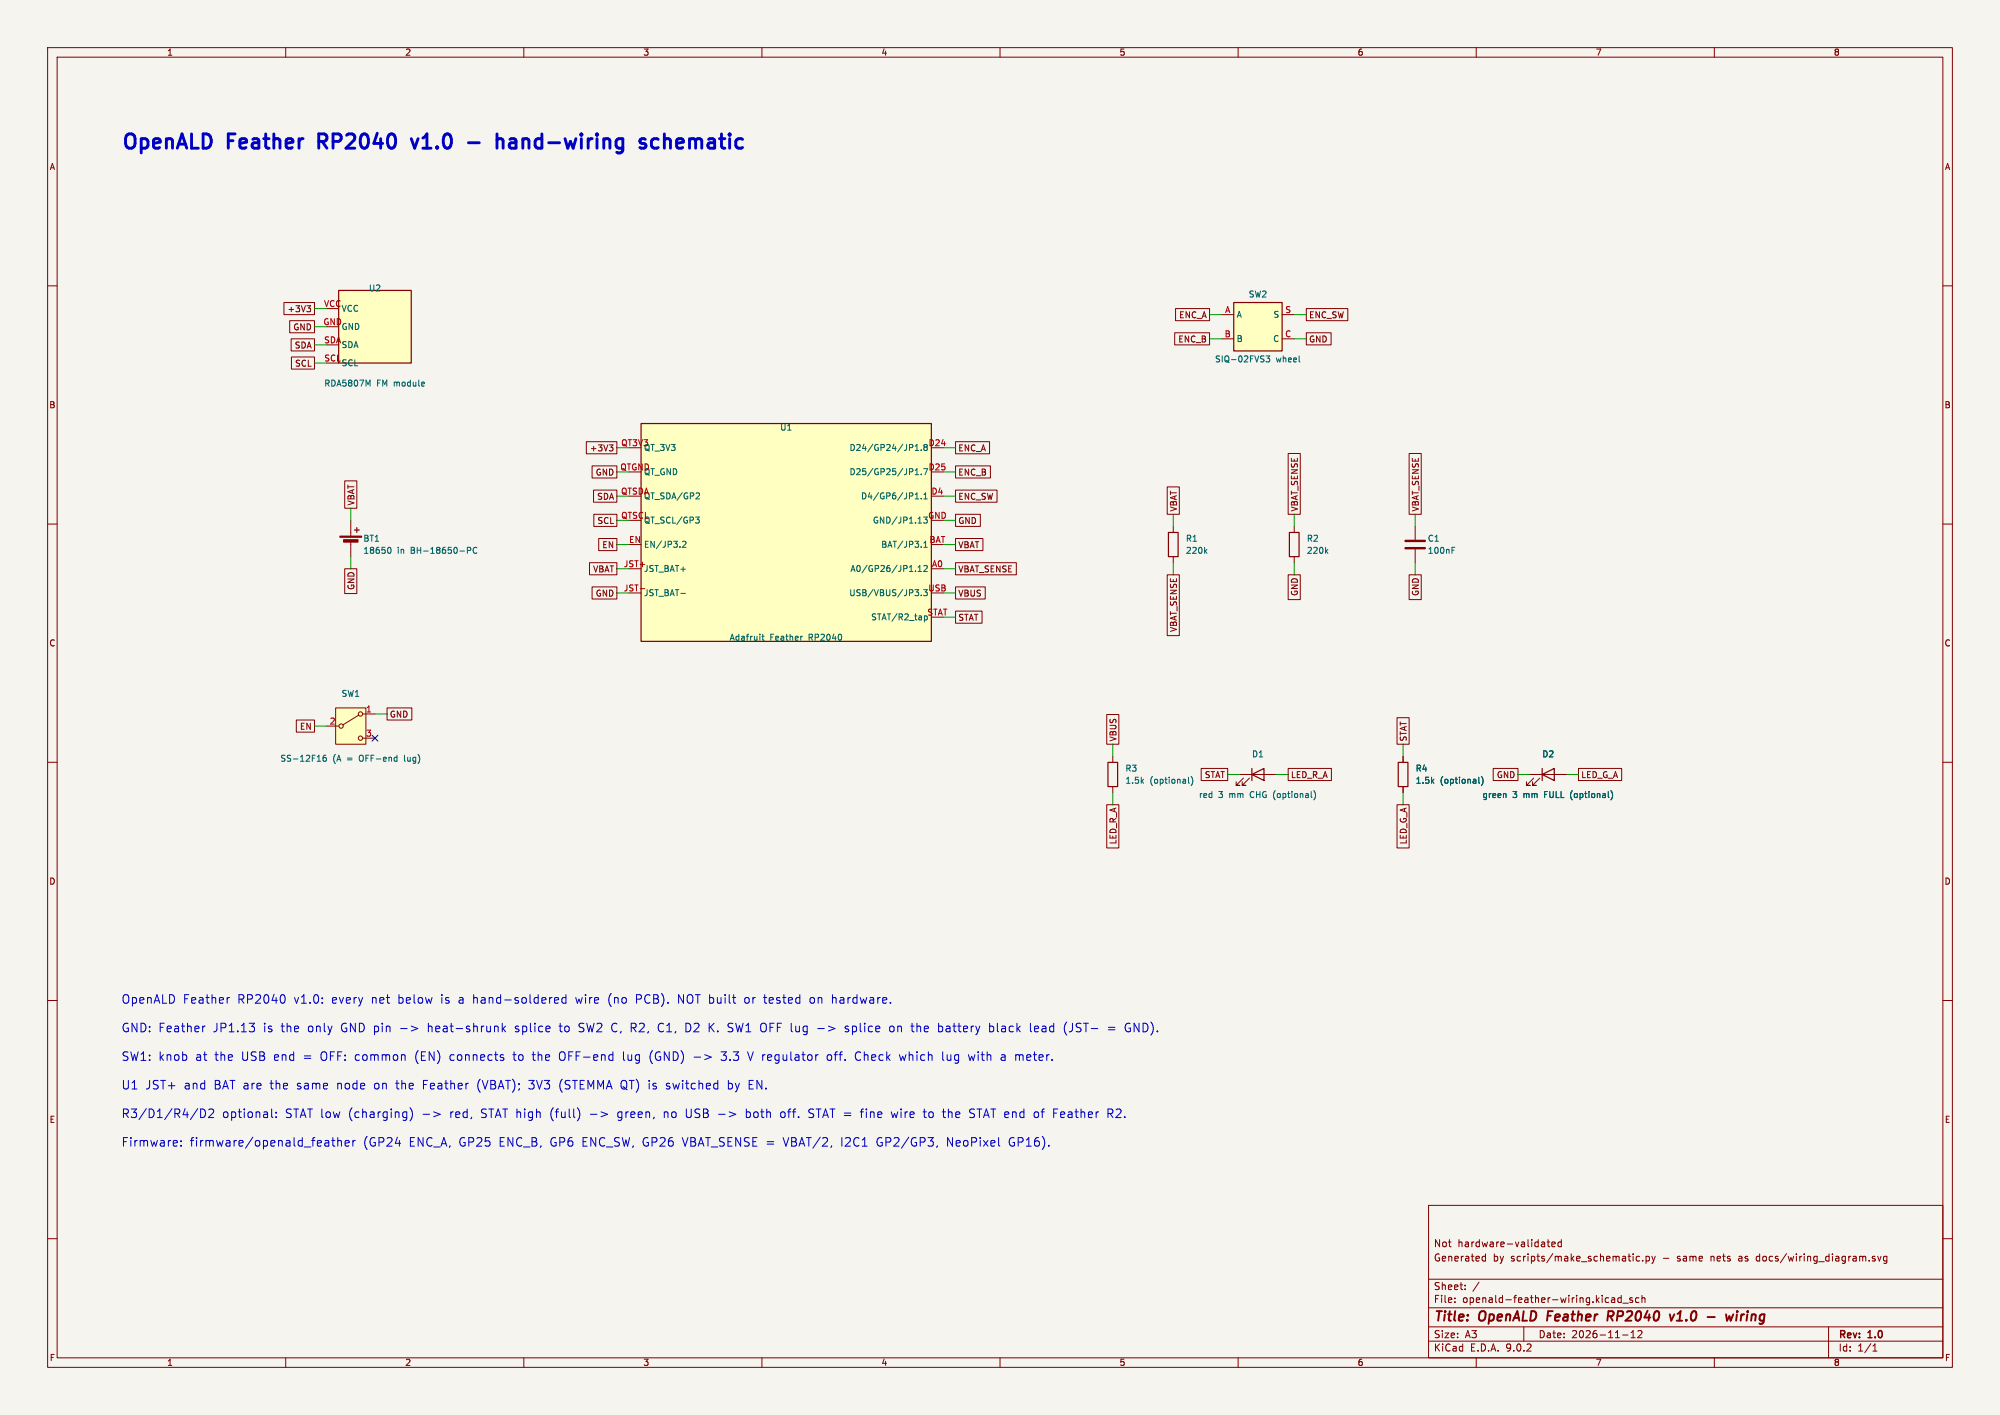
[picture p87: page 1]

STAT/R2_tap STAT U1 Adafruit Feather RP2040 SCL GND

green 3 mm FULL (optional) BT1

green 3 mm FULL (optional)

U1 JST+ and BAT are the same node on the Feather (VBAT); 3V3 (STEMMA QT) is switched by EN.

Id: 1/1 Title: OpenALD Feather RP2040 v1.0 - wiring
