vicholz/openald/radio_single_board/docs/openald-schematic.pdf

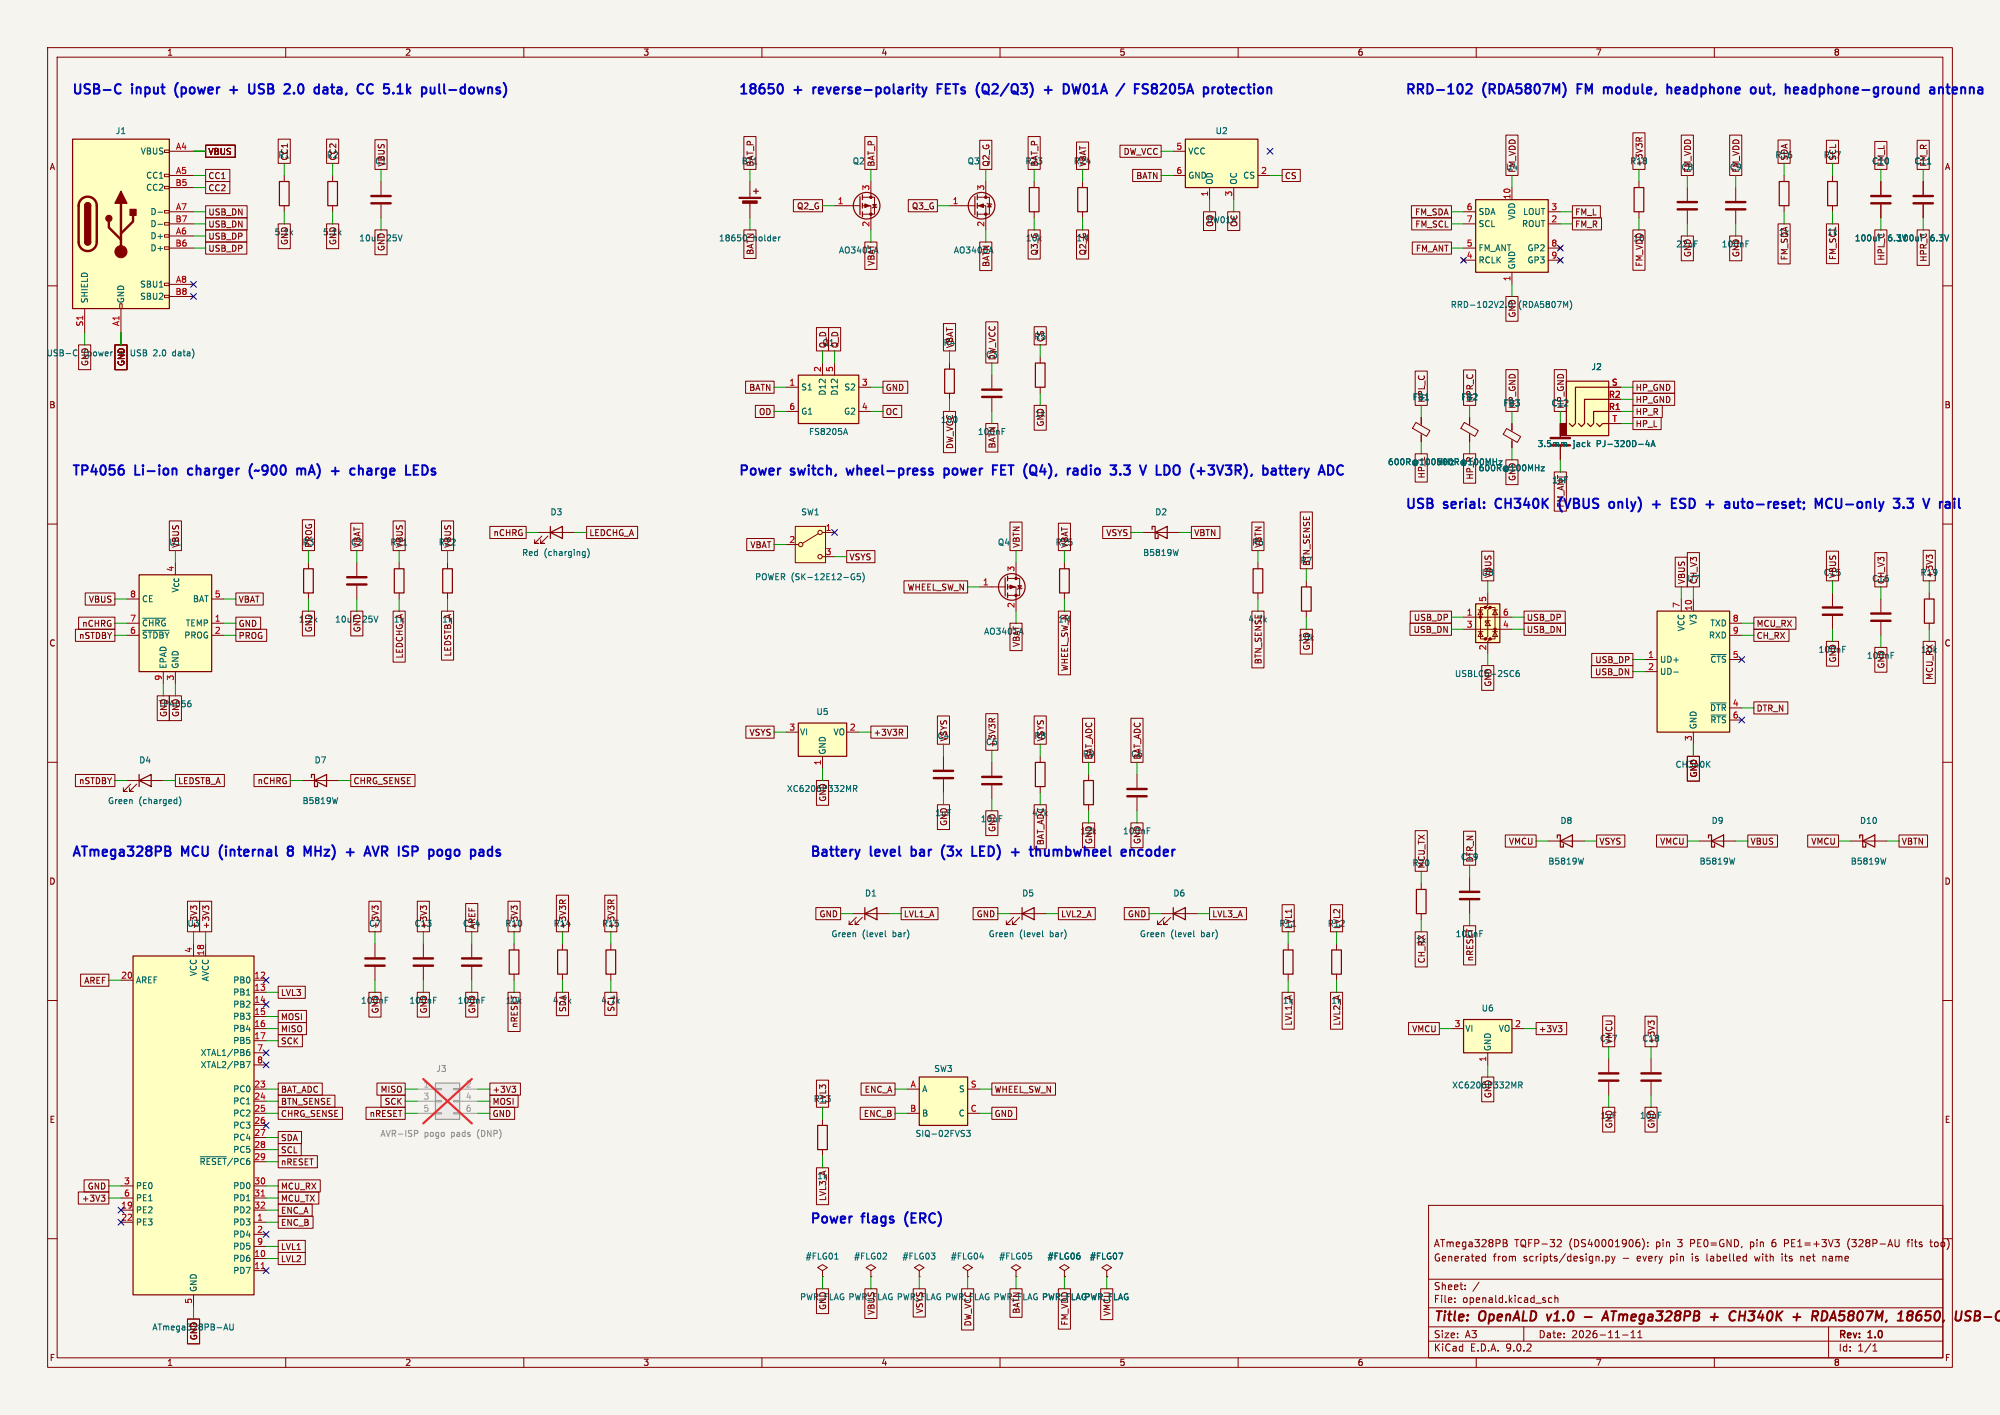
[picture p88: page 1]
