vicholz/openald/(list of files, drawings)

Other design files:
tools/easyeda/C1002.json
tools/easyeda/C1588.json
tools/easyeda/C2286.json
tools/easyeda/C4216.json
tools/easyeda/C5446.json
tools/easyeda/C7519.json
tools/easyeda/C8598.json
tools/easyeda/C12624.json
tools/easyeda/C13585.json
tools/easyeda/C14663.json
tools/easyeda/C14858.json
tools/easyeda/C14877.json
tools/easyeda/C15008.json
tools/easyeda/C15127.json
tools/easyeda/C15849.json
tools/easyeda/C15850.json
tools/easyeda/C16072.json
tools/easyeda/C16581.json
tools/easyeda/C17673.json
tools/easyeda/C19702.json
tools/easyeda/C20917.json
tools/easyeda/C21122.json
tools/easyeda/C21190.json
tools/easyeda/C22765.json
tools/easyeda/C22775.json
tools/easyeda/C22790.json
tools/easyeda/C22793.json
tools/easyeda/C22843.json
tools/easyeda/C22859.json
tools/easyeda/C22935.json
tools/easyeda/C22961.json
tools/easyeda/C23162.json
tools/easyeda/C23186.json
tools/easyeda/C23242.json
tools/easyeda/C25803.json
tools/easyeda/C25804.json
tools/easyeda/C25819.json
tools/easyeda/C31850.json
tools/easyeda/C45783.json
tools/easyeda/C53987.json
tools/easyeda/C55136.json
tools/easyeda/C79167.json
tools/easyeda/C95562.json
tools/easyeda/C111875.json
tools/easyeda/C132230.json
tools/easyeda/C136720.json
tools/easyeda/C144333.json
tools/easyeda/C151920.json
tools/easyeda/C165948.json
tools/easyeda/C187596.json
tools/easyeda/C283539.json
tools/easyeda/C351410.json
tools/easyeda/C408457.json
tools/easyeda/C530607.json
tools/easyeda/C968586.json
tools/easyeda/C2830320.json
tools/easyeda/C2858856.json
tools/easyeda/C2895269.json
tools/easyeda/C2909200.json
tools/easyeda/C2925423.json
tools/easyeda/C3151751.json
tools/easyeda/C5370429.json
tools/easyeda/C7471904.json
tools/easyeda/C24833806.json
tools/easyeda/C52741990.json
