vicholz/openald/radio_single_board/kicad/openald.kicad_pcb

## KiCad design radio_single_board/kicad/openald.kicad_pcb (2026-11-13)

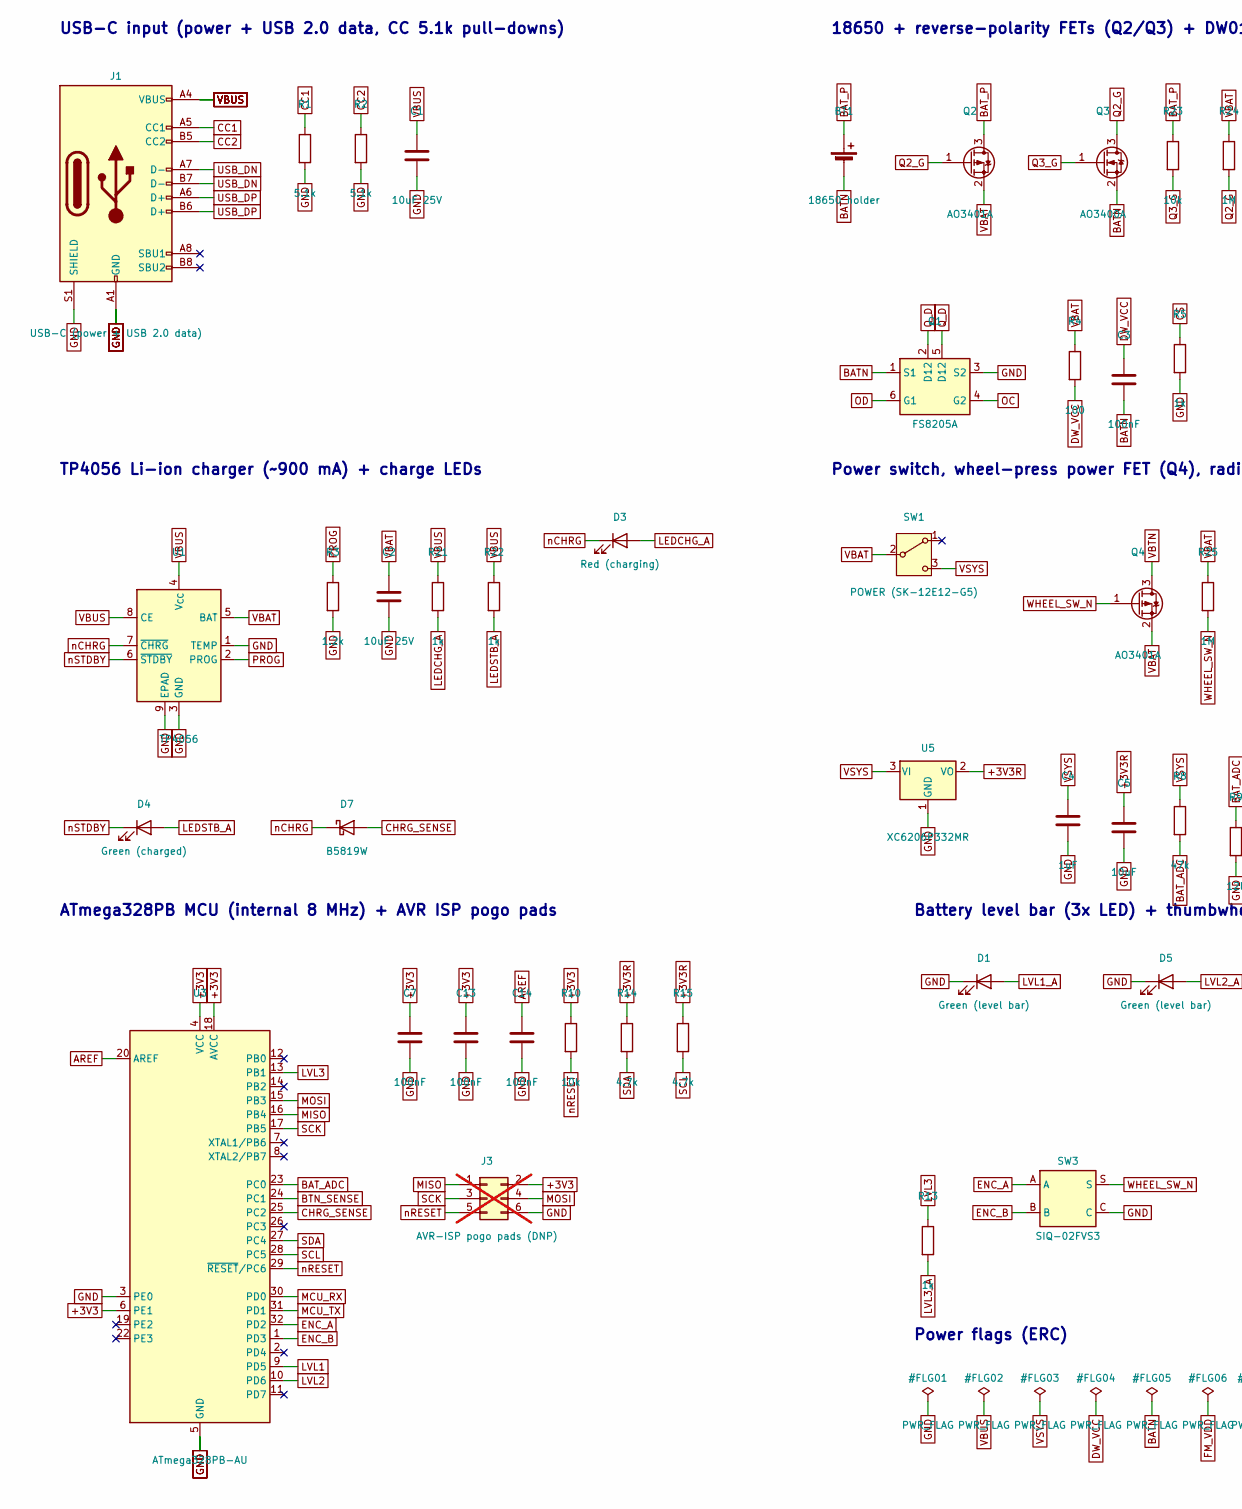
[picture p89: schematic openald.kicad_sch, OpenALD v1.0 - ATmega328PB + CH340K + RDA5807M, 18650, USB-C, part in row 1, column 1]

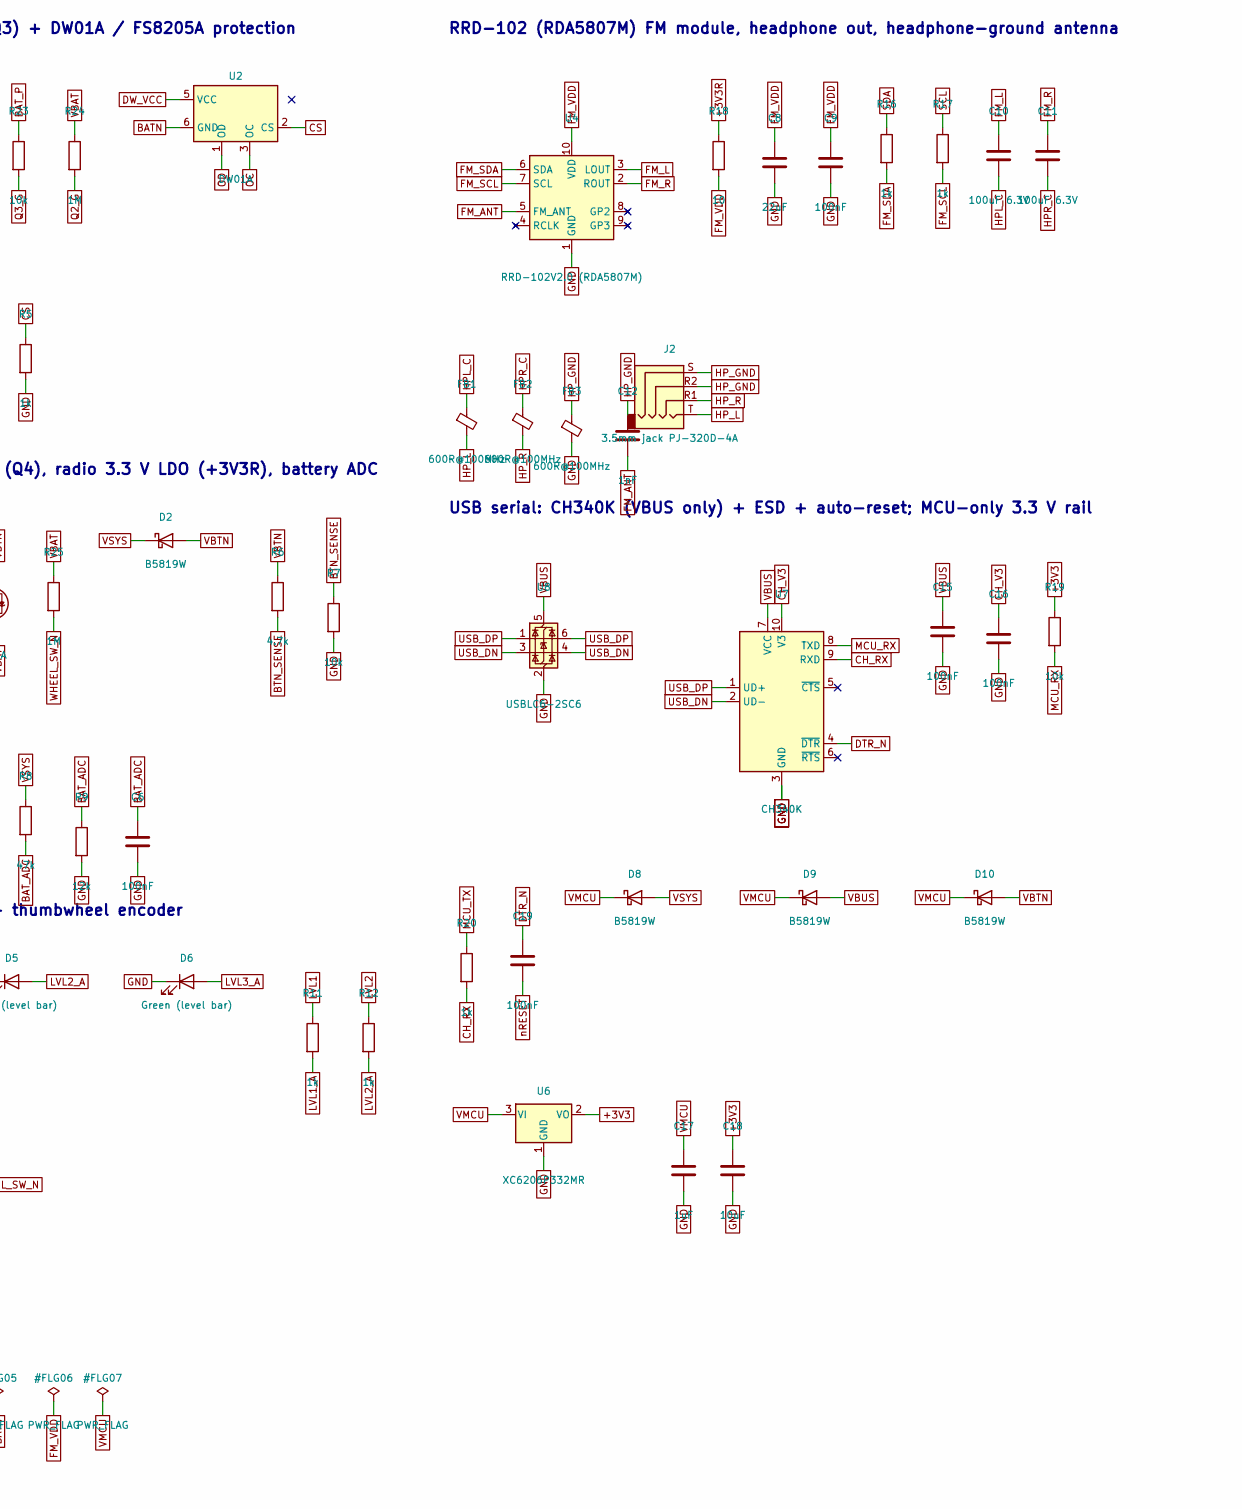
[picture p90: schematic openald.kicad_sch, OpenALD v1.0 - ATmega328PB + CH340K + RDA5807M, 18650, USB-C, part in row 1, column 2]

Parts:
BT1: 18650 holder; BatteryHolder_MPD_BH-18650-PC; MPN MPD BH-18650-PC
C1, C2: 10uF 25V; C_0805_2012Metric; MPN CL21A106KAYNNNE; LCSC C15850
C3, C6, C7, C9, C13, C14, C15, C16, C19: 100nF; C_0603_1608Metric; MPN CC0603KRX7R9BB104; LCSC C14663
C4, C17: 1uF; C_0603_1608Metric; MPN CL10A105KB8NNNC; LCSC C15849
C5, C18: 10uF; C_0603_1608Metric; MPN CL10A106KP8NNNC; LCSC C19702
C8: 22uF; C_0805_2012Metric; MPN CL21A226MAQNNNE; LCSC C45783
C10, C11: 100uF 6.3V; C_1206_3216Metric; MPN CL31A107MQHNNNE; LCSC C15008
C12: 1nF; C_0603_1608Metric; MPN CL10B102KB8NNNC; LCSC C1588
D1, D5, D6: Green (level bar); LED_0603_1608Metric; MPN KT-0603G; LCSC C12624
D2, D7, D8, D9, D10: B5819W; D_SOD-123; MPN B5819W SL; LCSC C8598
D3: Red (charging); LED_0603_1608Metric; MPN KT-0603R; LCSC C2286
D4: Green (charged); LED_0603_1608Metric; MPN KT-0603G; LCSC C12624
FB1, FB2, FB3: 600R@100MHz; L_0603_1608Metric; MPN GZ1608D601TF; LCSC C1002
J1: USB-C (power + USB 2.0 data); USB_C_Receptacle_HRO_TYPE-C-31-M-12; MPN HRO TYPE-C-31-M-12; LCSC C165948
J2: 3.5mm jack PJ-320D-4A; Jack_3.5mm_KoreanHropartsElec_PJ-320D-4A_Horizontal; MPN HRO PJ-320D-4A; LCSC C95562
J3: AVR-ISP pogo pads (DNP); PinHeader_2x03_P2.54mm_Vertical; MPN 2x3 2.54mm header / pogo (DNP); not fitted
Q1: FS8205A; SOT-23-6; MPN FS8205A (TECH PUBLIC); LCSC C2830320
Q2, Q4: AO3401A; SOT-23; MPN AOS AO3401A; LCSC C15127
Q3: AO3400A; SOT-23; MPN AOS AO3400A; LCSC C20917
R1, R2: 5.1k; R_0603_1608Metric; MPN 0603WAF5101T5E; LCSC C23186
R3: 1.2k; R_0603_1608Metric; MPN 0603WAF1201T5E; LCSC C22765
R4: 100; R_0603_1608Metric; MPN 0603WAF1000T5E; LCSC C22775
R5, R11, R12, R13, R16, R17, R20, R21, R22: 1k; R_0603_1608Metric; MPN 0603WAF1001T5E; LCSC C21190
R6, R14, R15: 4.7k; R_0603_1608Metric; MPN 0603WAF4701T5E; LCSC C23162
R7, R10, R19, R23: 10k; R_0603_1608Metric; MPN 0603WAF1002T5E; LCSC C25804
R8: 47k; R_0603_1608Metric; MPN 0603WAF4702T5E; LCSC C25819
R9: 12k; R_0603_1608Metric; MPN 0603WAF1202T5E; LCSC C22790
R18: 10; R_0603_1608Metric; MPN 0603WAF100JT5E; LCSC C22859
R24, R25: 1M; R_0603_1608Metric; MPN 0603WAF1004T5E; LCSC C22935
SW1: POWER (SK-12E12-G5); SW_Slide_SPDT_Angled_HRO_SK-12E12-G5; MPN HRO SK-12E12-G5; LCSC C136720
SW3: SIQ-02FVS3; Mitsumi_SIQ-02FVS3; MPN Mitsumi SIQ-02FVS3; LCSC C2925423
U1: TP4056; SOIC-8-1EP_3.9x4.9mm_P1.27mm_EP2.41x3.3mm; MPN TP4056-42-ESOP8; LCSC C16581
U2: DW01A; SOT-23-6; MPN DW01A (PUOLOP); LCSC C351410
U3: ATmega328PB-AU; TQFP-32_7x7mm_P0.8mm; MPN ATMEGA328PB-AU; LCSC C132230
U4: RRD-102V2.0 (RDA5807M); RRD-102_RDA5807M_Module; MPN RRD-102V2.0 RDA5807M module
U5, U6: XC6206P332MR; SOT-23-3; MPN XC6206P332MR-G; LCSC C5446
U7: CH340K; SSOP-10-1EP_3.9x4.9mm_P1mm_EP2.1x3.3mm; MPN WCH CH340K; LCSC C968586
U8: USBLC6-2SC6; SOT-23-6; MPN ST USBLC6-2SC6; LCSC C7519

Connections:
+3V3: C7.1, C13.1, C18.1, J3.2, R10.1, R19.1, U3.4 (VCC), U3.6 (PE1), U3.18 (AVCC), U6.2 (VO)
+3V3R: C5.1, R14.1, R15.1, R18.1, U5.2 (VO)
AREF: C14.1, U3.20 (AREF)
BATN: BT1.2 (-), C3.2, Q1.1 (S1), Q3.2 (S), U2.6 (GND)
BAT_ADC: C6.1, R8.2, R9.1, U3.23 (PC0)
BAT_P: BT1.1 (+), Q2.3 (D), R23.1
BTN_SENSE: R6.2, R7.1, U3.24 (PC1)
CC1: J1.A5 (CC1), R1.1
CC2: J1.B5 (CC2), R2.1
CHRG_SENSE: D7.2 (A), U3.25 (PC2)
CH_RX: R20.2, U7.9 (RXD)
CH_V3: C16.1, U7.10 (V3)
CS: R5.1, U2.2 (CS)
DTR_N: C19.1, U7.4 (~DTR)
DW_VCC: C3.1, R4.2, U2.5 (VCC)
ENC_A: SW3.A, U3.32 (PD2)
ENC_B: SW3.B, U3.1 (PD3)
FM_ANT: C12.2, U4.5 (FM_ANT)
FM_L: C10.1, U4.3 (LOUT)
FM_R: C11.1, U4.2 (ROUT)
FM_SCL: R17.2, U4.7 (SCL)
FM_SDA: R16.2, U4.6 (SDA)
FM_VDD: C8.1, C9.1, R18.2, U4.10 (VDD)
GND: C1.2, C2.2, C4.2, C5.2, C6.2, C7.2, C8.2, C9.2, C13.2, C14.2, C15.2, C16.2, C17.2, C18.2, D1.1 (K), D5.1 (K), D6.1 (K), FB3.2, J1.A1 (GND), J1.A12 (GND), J1.B1 (GND), J1.B12 (GND), J1.S1 (SHIELD), J3.6, Q1.3 (S2), R1.2, R2.2, R3.2, R5.2, R7.2, R9.2, SW3.C, U1.1 (TEMP), U1.3 (GND), U1.9 (EPAD), U3.3 (PE0), U3.5 (GND), U3.21 (GND), U4.1 (GND), U5.1 (GND), U6.1 (GND), U7.3 (GND), U7.11 (GND), U8.2 (GND)
HPL_C: C10.2, FB1.1
HPR_C: C11.2, FB2.1
HP_GND: C12.1, FB3.1, J2.R2, J2.S
HP_L: FB1.2, J2.T
HP_R: FB2.2, J2.R1
LEDCHG_A: D3.2 (A), R21.2
LEDSTB_A: D4.2 (A), R22.2
LVL1: R11.1, U3.9 (PD5)
LVL1_A: D1.2 (A), R11.2
LVL2: R12.1, U3.10 (PD6)
LVL2_A: D5.2 (A), R12.2
LVL3: R13.1, U3.13 (PB1)
LVL3_A: D6.2 (A), R13.2
MCU_RX: R19.2, U3.30 (PD0), U7.8 (TXD)
MCU_TX: R20.1, U3.31 (PD1)
MISO: J3.1, U3.16 (PB4)
MOSI: J3.4, U3.15 (PB3)
OC: Q1.4 (G2), U2.3 (OC)
OD: Q1.6 (G1), U2.1 (OD)
PROG: R3.1, U1.2 (PROG)
Q2_G: Q2.1 (G), Q3.3 (D), R24.2
Q3_G: Q3.1 (G), R23.2
Q_D: Q1.2 (D12), Q1.5 (D12)
SCK: J3.3, U3.17 (PB5)
SCL: R15.2, R17.1, U3.28 (PC5)
SDA: R14.2, R16.1, U3.27 (PC4)
USB_DN: J1.A7 (D-), J1.B7 (D-), U7.2 (UD-), U8.3 (I/O2), U8.4 (I/O2)
USB_DP: J1.A6 (D+), J1.B6 (D+), U7.1 (UD+), U8.1 (I/O1), U8.6 (I/O1)
VBAT: C2.1, Q2.2 (S), Q4.2 (S), R4.1, R24.1, R25.1, SW1.2 (B), U1.5 (BAT)
VBTN: D2.2 (A), D10.2 (A), Q4.3 (D), R6.1
VBUS: C1.1, C15.1, D9.2 (A), J1.A4 (VBUS), J1.A9 (VBUS), J1.B4 (VBUS), J1.B9 (VBUS), R21.1, R22.1, U1.4 (V_{CC}), U1.8 (CE), U7.7 (VCC), U8.5 (VBUS)
VMCU: C17.1, D8.1 (K), D9.1 (K), D10.1 (K), U6.3 (VI)
VSYS: C4.1, D2.1 (K), D8.2 (A), R8.1, SW1.3 (C), U5.3 (VI)
WHEEL_SW_N: Q4.1 (G), R25.2, SW3.S
nCHRG: D3.1 (K), D7.1 (K), U1.7 (~CHRG)
nRESET: C19.2, J3.5, R10.2, U3.29 (~RESET/PC6)
nSTDBY: D4.1 (K), U1.6 (~STDBY)

Notes on the sheet:
USB-C input (power + USB 2.0 data, CC 5.1k pull-downs)
TP4056 Li-ion charger (~900 mA) + charge LEDs
18650 + reverse-polarity FETs (Q2/Q3) + DW01A / FS8205A protection
Power switch, wheel-press power FET (Q4), radio 3.3 V LDO (+3V3R), battery ADC
ATmega328PB MCU (internal 8 MHz) + AVR ISP pogo pads
Battery level bar (3x LED) + thumbwheel encoder
RRD-102 (RDA5807M) FM module, headphone out, headphone-ground antenna
USB serial: CH340K (VBUS only) + ESD + auto-reset; MCU-only 3.3 V rail
Power flags (ERC)

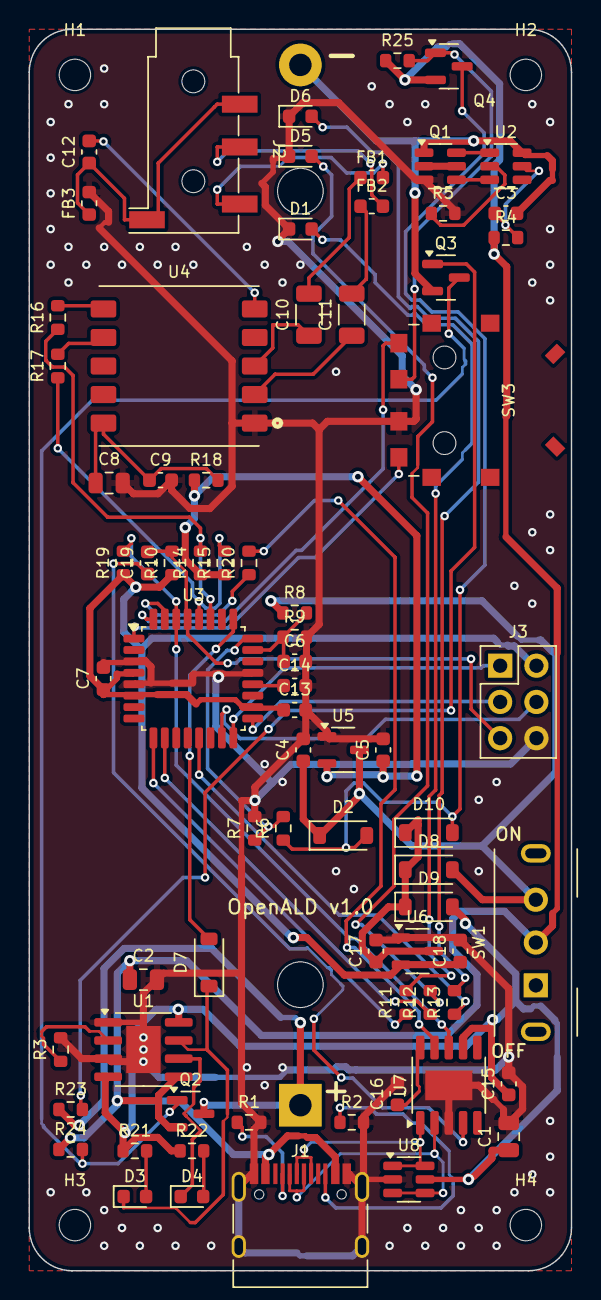
[picture p91: board openald.kicad_pcb from above]

Board: 2 copper layers, 38.0 x 87.0 mm, 79 parts (1 on the bottom side), 61 nets.

Other parts of the board:
H1, H2, H3, H4: M2; MountingHole_2.2mm_M2
