vicholz/openald/radio_adafruit_feather_rp2040/kicad/openald-feather-controls.kicad_pcb

## KiCad design radio_adafruit_feather_rp2040/kicad/openald-feather-controls.kicad_pcb (2026-11-12)

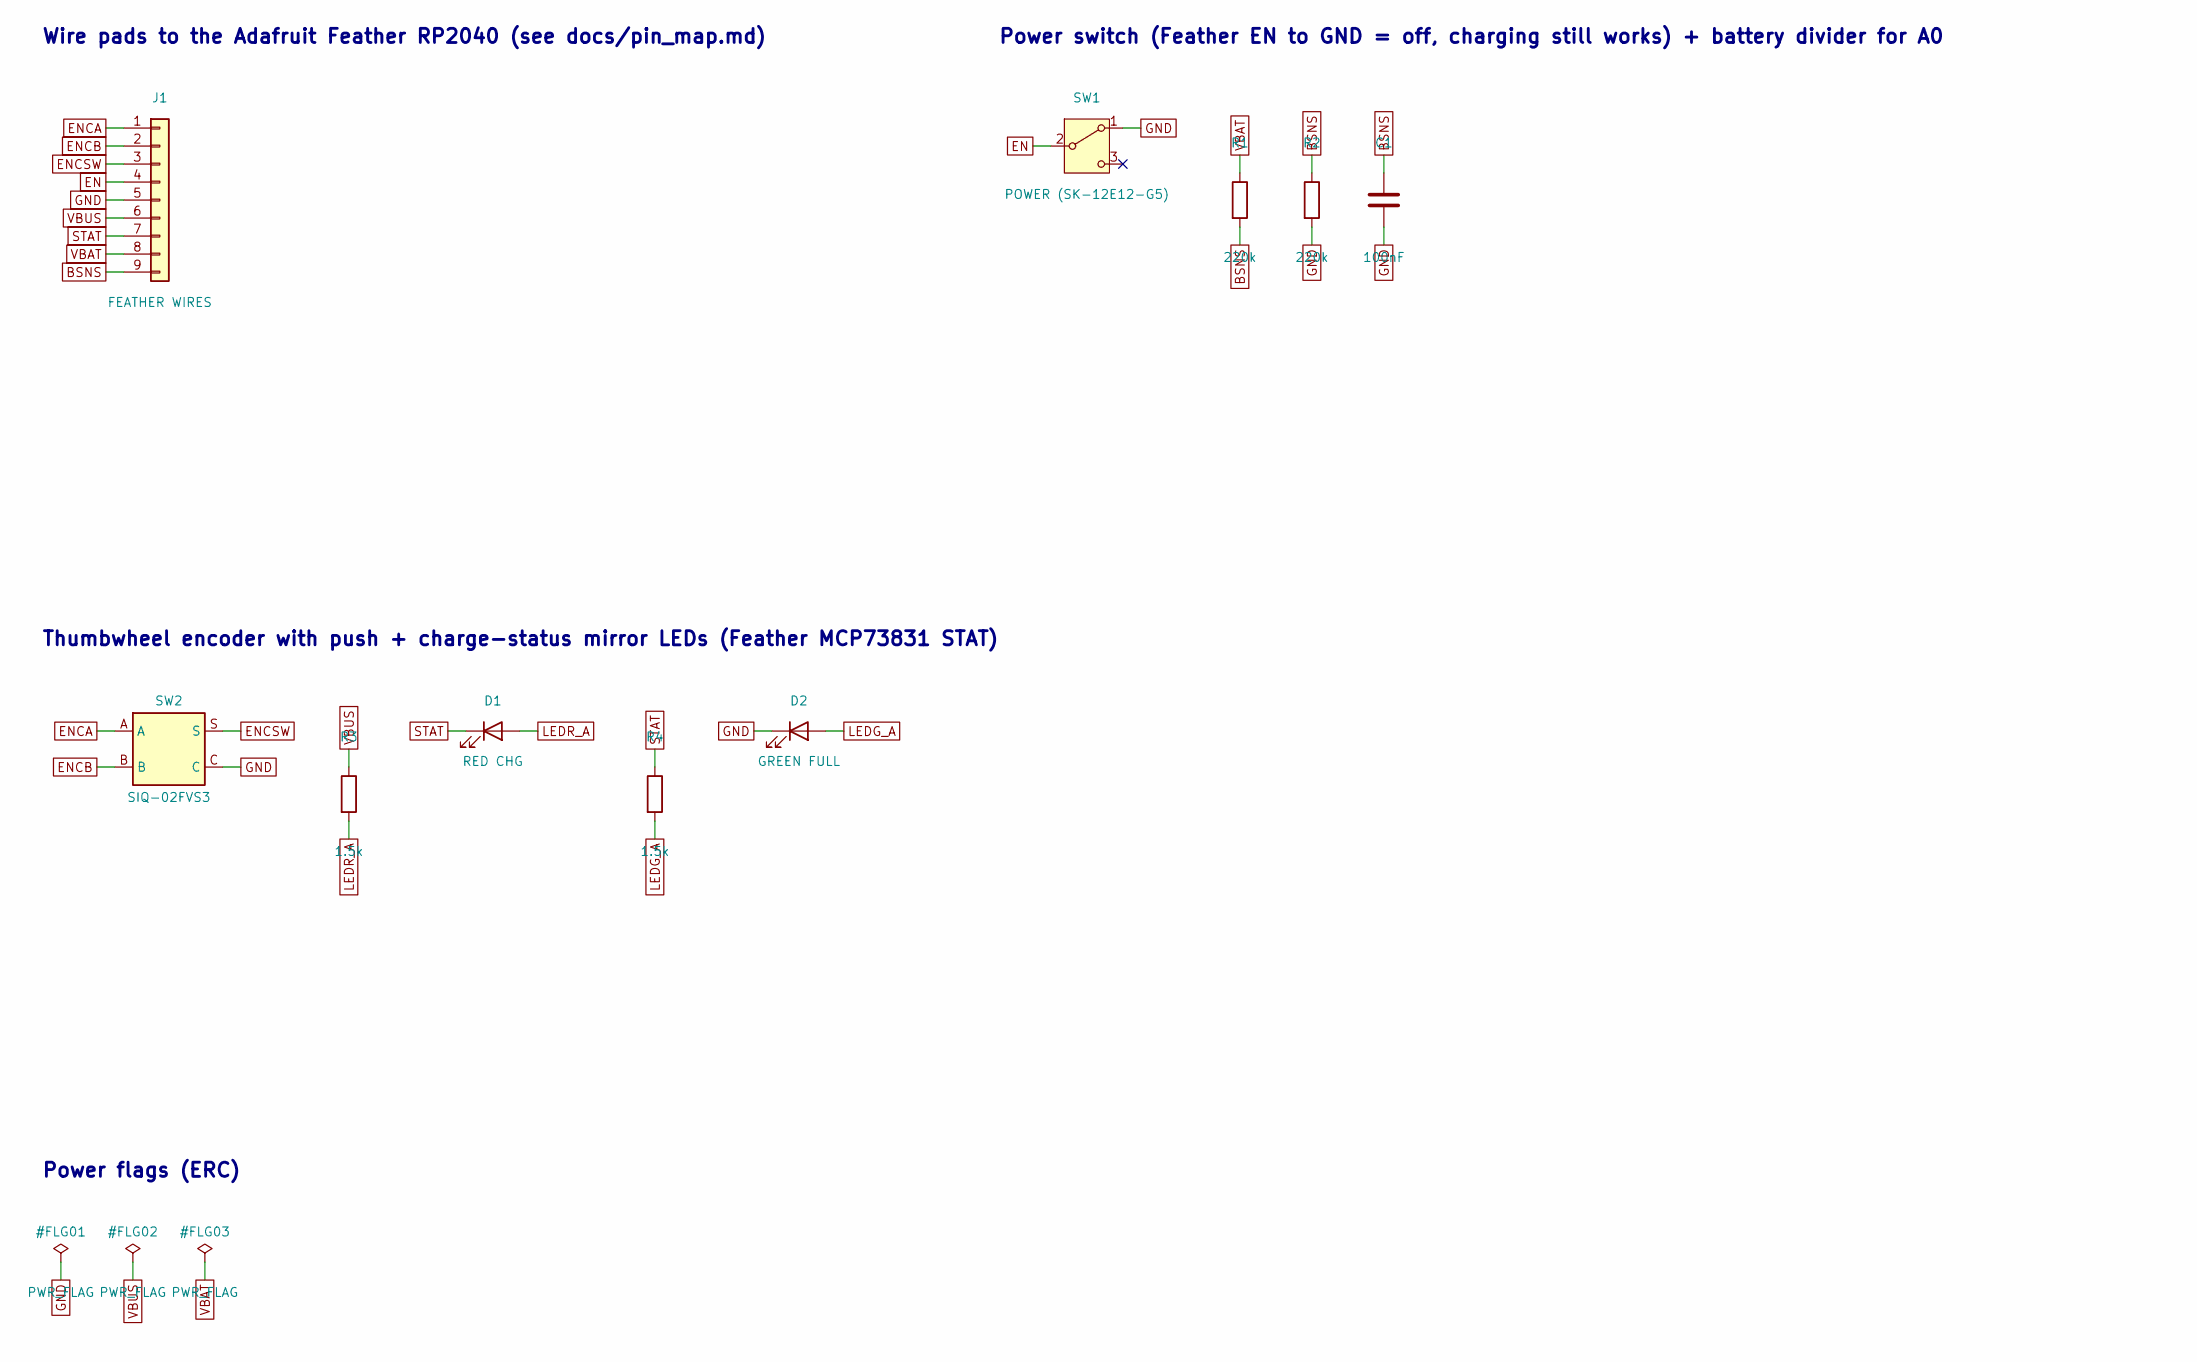
[picture p92: schematic openald-feather-controls.kicad_sch, OpenALD Feather RP2040 v1.0 - controls board (wheel, EN swi…]

Parts:
C1: 100nF; C_0603_1608Metric; MPN Samsung CC0603KRX7R9BB104; LCSC C14663
D1: RED CHG; LED_0603_1608Metric; MPN Hubei KENTO KT-0603R; LCSC C2286
D2: GREEN FULL; LED_0603_1608Metric; MPN Hubei KENTO KT-0603G; LCSC C12624
J1: FEATHER WIRES; WirePads_1x09_P1.80mm; MPN (wire pads)
R1, R2: 220k; R_0603_1608Metric; MPN UNI-ROYAL 0603WAF2203T5E; LCSC C22961
R3, R4: 1.5k; R_0603_1608Metric; MPN UNI-ROYAL 0603WAF1501T5E; LCSC C22843
SW1: POWER (SK-12E12-G5); SW_Slide_SPDT_Angled_HRO_SK-12E12-G5; MPN HRO SK-12E12-G5; LCSC C136720
SW2: SIQ-02FVS3; Mitsumi_SIQ-02FVS3; MPN Mitsumi SIQ-02FVS3; LCSC C2925423

Connections:
BSNS: C1.1, J1.9, R1.2, R2.1
EN: J1.4, SW1.2 (B)
ENCA: J1.1, SW2.A
ENCB: J1.2, SW2.B
ENCSW: J1.3, SW2.S
GND: C1.2, D2.1 (K), J1.5, R2.2, SW1.1 (A), SW2.C
LEDG_A: D2.2 (A), R4.2
LEDR_A: D1.2 (A), R3.2
STAT: D1.1 (K), J1.7, R4.1
VBAT: J1.8, R1.1
VBUS: J1.6, R3.1

Notes on the sheet:
Wire pads to the Adafruit Feather RP2040 (see docs/pin_map.md)
Power switch (Feather EN to GND = off, charging still works) + battery divider for A0
Thumbwheel encoder with push + charge-status mirror LEDs (Feather MCP73831 STAT)
Power flags (ERC)

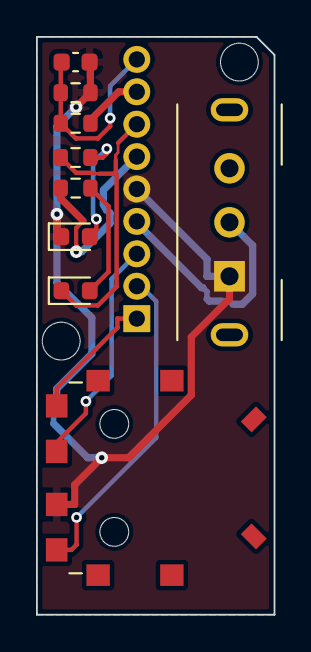
[picture p93: board openald-feather-controls.kicad_pcb from above]

Board: 2 copper layers, 13.2 x 32.1 mm, 12 parts (0 on the bottom side), 11 nets.

Other parts of the board:
H1, H2: PEG 2.1; PegHole_2.1mm
