vicholz/openald/charging_dock/kicad/openald-dock.kicad_pcb

## KiCad design charging_dock/kicad/openald-dock.kicad_pcb (2026-11-12)

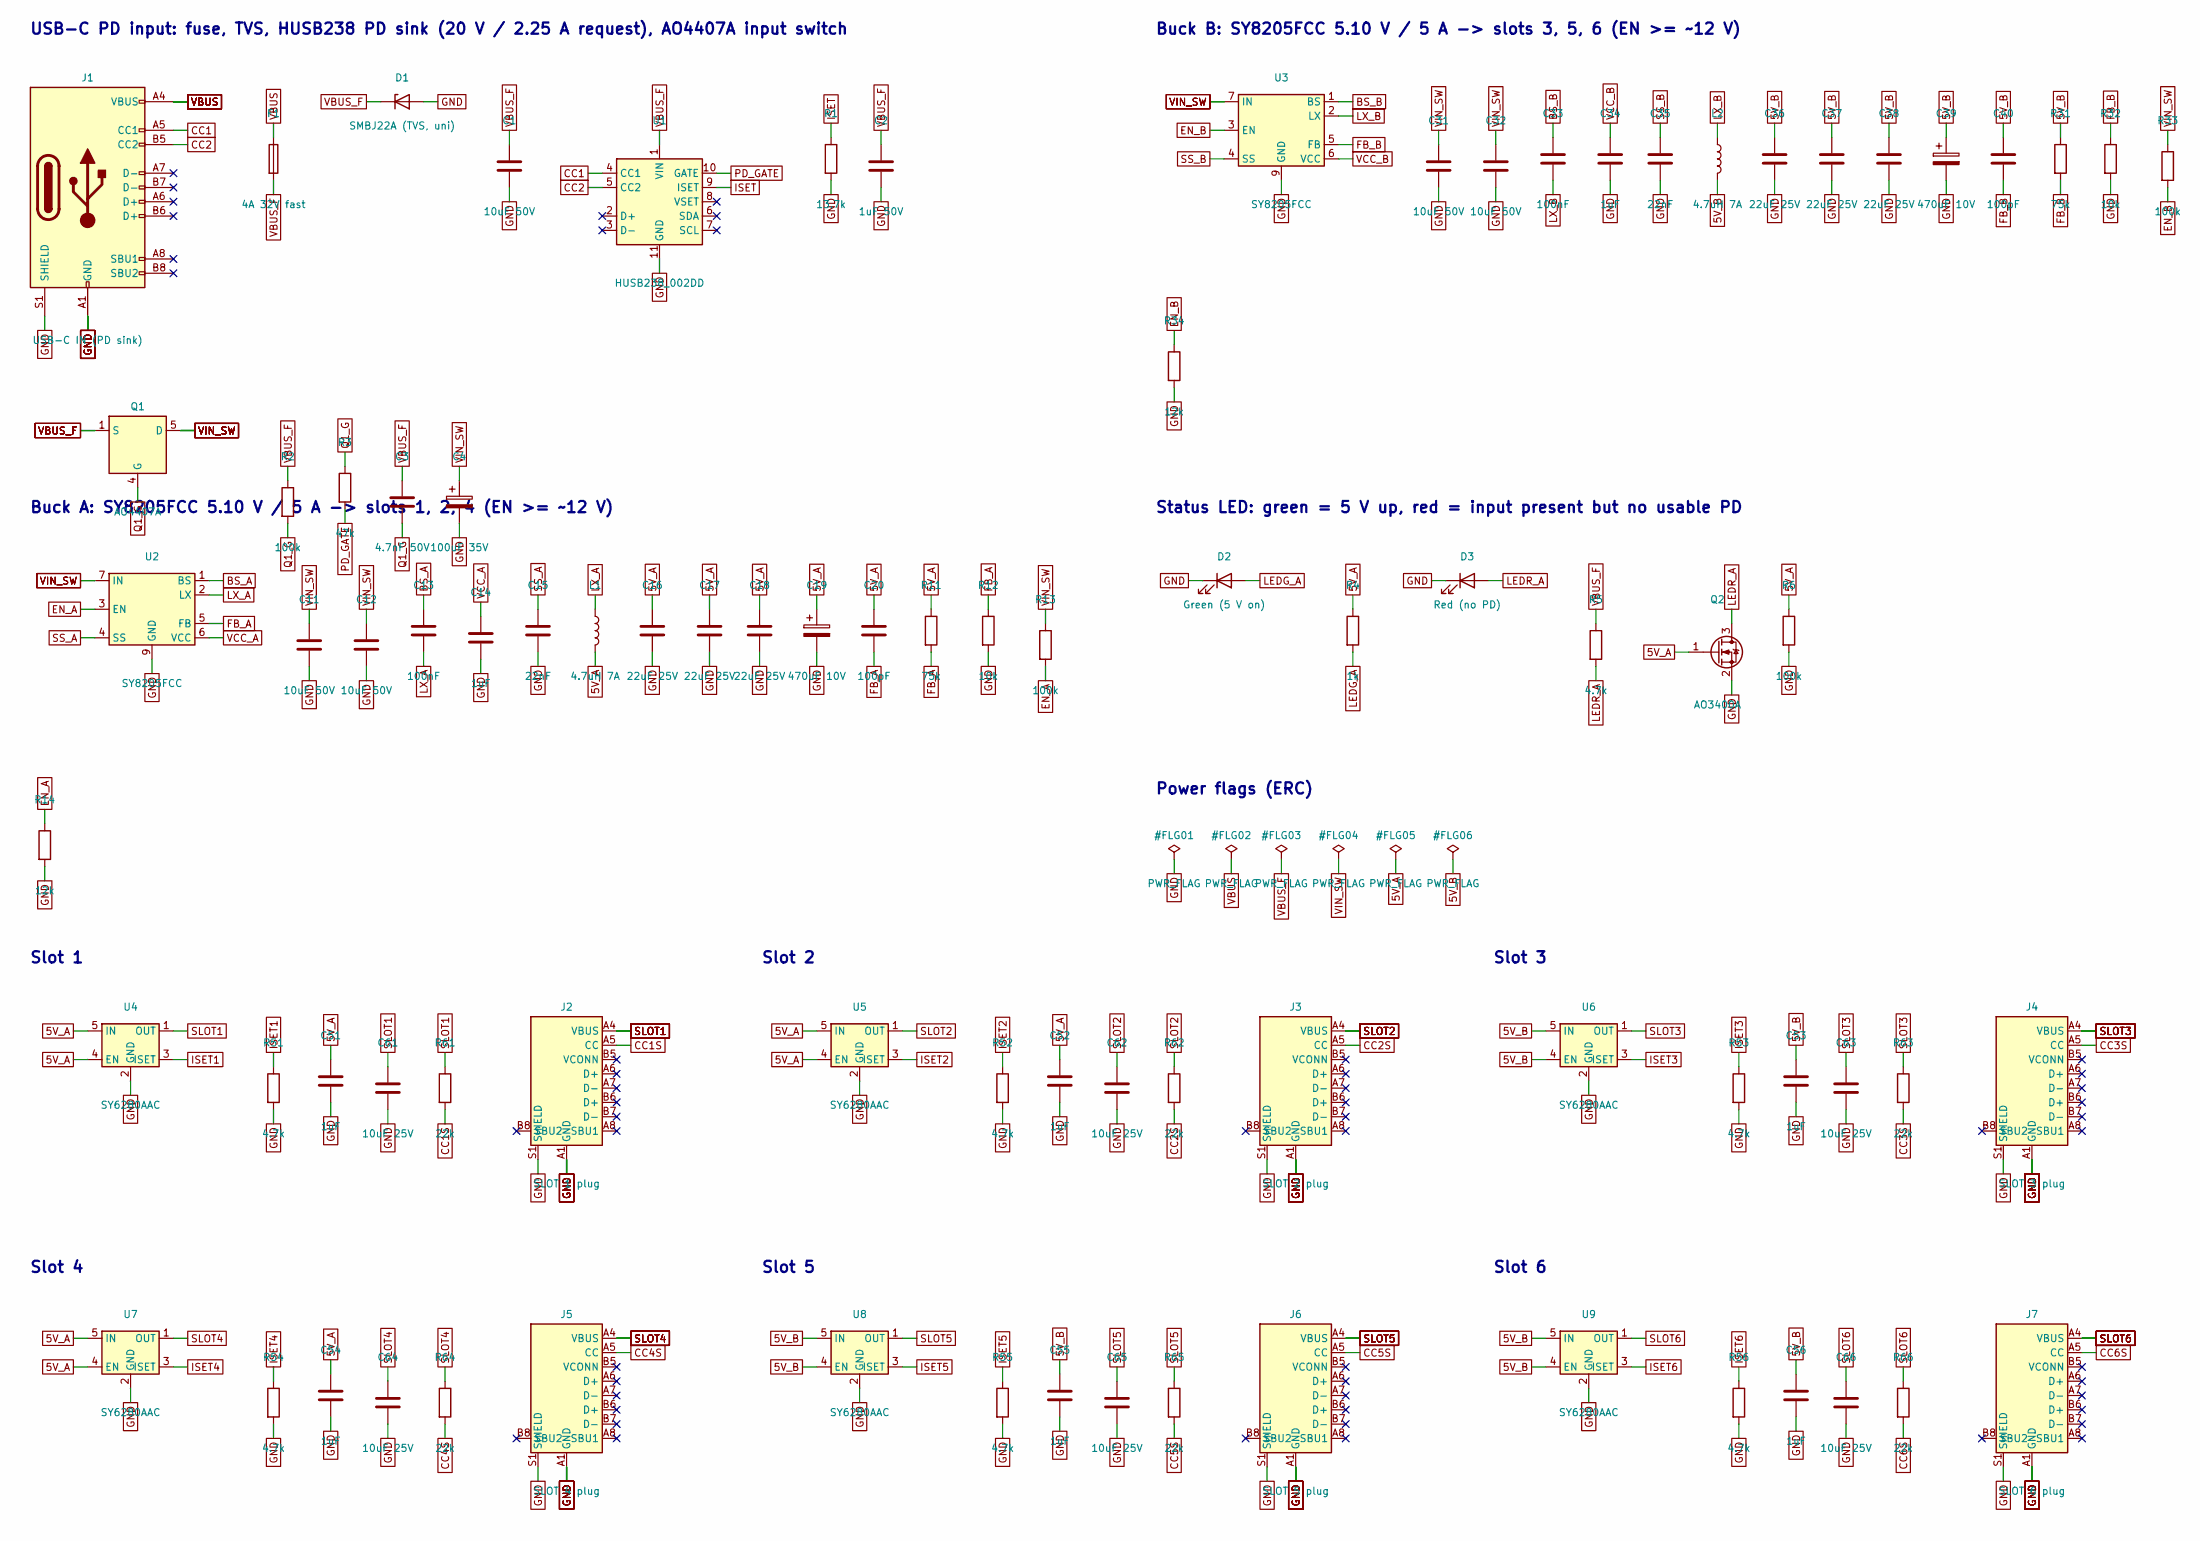
[picture p94: schematic openald-dock.kicad_sch, OpenALD Dock v1.0 - 6-slot USB-C charging dock (PD 20 V in,…]

Parts:
C1, C11, C12, C31, C32: 10uF 50V; C_1206_3216Metric; MPN CL31A106KBHNNNE; LCSC C13585
C2: 1uF 50V; C_0603_1608Metric; MPN CL10A105KB8NNNC; LCSC C15849
C3: 4.7nF 50V; C_0603_1608Metric; MPN 0603B472K500NT; LCSC C53987
C4: 100uF 35V; CP_Elec_8x10; MPN RVE100UF35V67RV0161; LCSC C2895269
C13, C33: 100nF; C_0603_1608Metric; MPN CC0603KRX7R9BB104; LCSC C14663
C14, C34, C51, C52, C53, C54, C55, C56: 1uF; C_0603_1608Metric; MPN CL10A105KB8NNNC; LCSC C15849
C15, C35: 22nF; C_0603_1608Metric; MPN CL10B223KB8NNNC; LCSC C21122
C16, C17, C18, C36, C37, C38: 22uF 25V; C_0805_2012Metric; MPN CL21A226MAQNNNE; LCSC C45783
C19, C39: 470uF 10V; CP_Elec_6.3x7.7; MPN RVT470UF10V67RV0159; LCSC C2858856
C20, C40: 100pF; C_0603_1608Metric; MPN CL10C101JB8NNNC; LCSC C14858
C61, C62, C63, C64, C65, C66: 10uF 25V; C_0805_2012Metric; MPN CL21A106KAYNNNE; LCSC C15850
D1: SMBJ22A (TVS, uni); D_SMB; MPN SMBJ22A; LCSC C151920
D2: Green (5 V on); LED_0603_1608Metric; MPN KT-0603G; LCSC C12624
D3: Red (no PD); LED_0603_1608Metric; MPN KT-0603R; LCSC C2286
F1: 4A 32V fast; Fuse_1206_3216Metric; MPN Littelfuse 0466004.NRHF; LCSC C187596
J1: USB-C IN (PD sink); USB_C_Receptacle_HRO_TYPE-C-31-M-12; MPN HRO TYPE-C-31-M-12; LCSC C165948
J2: SLOT 1 plug; USB_C_Plug_HX_TYPE-C-M-16P_Vertical; MPN HX TYPE C-M 16P V-SMT; LCSC C55200592
J3: SLOT 2 plug; USB_C_Plug_HX_TYPE-C-M-16P_Vertical; MPN HX TYPE C-M 16P V-SMT; LCSC C55200592
J4: SLOT 3 plug; USB_C_Plug_HX_TYPE-C-M-16P_Vertical; MPN HX TYPE C-M 16P V-SMT; LCSC C55200592
J5: SLOT 4 plug; USB_C_Plug_HX_TYPE-C-M-16P_Vertical; MPN HX TYPE C-M 16P V-SMT; LCSC C55200592
J6: SLOT 5 plug; USB_C_Plug_HX_TYPE-C-M-16P_Vertical; MPN HX TYPE C-M 16P V-SMT; LCSC C55200592
J7: SLOT 6 plug; USB_C_Plug_HX_TYPE-C-M-16P_Vertical; MPN HX TYPE C-M 16P V-SMT; LCSC C55200592
L1, L2: 4.7uH 7A; L_Sunlord_MWSA0604S; MPN Sunlord MWSA0604S-4R7MT; LCSC C408457
Q1: AO4407A; SOIC-8_3.9x4.9mm_P1.27mm; MPN AOS AO4407A; LCSC C16072
Q2: AO3400A; SOT-23; MPN AOS AO3400A; LCSC C20917
R1: 13.7k; R_0603_1608Metric; MPN 0603WAF1372T5E; LCSC C22793
R2, R6, R13, R33: 100k; R_0603_1608Metric; MPN 0603WAF1003T5E; LCSC C25803
R3: 47k; R_0603_1608Metric; MPN 0603WAF4702T5E; LCSC C25819
R4: 1k; R_0603_1608Metric; MPN 0603WAF1001T5E; LCSC C21190
R5: 4.7k; R_0805_2012Metric; MPN 0805W8F4701T5E; LCSC C17673
R11, R31: 75k; R_0603_1608Metric; MPN 0603WAF7502T5E; LCSC C23242
R12, R32: 10k; R_0603_1608Metric; MPN 0603WAF1002T5E; LCSC C25804
R14, R34: 12k; R_0603_1608Metric; MPN 0603WAF1202T5E; LCSC C22790
R51, R52, R53, R54, R55, R56: 4.7k; R_0603_1608Metric; MPN 0603WAF4701T5E; LCSC C23162
R61, R62, R63, R64, R65, R66: 22k; R_0603_1608Metric; MPN 0603WAF2202T5E; LCSC C31850
U1: HUSB238_002DD; DFN-10-1EP_3x3mm_P0.5mm_EP1.55x2.48mm; MPN Hynetek HUSB238_002DD; LCSC C7471904
U2, U3: SY8205FCC; SOIC-8-1EP_3.9x4.9mm_P1.27mm_EP2.29x3mm; MPN Silergy SY8205FCC; LCSC C111875
U4, U5, U6, U7, U8, U9: SY6280AAC; SOT-23-5; MPN Silergy SY6280AAC; LCSC C55136

Connections:
5V_A: C16.1, C17.1, C18.1, C19.1, C20.1, C51.1, C52.1, C54.1, L1.2, Q2.1 (G), R4.1, R6.1, R11.1, U4.4 (EN), U4.5 (IN), U5.4 (EN), U5.5 (IN), U7.4 (EN), U7.5 (IN)
5V_B: C36.1, C37.1, C38.1, C39.1, C40.1, C53.1, C55.1, C56.1, L2.2, R31.1, U6.4 (EN), U6.5 (IN), U8.4 (EN), U8.5 (IN), U9.4 (EN), U9.5 (IN)
BS_A: C13.1, U2.1 (BS)
BS_B: C33.1, U3.1 (BS)
CC1: J1.A5 (CC1), U1.4 (CC1)
CC1S: J2.A5 (CC), R61.2
CC2: J1.B5 (CC2), U1.5 (CC2)
CC2S: J3.A5 (CC), R62.2
CC3S: J4.A5 (CC), R63.2
CC4S: J5.A5 (CC), R64.2
CC5S: J6.A5 (CC), R65.2
CC6S: J7.A5 (CC), R66.2
EN_A: R13.2, R14.1, U2.3 (EN)
EN_B: R33.2, R34.1, U3.3 (EN)
FB_A: C20.2, R11.2, R12.1, U2.5 (FB)
FB_B: C40.2, R31.2, R32.1, U3.5 (FB)
GND: C1.2, C2.2, C4.2, C11.2, C12.2, C14.2, C15.2, C16.2, C17.2, C18.2, C19.2, C31.2, C32.2, C34.2, C35.2, C36.2, C37.2, C38.2, C39.2, C51.2, C52.2, C53.2, C54.2, C55.2, C56.2, C61.2, C62.2, C63.2, C64.2, C65.2, C66.2, D1.2 (A), D2.1 (K), D3.1 (K), J1.A1 (GND), J1.A12 (GND), J1.B1 (GND), J1.B12 (GND), J1.S1 (SHIELD), J2.A1 (GND), J2.A12 (GND), J2.B1 (GND), J2.B12 (GND), J2.S1 (SHIELD), J3.A1 (GND), J3.A12 (GND), J3.B1 (GND), J3.B12 (GND), J3.S1 (SHIELD), J4.A1 (GND), J4.A12 (GND), J4.B1 (GND), J4.B12 (GND), J4.S1 (SHIELD), J5.A1 (GND), J5.A12 (GND), J5.B1 (GND), J5.B12 (GND), J5.S1 (SHIELD), J6.A1 (GND), J6.A12 (GND), J6.B1 (GND), J6.B12 (GND), J6.S1 (SHIELD), J7.A1 (GND), J7.A12 (GND), J7.B1 (GND), J7.B12 (GND), J7.S1 (SHIELD), Q2.2 (S), R1.2, R6.2, R12.2, R14.2, R32.2, R34.2, R51.2, R52.2, R53.2, R54.2, R55.2, R56.2, U1.11 (GND), U2.9 (GND), U3.9 (GND), U4.2 (GND), U5.2 (GND), U6.2 (GND), U7.2 (GND), U8.2 (GND), U9.2 (GND)
ISET: R1.1, U1.9 (ISET)
ISET1: R51.1, U4.3 (ISET)
ISET2: R52.1, U5.3 (ISET)
ISET3: R53.1, U6.3 (ISET)
ISET4: R54.1, U7.3 (ISET)
ISET5: R55.1, U8.3 (ISET)
ISET6: R56.1, U9.3 (ISET)
LEDG_A: D2.2 (A), R4.2
LEDR_A: D3.2 (A), Q2.3 (D), R5.2
LX_A: C13.2, L1.1, U2.2 (LX)
LX_B: C33.2, L2.1, U3.2 (LX)
PD_GATE: R3.2, U1.10 (GATE)
Q1_G: C3.2, Q1.4 (G), R2.2, R3.1
SLOT1: C61.1, J2.A4 (VBUS), J2.A9 (VBUS), J2.B4 (VBUS), J2.B9 (VBUS), R61.1, U4.1 (OUT)
SLOT2: C62.1, J3.A4 (VBUS), J3.A9 (VBUS), J3.B4 (VBUS), J3.B9 (VBUS), R62.1, U5.1 (OUT)
SLOT3: C63.1, J4.A4 (VBUS), J4.A9 (VBUS), J4.B4 (VBUS), J4.B9 (VBUS), R63.1, U6.1 (OUT)
SLOT4: C64.1, J5.A4 (VBUS), J5.A9 (VBUS), J5.B4 (VBUS), J5.B9 (VBUS), R64.1, U7.1 (OUT)
SLOT5: C65.1, J6.A4 (VBUS), J6.A9 (VBUS), J6.B4 (VBUS), J6.B9 (VBUS), R65.1, U8.1 (OUT)
SLOT6: C66.1, J7.A4 (VBUS), J7.A9 (VBUS), J7.B4 (VBUS), J7.B9 (VBUS), R66.1, U9.1 (OUT)
SS_A: C15.1, U2.4 (SS)
SS_B: C35.1, U3.4 (SS)
VBUS: F1.1, J1.A4 (VBUS), J1.A9 (VBUS), J1.B4 (VBUS), J1.B9 (VBUS)
VBUS_F: C1.1, C2.1, C3.1, D1.1 (K), F1.2, Q1.1 (S), Q1.2 (S), Q1.3 (S), R2.1, R5.1, U1.1 (VIN)
VCC_A: C14.1, U2.6 (VCC)
VCC_B: C34.1, U3.6 (VCC)
VIN_SW: C4.1, C11.1, C12.1, C31.1, C32.1, Q1.5 (D), Q1.6 (D), Q1.7 (D), Q1.8 (D), R13.1, R33.1, U2.7 (IN), U2.8 (IN), U3.7 (IN), U3.8 (IN)

Notes on the sheet:
USB-C PD input: fuse, TVS, HUSB238 PD sink (20 V / 2.25 A request), AO4407A input switch
Buck A: SY8205FCC 5.10 V / 5 A -> slots 1, 2, 4 (EN >= ~12 V)
Buck B: SY8205FCC 5.10 V / 5 A -> slots 3, 5, 6 (EN >= ~12 V)
Status LED: green = 5 V up, red = input present but no usable PD
Slot 1
Slot 2
Slot 3
Slot 4
Slot 5
Slot 6
Power flags (ERC)

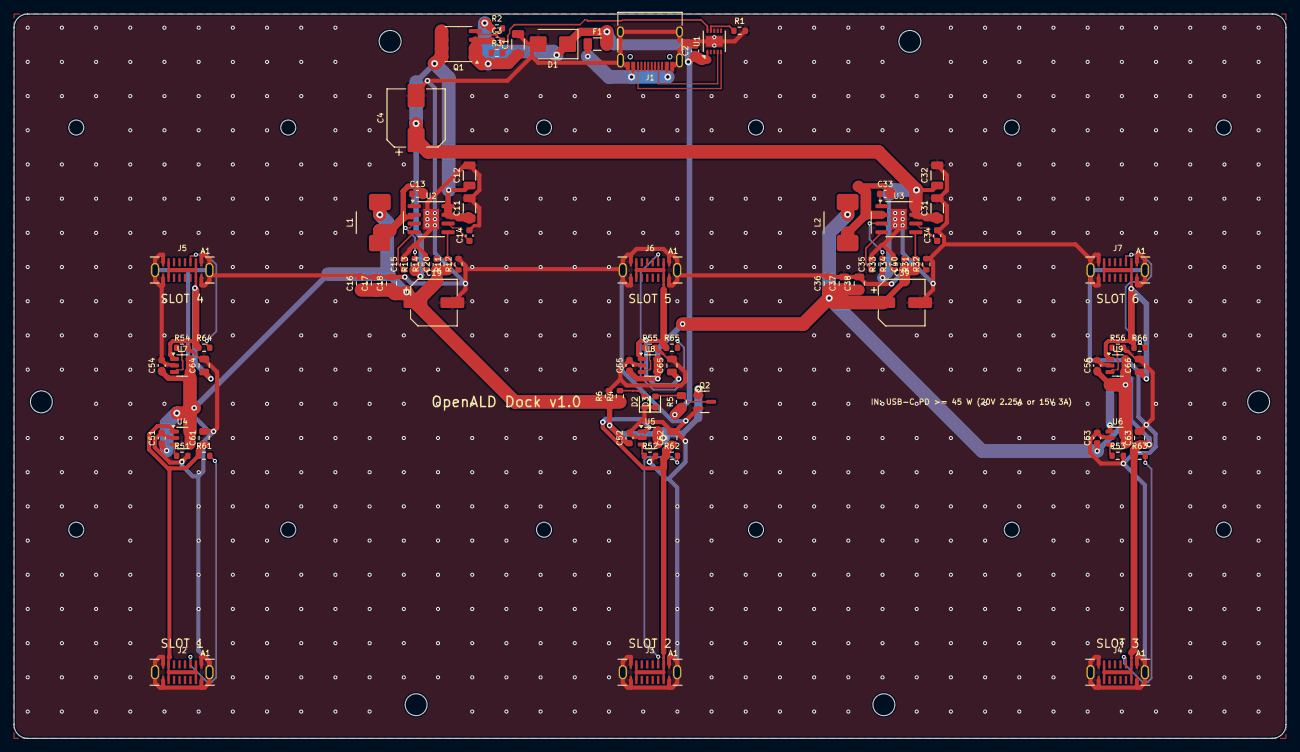
[picture p95: board openald-dock.kicad_pcb from above]

Board: 2 copper layers, 186.0 x 105.9 mm, 104 parts (0 on the bottom side), 43 nets.

Other parts of the board:
H1, H2, H3, H4, H5, H6: M3; MountingHole_3.2mm_M3
H7, H8, H9, H10, H11, H12, H13, H14, H15, H16, H17, H18: peg; MountingHole_2.2mm_M2
