vicholz/openald/radio_adafruit_feather_rp2040/docs/wiring_schematic/openald-feather-wiring.kicad_sch

## KiCad design radio_adafruit_feather_rp2040/docs/wiring_schematic/openald-feather-wiring.kicad_sch (2026-11-13)

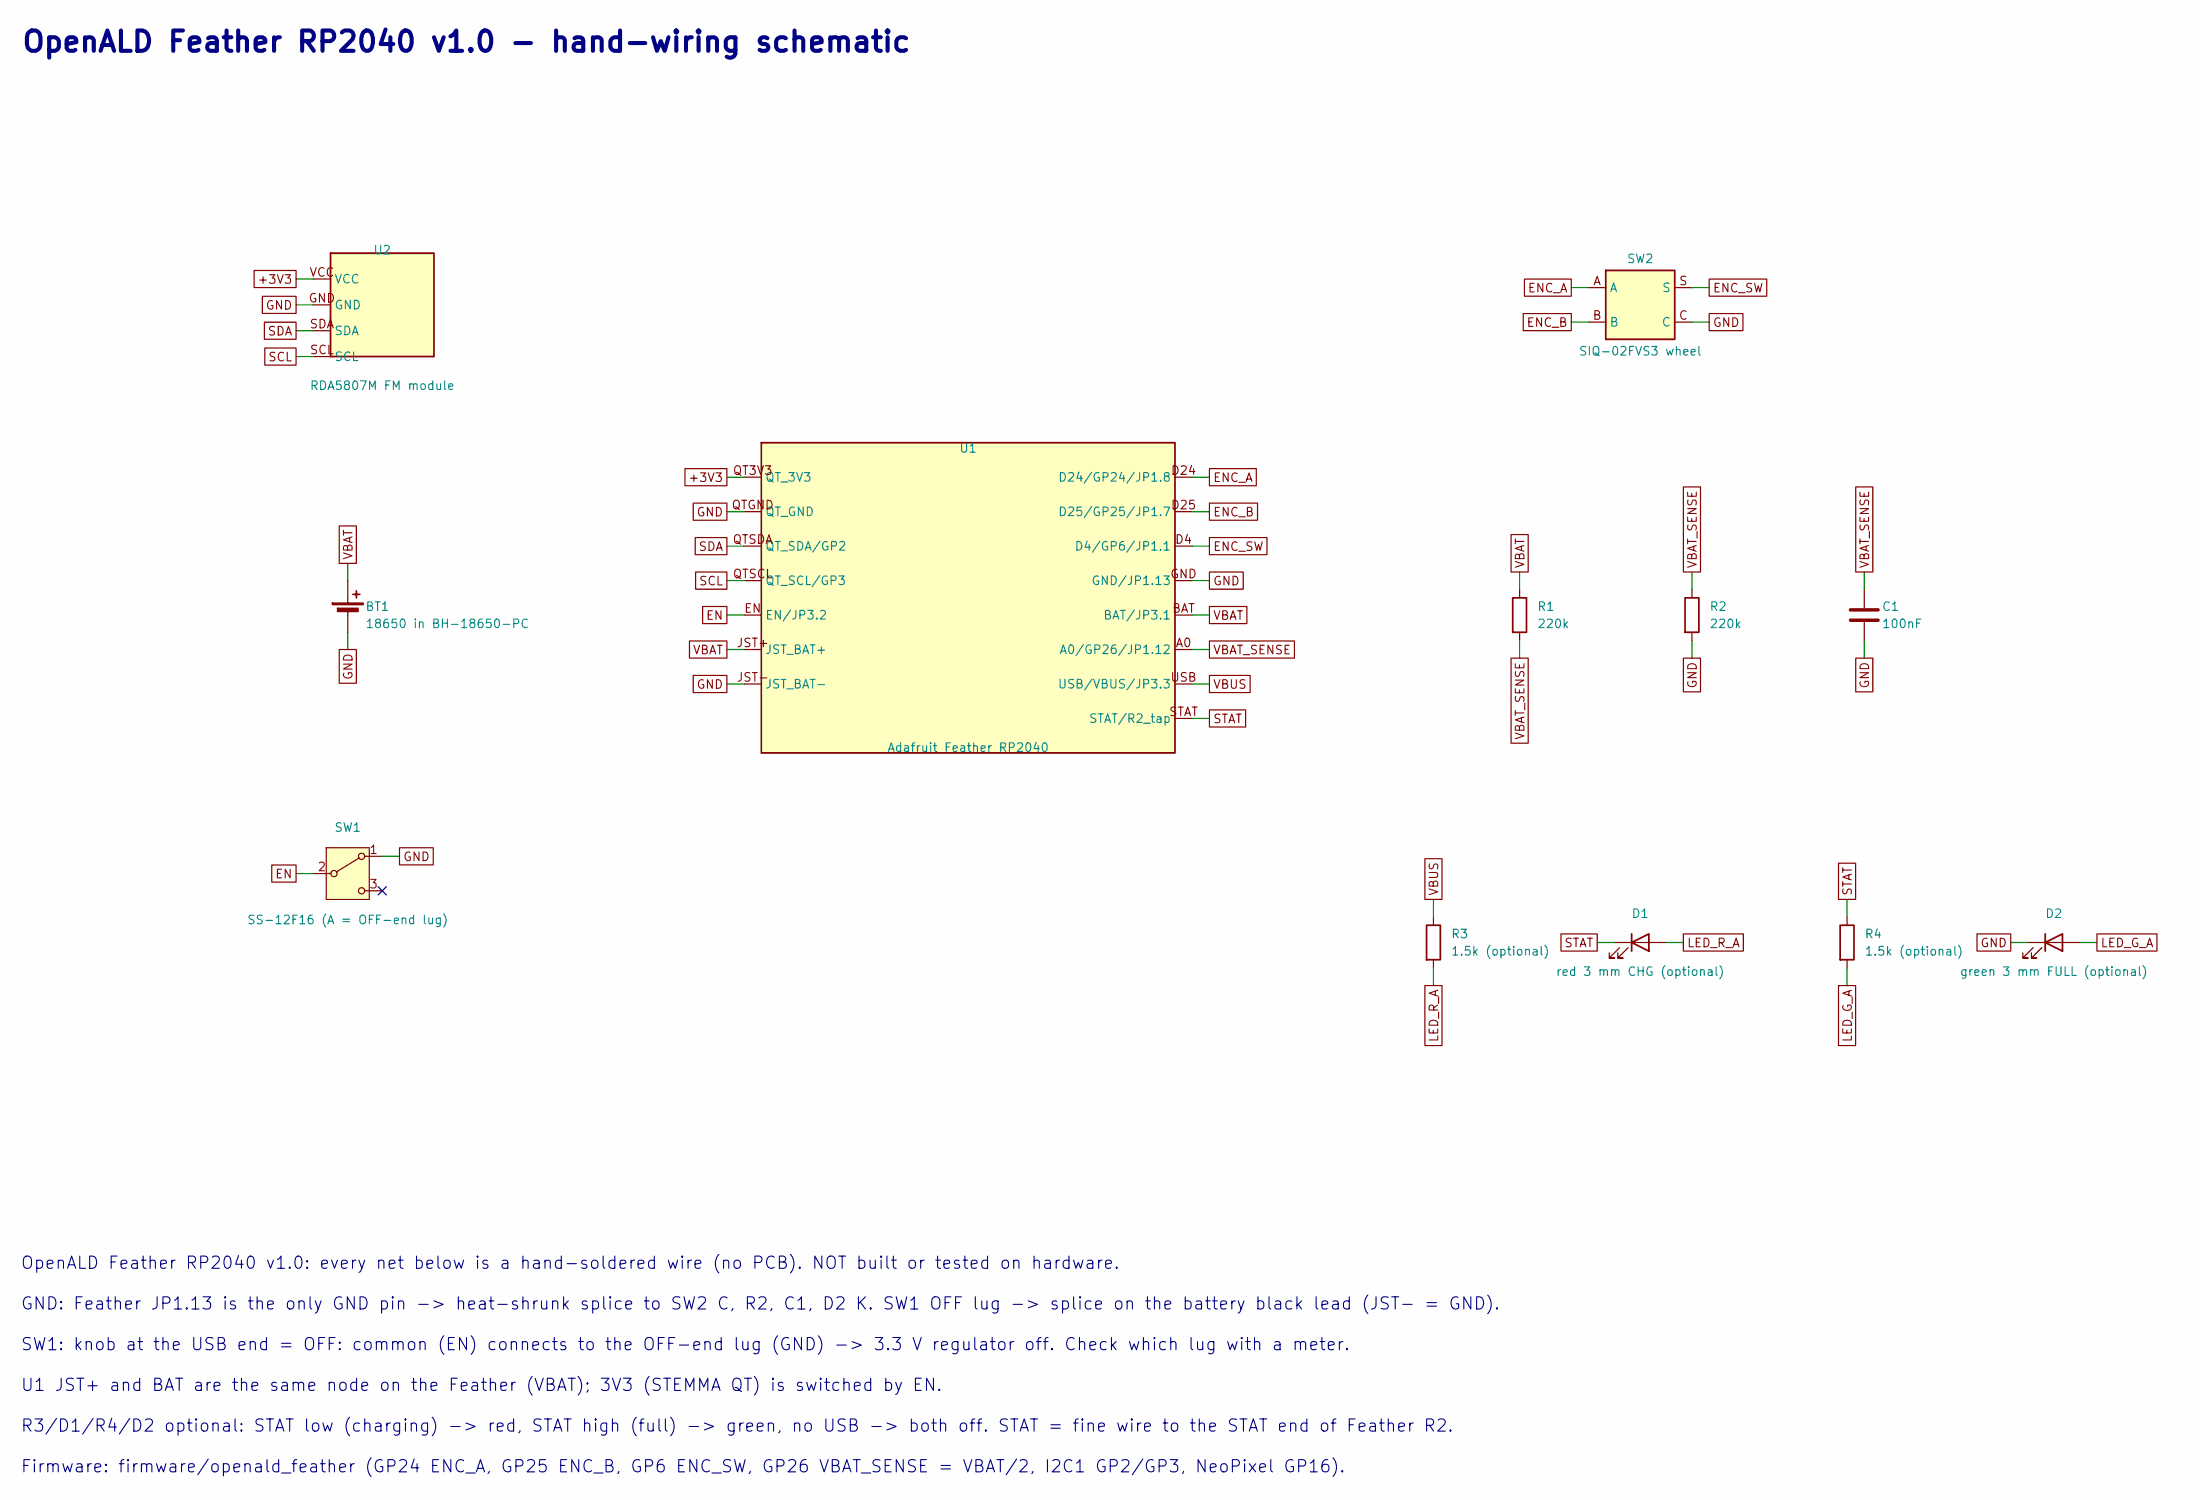
[picture p96: schematic openald-feather-wiring.kicad_sch]

Parts:
BT1: 18650 in BH-18650-PC
C1: 100nF
D1: red 3 mm CHG (optional)
D2: green 3 mm FULL (optional)
R1, R2: 220k
R3, R4: 1.5k (optional)
SW1: SS-12F16 (A = OFF-end lug)
SW2: SIQ-02FVS3 wheel
U1: Adafruit Feather RP2040
U2: RDA5807M FM module

Connections:
+3V3: U1.QT3V3 (QT_3V3), U2.VCC
EN: SW1.2 (B), U1.EN (EN/JP3.2)
ENC_A: SW2.A, U1.D24 (D24/GP24/JP1.8)
ENC_B: SW2.B, U1.D25 (D25/GP25/JP1.7)
ENC_SW: SW2.S, U1.D4 (D4/GP6/JP1.1)
GND: BT1.2 (-), C1.2, D2.1 (K), R2.2, SW1.1 (A), SW2.C, U1.GND (GND/JP1.13), U1.JST- (JST_BAT-), U1.QTGND (QT_GND), U2.GND
LED_G_A: D2.2 (A), R4.2
LED_R_A: D1.2 (A), R3.2
SCL: U1.QTSCL (QT_SCL/GP3), U2.SCL
SDA: U1.QTSDA (QT_SDA/GP2), U2.SDA
STAT: D1.1 (K), R4.1, U1.STAT (STAT/R2_tap)
VBAT: BT1.1 (+), R1.1, U1.BAT (BAT/JP3.1), U1.JST+ (JST_BAT+)
VBAT_SENSE: C1.1, R1.2, R2.1, U1.A0 (A0/GP26/JP1.12)
VBUS: R3.1, U1.USB (USB/VBUS/JP3.3)

Notes on the sheet:
OpenALD Feather RP2040 v1.0: every net below is a hand-soldered wire (no PCB). NOT built or tested on hardware.
GND: Feather JP1.13 is the only GND pin -> heat-shrunk splice to SW2 C, R2, C1, D2 K. SW1 OFF lug -> splice on the battery black lead (JST- = GND).
SW1: knob at the USB end = OFF: common (EN) connects to the OFF-end lug (GND) -> 3.3 V regulator off. Check which lug with a meter.
U1 JST+ and BAT are the same node on the Feather (VBAT); 3V3 (STEMMA QT) is switched by EN.
R3/D1/R4/D2 optional: STAT low (charging) -> red, STAT high (full) -> green, no USB -> both off. STAT = fine wire to the STAT end of Feather R2.
Firmware: firmware/openald_feather (GP24 ENC_A, GP25 ENC_B, GP6 ENC_SW, GP26 VBAT_SENSE = VBAT/2, I2C1 GP2/GP3, NeoPixel GP16).
OpenALD Feather RP2040 v1.0 - hand-wiring schematic
