vicholz/openald/(commit log)

2026-11-12 OpenALD v1.0: single-board radio, Feather RP2040 variant, 6-slot USB-C PD dock
    KiCad 9 + OpenSCAD sources, generated fab outputs (gerbers, JLC BOM/CPL,
    centroid, .pos, PCBWay/NextPCB BOMs, minimal assembly set), STLs, previews,
    schematic PDFs. Adds HANDOFF.md, tools/ (check_all, fetch_kicad3d,
    make_packages, EasyEDA cache), requirements.txt, CC0 1.0 LICENSE.
    Scripts no longer depend on /workspace paths.
    Status: designed and CAD/datasheet-checked; not built or hardware-validated.
    [Adafruit Feather RP2040.brd, BOM.csv, C1002.json, C111875.json, C12624.json, C132230.json, C13585.json, C136720.json]
2026-11-12 tools/fetch_kicad3d.sh: fetch .wrl and .step (kicad-cli --subst-models needs both); note complete fit report
2026-11-12 docs: SIQ-02FVS3 encoder decode, debounce and wake notes with examples
    Paper verification of the Mitsumi thumbwheel on the ATmega328PB board and
    the Feather RP2040 controls board. No hardware changes: netlists, footprint
    and pin maps already matched the datasheet. Adds the missing quadrature
    state-table approach (one step per detent, 1 ms poll), Power-down wake
    guidance (PCINT, not INT0/INT1 level) and MiniCore / Arduino-Pico snippets.
2026-11-12 radio_single_board (still v1.0): wheel press replaces battery-check button SW2; level bar centred and raised
    - Remove SW2 (EVQ-P7A01P, C79167): footprint, 3D model, case hole and printed plunger
    - Wheel push switch S now gates P-FET Q4 AO3401A (C15127) with R25 1M (C22935) pull-up to VBAT;
    Q4 drives VBTN like SW2 did (D2/D10/R6/R7 unchanged), so holding the wheel in with the switch off
    still powers the MCU for the battery check; press read on BTN_SENSE/PC1 (PCINT9), PD4 now spare
    - Wheel mapping: short press = battery check, hold = seek, push-and-turn = tune
    - Level bar D6/D5/D1 moved to the centreline x=19.0 (y 6.1/8.9/14.0), evenly spaced windows
    (D1 tunnel slanted around the holder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
    [button_plunger.stl, case_bottom.stl, case_bottom_nut.stl, case_params.scad, case_top.stl, case_top_nut.stl, openald-BOM-human.csv, openald-BOM-jlcpcb.csv]
2026-11-12 Feather (still v1.0): direct-mount SS-12F16 switch and glued SIQ-02FVS3 wheel; controls PCB retired
    Victor: "add a case frame ... where I can mount a SS-12F16 1P2T G4/G6 switch directly into the case, and glue
    the wheel into. I will solder wires from the wheel and the switch to the feather."
    - Controls PCB (KiCad, fab, generators) moved to radio_adafruit_feather_rp2040/archive/controls_board_pcb/ (unused)
    - SS-12F16 SPDT panel switch (datasheet: plate 19.7 x 5.7 x 0.5, M2 tapped ears 15 apart, body 11 x 5.7 x 5,
    knob 3 x 3, travel 3, L = 4/5/6 for G4/G050/G6): plate in a 0.6 mm pocket on the inside of the right wall
    (bottom half, Y 75, Z -5), 2x M2 x 3 from outside, 6.6 x 3.6 slot, ON/O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
    [BOM.csv, case_bottom.stl, case_params.scad, case_top.stl, frame.stl, openald-feather-controls-BOM-human.csv, openald-feather-controls-BOM-jlcpcb.csv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]
2026-11-12 Feather v1.0: screwless SS-12F16 (left-wall groove) and frame clamped between the case halves
    - switch drops into a 0.7 mm groove (1.2 mm skin, ribs with 0.25 mm crush bumps, body window),
    closed in by the frame tab and a top-half tongue; M2 holes/screws removed from CAD/BOM/docs
    - frame deck has six tabs in parting-line notches under top-half plugs; holder in a 0.2 mm floor
    pocket with a 0.4 mm deck relief (0.7 mm holder-to-deck gap)
    - check_fit: switch drop-in, frame tab insertion and top-half lowering paths, holder gap; PASS 0 interferences
    - nothing printed or tested
    [BOM.csv, case_bottom.stl, case_params.scad, case_top.stl, frame.stl, openald_feather_case.scad]
2026-11-13 Feather v1.0: solid switch backing; Feather 0.9 mm nearer the USB face with a larger cable-plug recess (test-print fixes)
    - SS-12F16: thin ribs replaced by a solid floor-to-deck backing block (side blocks behind the ears,
    2 mm back wall, shelf under the body, lug/wire slot open to the top); drop-in, screwless
    - Feather moved 0.9 mm (FEATHER_DY): receptacle mouth 1.60 mm inside the bottom face, 0.10 mm behind
    the recess floor; recess 13.0 x 7.6 r3 x 1.5 straight-walled + r1.0 face fillet
    - fit check PASS (0 interferences); dock outer envelope unchanged, plug path at least as open; dock plug
    insertion now 6.9 mm (flagged)
    - nothing reprinted or tested yet
    [BOM.csv, case_bottom.stl, case_params.scad, case_top.stl, feather_params.scad, frame.stl, openald_feather_case.scad]
2026-11-13 Dock v1.0: per-radio plug depth - 0.90 mm riser shim for Feather pockets (both radios 6.00 mm insertion vs USB-C seat 6.20+/-0.20); PAD_T, outer size, pocket unchanged
    [dock_params.scad, dock_riser_shim_feather_slot1.stl, dock_riser_shim_feather_slot2.stl, dock_riser_shim_feather_slot3.stl, dock_riser_shim_feather_slot4.stl, dock_riser_shim_feather_slot5.stl, dock_riser_shim_feather_slot6.stl, dock_riser_shims_feather_x6.stl]
2026-11-13 Single board: USB-C mouth 1.60 mm like the Feather (J1 +0.9 mm, re-routed), straight cable-plug recess, assembly notches/tabs; Feather top-half USB notch; dock pads 4.0 / standoffs 4.1, riser shims r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
    [case_bottom.stl, case_bottom_nut.stl, case_params.scad, case_top.stl, case_top_nut.stl, dock_base.stl, dock_floor_pad_slot1.stl, dock_floor_pad_slot2.stl]
2026-11-13 Feather v1.0: flat frame deck over the 18650 holder (no underside relief) with an engraved 0.9 x 0.4 mm holder outline + '+' mark (print feedback: shallow recess printed stringy); holder gap 0.3 mm; 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
    [case_params.scad, frame.stl, openald_feather_case.scad]
2026-11-13 Feather v1.0: Arduino firmware (arduino-pico): wheel volume/tune/seek, NeoPixel battery level, RDA5807M driver, flash-saved station; compiles, untested on hardware; fix D4=GPIO6 in firmware_notes
    [openald_feather.ino, rda5807m.h]
2026-11-13 Feather v1.0: redrawn wiring diagram (SVG/PNG, every hand-soldered wire), KiCad wiring schematic (ERC 0/0, PDF), firmware pin table; check_all runs Feather ERC + firmware compile; docs
    [openald-feather-wiring.kicad_sch]
2026-11-13 Feather v1.0 firmware: NeoPixel shows the battery level 5 s at power-on and 3 s on a short press, off at all other times (seek/error/low-battery blinks removed); rebuilt .uf2; docs
    [openald_feather.ino]
